ksmonkey123/8bit_computer/8bit_computer_notes/Special Registers.md

| Address  | Function |
| --- | --- |
| `0x5000` | Interrupt signals devices 1-8  |
| `0x5001` | Interrupt signals devices 9-16 |
| `0x5002` | Interrupt masks devices 1-8 |
| `0x5003` | Interrupt masks devices 9-16 |
