ksmonkey123/8bit_computer/8bit_computer_notes/Halt Flag.md

The _Halt Flag_ $F_H$ is a special [[Status Flag]] flag in the [[Step Sequencer]] that is set during the write cycle when indicated by the current [[Action Selector]].

It suspends the [[Main Clock]] and can only be cleared by a full [[System Reset]].
