ksmonkey123/8bit_computer/8bit_computer_notes/Physical 16-Bit Register Control Bus.md

The physical bus controlling the operation of the 16-bit registers.

| Pin | Function |
| ----: | --- |
| 1 | $\overline{readPC_L}$ |
| 2 | $\overline{readPC_H}$ |
| 3 | $\overline{readSP_L}$ |
| 4 | $\overline{readSP_H}$ |
| 5 | $\overline{readPC}$ |
| 6 | $\overline{readSP}$ |
| 7 | $writePC$ |
| 8 | $writeSP$ |
| 9 | $\overline{readIncR}$ |
| 10 | [[Increment Unit]] decrement mode |
| 11 | [[Increment Unit]] offset mode |
| 12 | $writeIPC$ |
| 13 | $\overline{readIPC_L}$ |
| 14 | $\overline{readIPC_H}$ |
| 15-16 | N/C |
