ksmonkey123/8bit_computer/8bit_computer_notes/Physical 8-Bit Register Control Bus.md

The physical bus controlling operation of the 1-byte registers.

| Pin | Function |
| ---:| --- |
| 1 | $\overline{readA}$ |
| 2 | $\overline{readB}$ |
| 3 | $\overline{readC}$ |
| 4 | $\overline{readD}$ |
| 5 | $\overline{readL_1}$ |
| 6 | $\overline{readL_2}$ |
| 7 | $writeA$ |
| 8 | $writeB$ |
| 9 | $writeC$ |
| 10  | $writeD$ |
| 11  | $writeL_1$ |
| 12  | $writeL_2$ |
| 13  | $\overline{adrCD}$ |
| 14  | $\overline{adrL}$  |
| 15,16| N/C |
