ksmonkey123/8bit_computer/8bit_computer_notes/Program Counter.md

The program counter is a special 16-bit register on the [[Address Bus]]. It is referenced as $PC$.

It is used to hold the memory address of the next [[Instruction]].

Both 8-bit halves of the program counter can be read on the [[Data Bus]].
In this case the lower half is referenced as $PC_L$. The upper half is called $PC_H$.

>[!important]
>Upon [[System Reset]], the program counter **must** be reset to 0
