ksmonkey123/8bit_computer/8bit_computer_notes/Status Flag.md

A status flag is a 1-bit value providing some limited information about the status of the system. This information can also influence the behaviour of some [[Instruction|Instructions]].

The computer contains 4 status flags:
* $F_C$ [[Carry Flag]]
* $F_Z$ [[Sign Flags|Zero Flag]]
* $F_S$ [[Sign Flags|Sign Flag]] (Also called _minus flag_)
* $F_H$ [[Halt Flag]]

The flags cannot be manually updated nor explicitly read as register values. They are only accessible by the [[Instruction Decoder]] (and in the case of the carry flag to the [[ALU]]).
