ksmonkey123/8bit_computer/instruction set map.xlsx

 | 0 | 1 | 2 | 3 | 4 | 5 | 6 | 7 | 8 | 9 | a | b | c | d | e | f
0 | ADC B | AND B | XOR B | DEC A | RLC |  | MOV A A | MOV A (i16) | MOV (i16) A | MOV AB AB |  | BCC i16 |  |  |  | *INTERRUPT
1 | ADC C | AND C | XOR C | DEC B | RLD |  | MOV A B | MOV B (i16) | MOV (i16) B | MOV AB CD |  | BCS i16 |  |  |  | EXINT
2 | ADC D | AND D | XOR D | DEC C | RRC |  | MOV A C | MOV C (i16) | MOV (i16) C | MOV CD AB |  | BEZ i16 |  |  |  | NOINT
3 | ADC i8 | AND i8 | XOR i8 | DEC D | RRD |  | MOV A D | MOV D (i16) | MOV (i16) D | MOV CD CD |  | BNZ i16 |  |  |  | ENINT
4 | ADC (i16) | AND (i16) | XOR (i16) | INC A | RRA |  | MOV B A | MOV A (CD + i8) | MOV (CD + i8) A | MOV AB (i16) |  | BLZ i16 |  |  |  | SIV
5 | ADC (CD + i8) | AND (CD + i8) | XOR (CD + i8) | INC B |  |  | MOV B B | MOV B (CD + i8) | MOV (CD + i8) B | MOV CD (i16) |  | BGZ i16
6 | ADC (SP + i8) | AND (SP + i8) | XOR (SP + i8) | INC C |  |  | MOV B C | MOV C (CD + i8) | MOV (CD + i8) C | MOV AB (CD + i8) |  | BNP i16
7 |  |  |  | INC D |  |  | MOV B D | MOV D (CD + i8) | MOV (CD + i8) D | MOV CD (CD + i8) |  | BNN i16
8 | SBC B | IOR B | CMP B | NEG A | SWP B |  | MOV C A | MOV A (SP + i8) | MOV (SP + i8) A | MOV AB (SP + i8) |  | JMP i16
9 | SBC C | IOR C | CMP C | NEG B | SWP C |  | MOV C B | MOV B (SP + i8) | MOV (SP + i8) B | MOV CD (SP + i8)
a | SBC D | IOR D | CMP D | NEG C | SWP D |  | MOV C C | MOV C (SP + i8) | MOV (SP + i8) C | MOV AB i16 |  | JSR i16
b | SBC i8 | IOR i8 | CMP i8 | NEG D | SWP (i16) |  | MOV C D | MOV D (SP + i8) | MOV (SP + i8) D | MOV CD i16 |  | RET
c | SBC (i16) | IOR (i16) | CMP (i16) | NOT A | SWP (CD + i8) |  | MOV D A | MOV A i8 | MOV (i16) AB | MOV (CD + i8) AB |  |  |  |  |  | CFC
d | SBC (CD + i8) | IOR (CD + i8) | CMP (CD + i8) | NOT B | SWP (SP + i8) |  | MOV D B | MOV B i8 | MOV (i16) CD | MOV (CD + i8) CD |  |  |  |  |  | CFS
e | SBC (SP + i8) | IOR (SP + i8) | CMP (SP + i8) | NOT C |  |  | MOV D C | MOV C i8 | SPA i8 | MOV (SP + i8) AB |  |  |  |  |  | NOP
f |  |  |  | NOT D |  |  | MOV D D | MOV D i8 | SPF i8 | MOV (SP + i8) CD |  |  |  |  |  | HLT
