ksmonkey123/8bit_computer/8bit_computer_notes/Instruction Decoder.md

The _Instruction Decoder_ is responsible for accepting [[Microcode]] parameters and converting them into dedicated physical control lines.

This also includes making sure, that write commands are only sent when the [[Main Clock]] is high.

#stub
