ksmonkey123/8bit_computer/8bit_computer_notes/Instruction Register.md

The _Instruction Register_ ($IR$) is a special 8-bit register.

It can be written to from the [[Data Bus]] only through dedicated control signals from the [[Step Sequencer]].

It is written to during step 0 of the [[Execution Cycle]].

The value of the register is passed to the [[Microcode#Microcode ROM|Microcode ROM]].

>[!Important]
>
>Writes to the instruction register should be double buffered to ensure that the microcode ROM addressing only changes at the transition between steps.
