ksmonkey123/8bit_computer/(list of files, drawings)

Other design files:
pc_simulation.circ
sequencer_test.circ
