ksmonkey123/8bit_computer/circuits/pc-12_sequencer/sequencer.kicad_pcb

## KiCad design circuits/pc-12_sequencer/sequencer.kicad_pcb (2025-11-24)

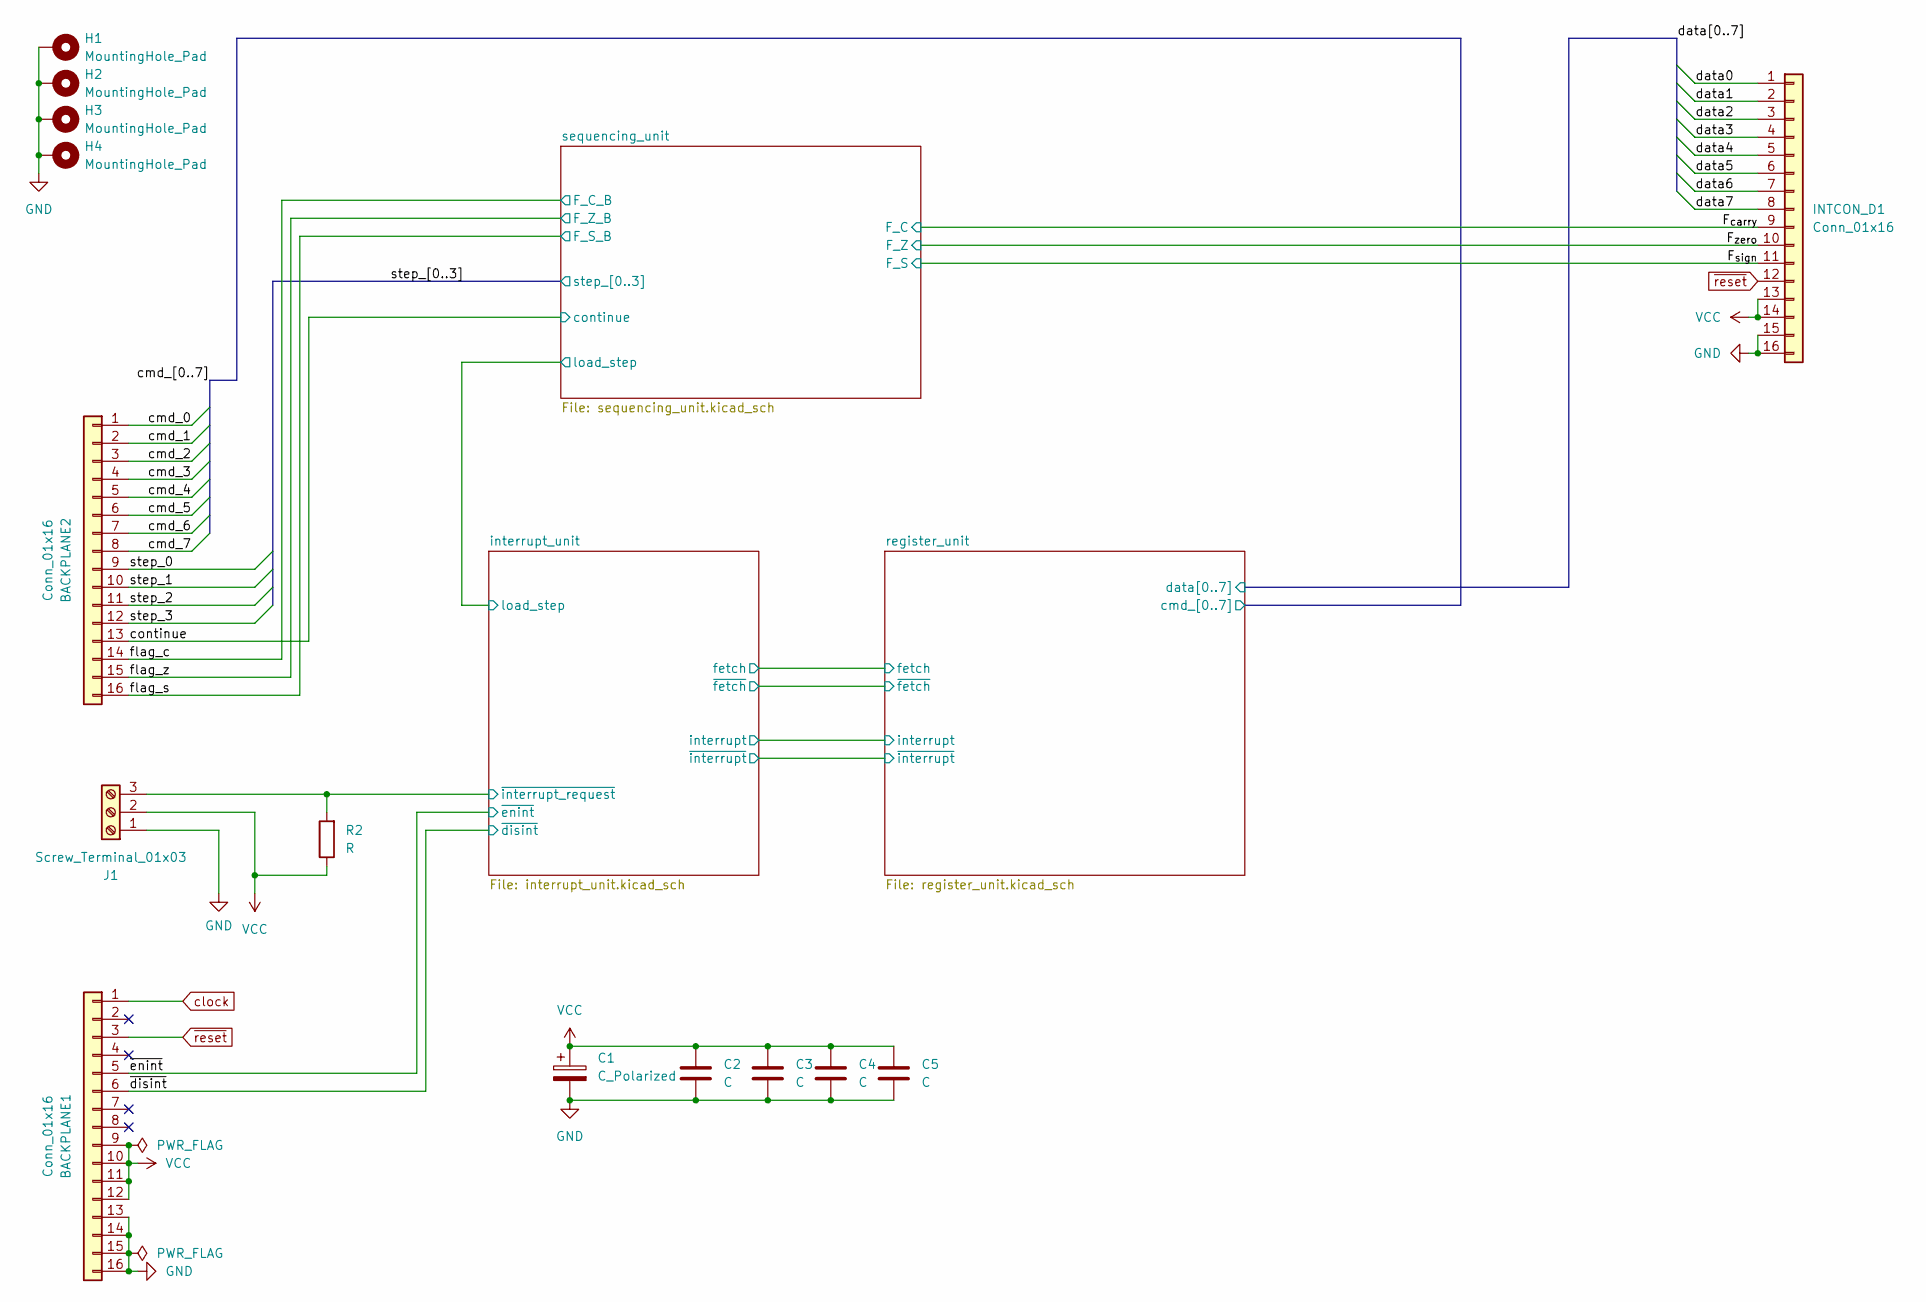
[picture p1: schematic sequencer.kicad_sch, PC-12 Sequencer and Instruction Register]

Parts:
BACKPLANE1, BACKPLANE2: Conn_01x16; IDC-Header_2x08_P2.54mm_Horizontal
C1: C_Polarized; CP_Elec_5x5.3
C2, C3, C4, C5: C; C_0603_1608Metric
H1, H2, H3, H4: MountingHole_Pad; MountingHole_3.2mm_M3_Pad_Via
INTCON_D1: Conn_01x16; IDC-Header_2x08_P2.54mm_Horizontal
J1: Screw_Terminal_01x03; TerminalBlock_Xinya_XY308-2.54-3P_1x03_P2.54mm_Horizontal
R2: R; R_0603_1608Metric

Connections:
/F_{carry}: INTCON_D1.9; also elsewhere on the board
/F_{sign}: INTCON_D1.11; also elsewhere on the board
/F_{zero}: INTCON_D1.10; also elsewhere on the board
/cmd_0: BACKPLANE2.1; also elsewhere on the board
/cmd_1: BACKPLANE2.2; also elsewhere on the board
/cmd_2: BACKPLANE2.3; also elsewhere on the board
/cmd_3: BACKPLANE2.4; also elsewhere on the board
/cmd_4: BACKPLANE2.5; also elsewhere on the board
/cmd_5: BACKPLANE2.6; also elsewhere on the board
/cmd_6: BACKPLANE2.7; also elsewhere on the board
/cmd_7: BACKPLANE2.8; also elsewhere on the board
/continue: BACKPLANE2.13; also elsewhere on the board
/data0: INTCON_D1.1; also elsewhere on the board
/data1: INTCON_D1.2; also elsewhere on the board
/data2: INTCON_D1.3; also elsewhere on the board
/data3: INTCON_D1.4; also elsewhere on the board
/data4: INTCON_D1.5; also elsewhere on the board
/data5: INTCON_D1.6; also elsewhere on the board
/data6: INTCON_D1.7; also elsewhere on the board
/data7: INTCON_D1.8; also elsewhere on the board
/flag_c: BACKPLANE2.14; also elsewhere on the board
/flag_s: BACKPLANE2.16; also elsewhere on the board
/flag_z: BACKPLANE2.15; also elsewhere on the board
/interrupt_unit/~interrupt_request: J1.3, R2.2; also elsewhere on the board
/step_0: BACKPLANE2.9; also elsewhere on the board
/step_1: BACKPLANE2.10; also elsewhere on the board
/step_2: BACKPLANE2.11; also elsewhere on the board
/step_3: BACKPLANE2.12; also elsewhere on the board
/~disint: BACKPLANE1.6; also elsewhere on the board
/~enint: BACKPLANE1.5; also elsewhere on the board
GND: BACKPLANE1.13, BACKPLANE1.14, BACKPLANE1.15, BACKPLANE1.16, C1.2, C2.2, C3.2, C4.2, C5.2, H1.1, H2.1, H3.1, H4.1, INTCON_D1.15, INTCON_D1.16, J1.1; also elsewhere on the board
VCC: BACKPLANE1.9, BACKPLANE1.10, BACKPLANE1.11, BACKPLANE1.12, C1.1, C2.1, C3.1, C4.1, C5.1, INTCON_D1.13, INTCON_D1.14, J1.2, R2.1; also elsewhere on the board
clock: BACKPLANE1.1; also elsewhere on the board
~reset: BACKPLANE1.3, INTCON_D1.12; also elsewhere on the board

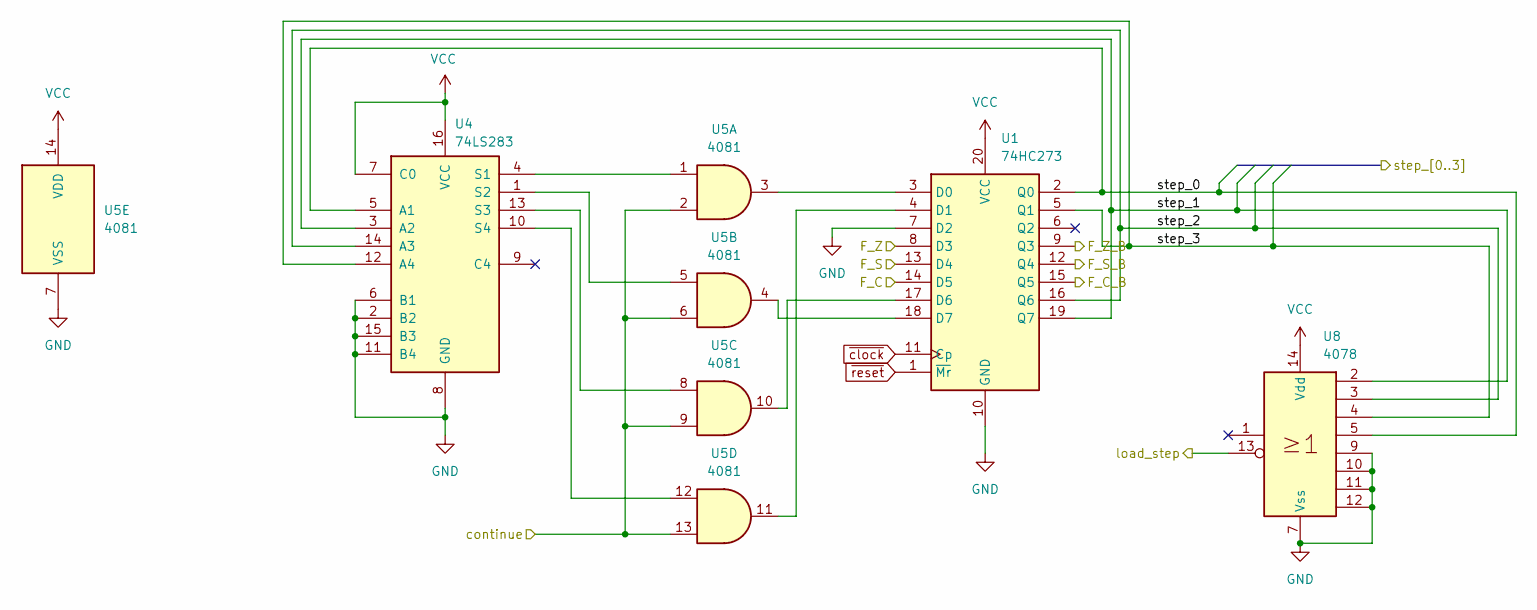
[picture p2: schematic sequencing_unit.kicad_sch, PC-12 Sequencer and Instruction Register]

Parts:
U1: 74HC273; DIP-20_W7.62mm
U4: 74LS283; DIP-16_W7.62mm
U5: 4081; DIP-14_W7.62mm
U8: 4078; DIP-14_W7.62mm

Connections:
/F_{carry}: U1.14 (D5); also elsewhere on the board
/F_{sign}: U1.13 (D4); also elsewhere on the board
/F_{zero}: U1.8 (D3); also elsewhere on the board
/continue: U5.2, U5.6, U5.9, U5.13; also elsewhere on the board
/flag_c: U1.15 (Q5); also elsewhere on the board
/flag_s: U1.12 (Q4); also elsewhere on the board
/flag_z: U1.9 (Q3); also elsewhere on the board
/interrupt_unit/load_step: U8.13; also elsewhere on the board
/step_0: U1.2 (Q0), U4.5 (A1), U8.5; also elsewhere on the board
/step_1: U1.19 (Q7), U4.3 (A2), U8.2; also elsewhere on the board
/step_2: U1.16 (Q6), U4.14 (A3), U8.3; also elsewhere on the board
/step_3: U1.5 (Q1), U4.12 (A4), U8.4; also elsewhere on the board
GND: U1.7 (D2), U1.10 (GND), U4.2 (B2), U4.6 (B1), U4.8 (GND), U4.11 (B4), U4.15 (B3), U5.7 (VSS), U8.7 (Vss), U8.9, U8.10, U8.11, U8.12; also elsewhere on the board
unnamed: U1.3 (D0), U5.3
unnamed: U1.4 (D1), U5.11
unnamed: U1.17 (D6), U5.10
unnamed: U1.18 (D7), U5.4
unnamed: U4.4 (S1), U5.1
unnamed: U4.1 (S2), U5.5
unnamed: U4.13 (S3), U5.8
unnamed: U4.10 (S4), U5.12
VCC: U1.20 (VCC), U4.7 (C0), U4.16 (VCC), U5.14 (VDD), U8.14 (Vdd); also elsewhere on the board
~clock: U1.11 (Cp); also elsewhere on the board
~reset: U1.1 (~Mr); also elsewhere on the board

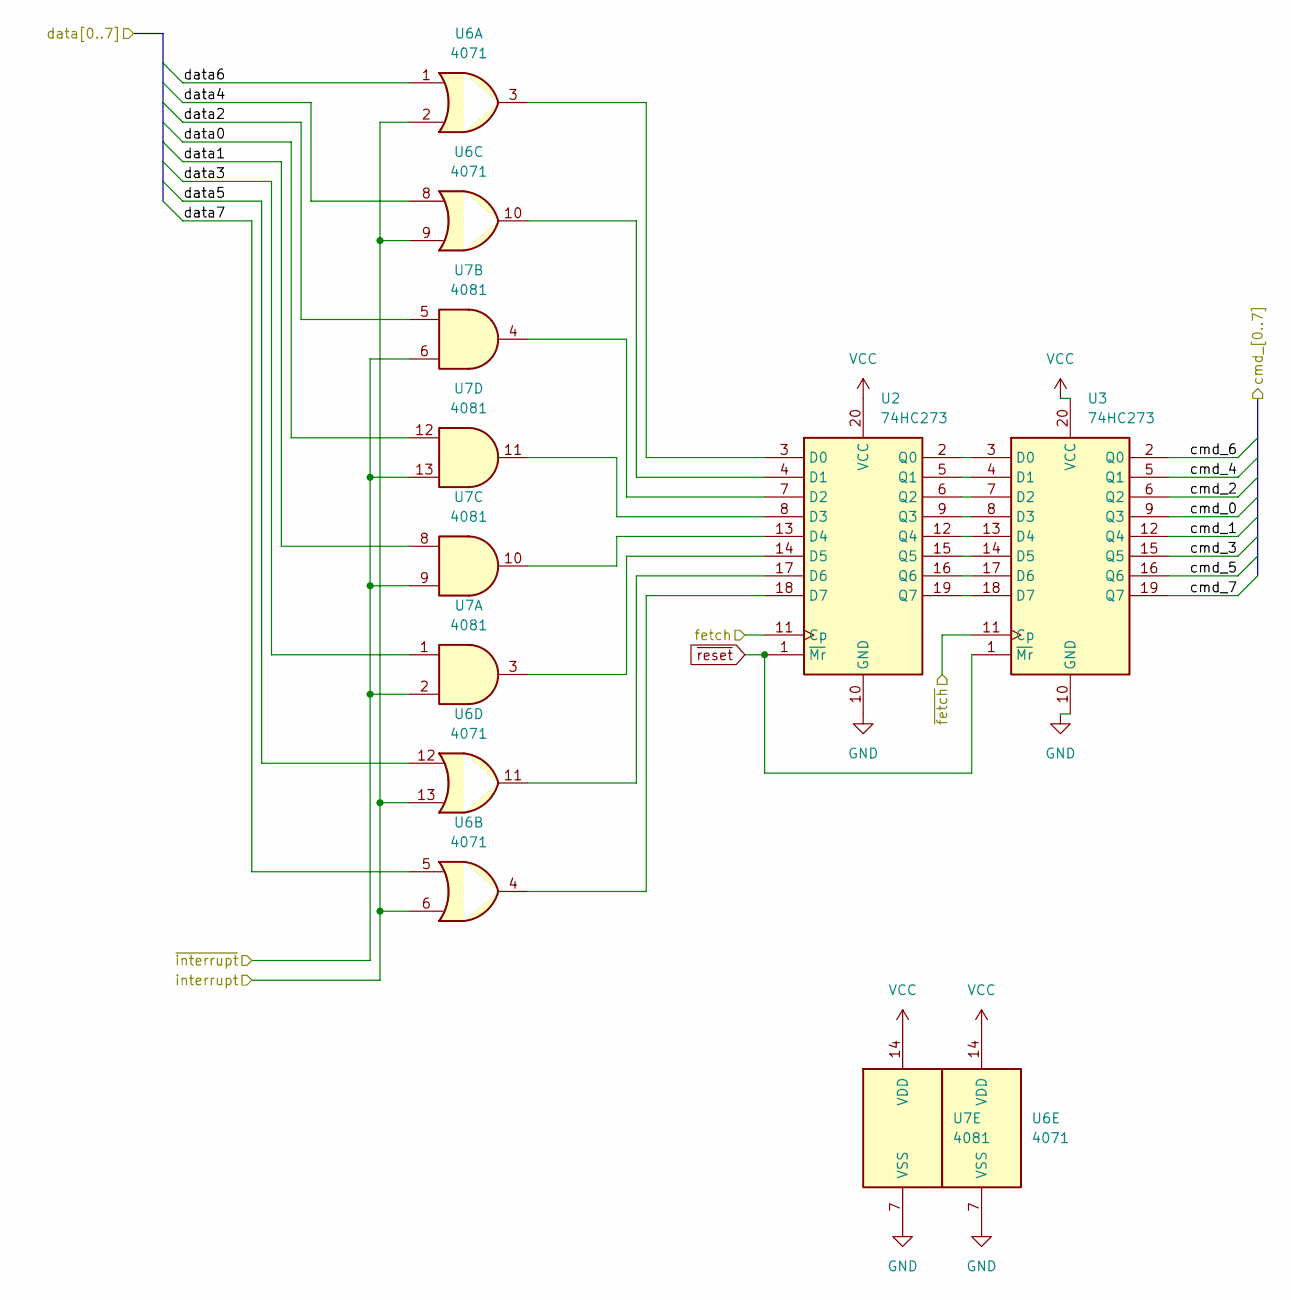
[picture p3: schematic register_unit.kicad_sch, PC-12 Sequencer and Instruction Register]

Parts:
U2, U3: 74HC273; DIP-20_W7.62mm
U6: 4071; DIP-14_W7.62mm
U7: 4081; DIP-14_W7.62mm

Connections:
/cmd_0: U3.9 (Q3); also elsewhere on the board
/cmd_1: U3.12 (Q4); also elsewhere on the board
/cmd_2: U3.6 (Q2); also elsewhere on the board
/cmd_3: U3.15 (Q5); also elsewhere on the board
/cmd_4: U3.5 (Q1); also elsewhere on the board
/cmd_5: U3.16 (Q6); also elsewhere on the board
/cmd_6: U3.2 (Q0); also elsewhere on the board
/cmd_7: U3.19 (Q7); also elsewhere on the board
/data0: U7.12; also elsewhere on the board
/data1: U7.8; also elsewhere on the board
/data2: U7.5; also elsewhere on the board
/data3: U7.1; also elsewhere on the board
/data4: U6.8; also elsewhere on the board
/data5: U6.12; also elsewhere on the board
/data6: U6.1; also elsewhere on the board
/data7: U6.5; also elsewhere on the board
/interrupt_unit/fetch: U2.11 (Cp); also elsewhere on the board
/interrupt_unit/interrupt: U6.2, U6.6, U6.9, U6.13; also elsewhere on the board
/interrupt_unit/~fetch: U3.11 (Cp); also elsewhere on the board
/interrupt_unit/~interrupt: U7.2, U7.6, U7.9, U7.13; also elsewhere on the board
GND: U2.10 (GND), U3.10 (GND), U6.7 (VSS), U7.7 (VSS); also elsewhere on the board
unnamed: U2.3 (D0), U6.3
unnamed: U2.4 (D1), U6.10
unnamed: U2.7 (D2), U7.4
unnamed: U2.8 (D3), U7.11
unnamed: U2.13 (D4), U7.10
unnamed: U2.14 (D5), U7.3
unnamed: U2.17 (D6), U6.11
unnamed: U2.18 (D7), U6.4
unnamed: U2.2 (Q0), U3.3 (D0)
unnamed: U2.5 (Q1), U3.4 (D1)
unnamed: U2.6 (Q2), U3.7 (D2)
unnamed: U2.9 (Q3), U3.8 (D3)
unnamed: U2.12 (Q4), U3.13 (D4)
unnamed: U2.15 (Q5), U3.14 (D5)
unnamed: U2.16 (Q6), U3.17 (D6)
unnamed: U2.19 (Q7), U3.18 (D7)
VCC: U2.20 (VCC), U3.20 (VCC), U6.14 (VDD), U7.14 (VDD); also elsewhere on the board
~reset: U2.1 (~Mr), U3.1 (~Mr); also elsewhere on the board

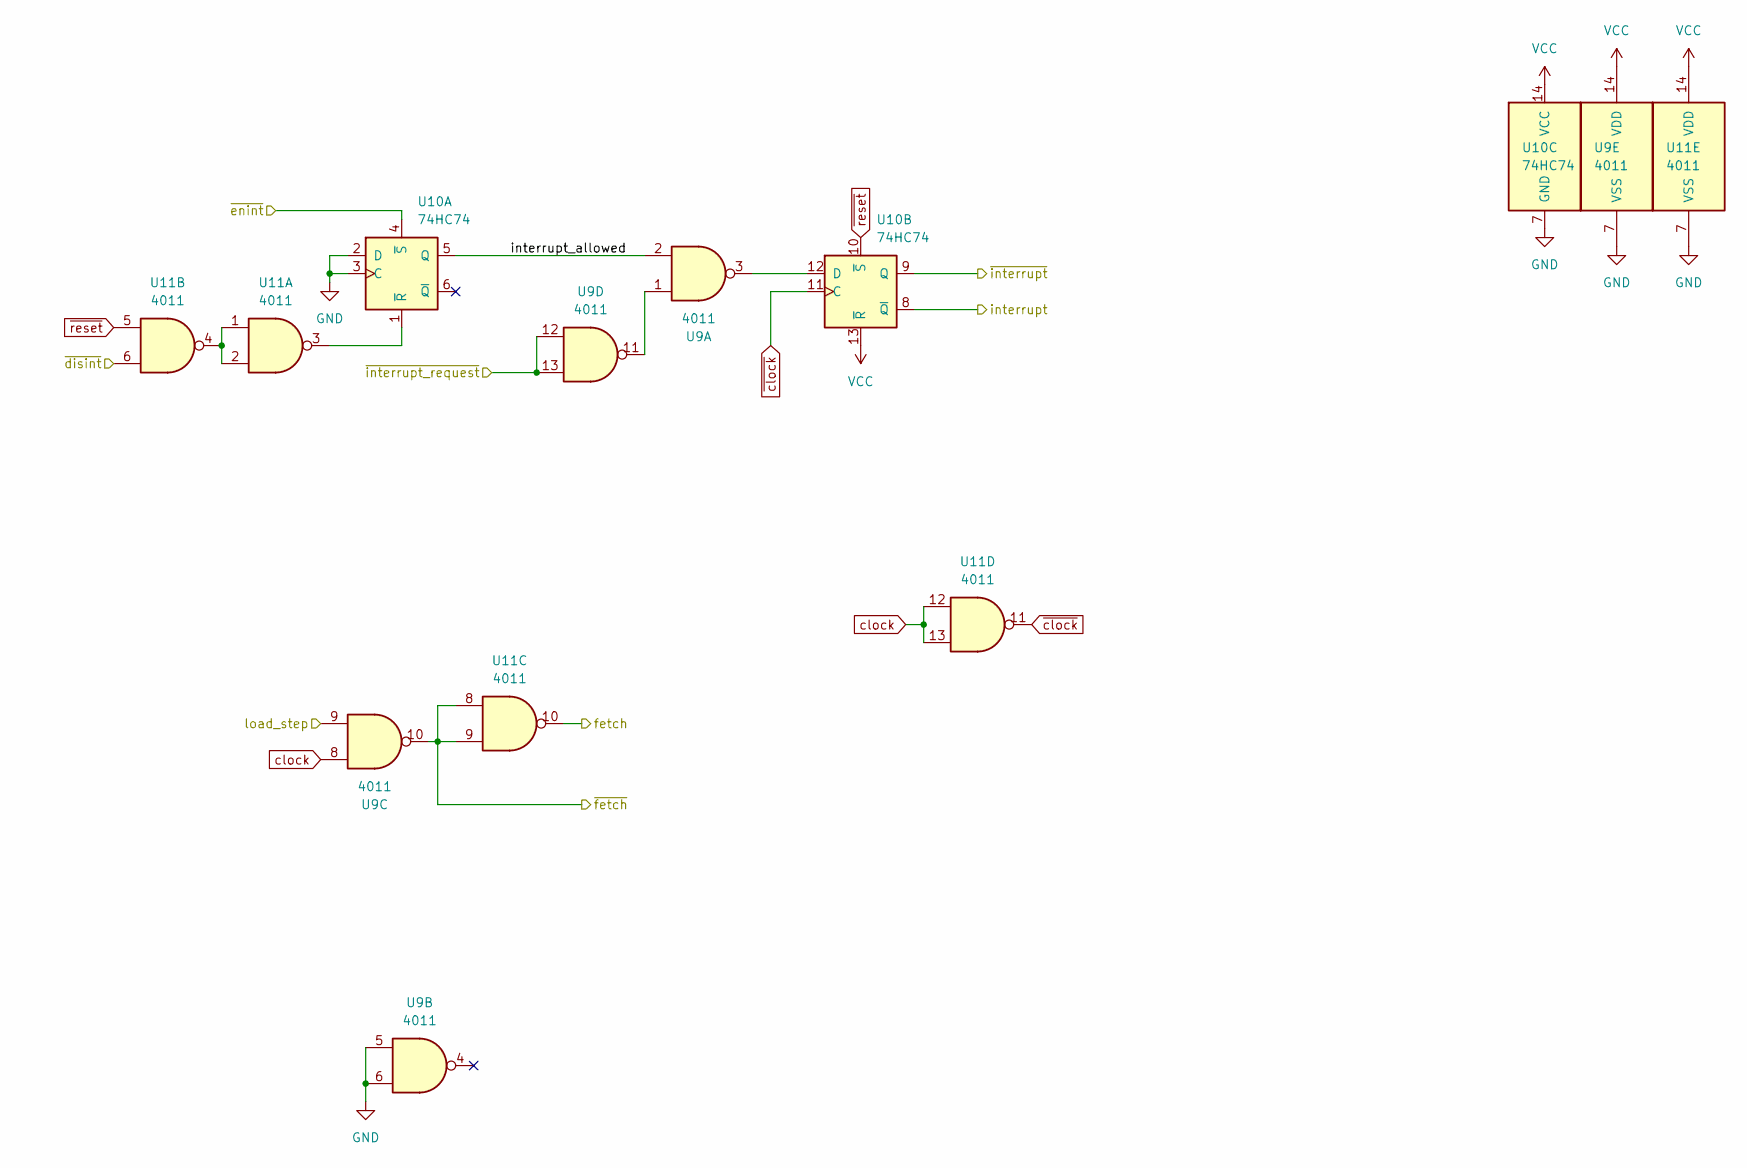
[picture p4: schematic interrupt_unit.kicad_sch, PC-12 Sequencer and Instruction Register]

Parts:
U9, U11: 4011; DIP-14_W7.62mm
U10: 74HC74; DIP-14_W7.62mm

Connections:
/interrupt_unit/fetch: U11.10; also elsewhere on the board
/interrupt_unit/interrupt: U10.8 (~Q); also elsewhere on the board
/interrupt_unit/interrupt_allowed: U9.2, U10.5 (Q)
/interrupt_unit/load_step: U9.9; also elsewhere on the board
/interrupt_unit/~fetch: U9.10, U11.8, U11.9; also elsewhere on the board
/interrupt_unit/~interrupt_request: U9.12, U9.13; also elsewhere on the board
/interrupt_unit/~interrupt: U10.9 (Q); also elsewhere on the board
/~disint: U11.6; also elsewhere on the board
/~enint: U10.4 (~S); also elsewhere on the board
GND: U9.5, U9.6, U9.7 (VSS), U10.2 (D), U10.3 (C), U10.7 (GND), U11.7 (VSS); also elsewhere on the board
unnamed: U9.1, U9.11
unnamed: U10.1 (~R), U11.3
unnamed: U9.3, U10.12 (D)
unnamed: U11.1, U11.2, U11.4
VCC: U9.14 (VDD), U10.13 (~R), U10.14 (VCC), U11.14 (VDD); also elsewhere on the board
clock: U9.8, U11.12, U11.13; also elsewhere on the board
~clock: U10.11 (C), U11.11; also elsewhere on the board
~reset: U10.10 (~S), U11.5; also elsewhere on the board

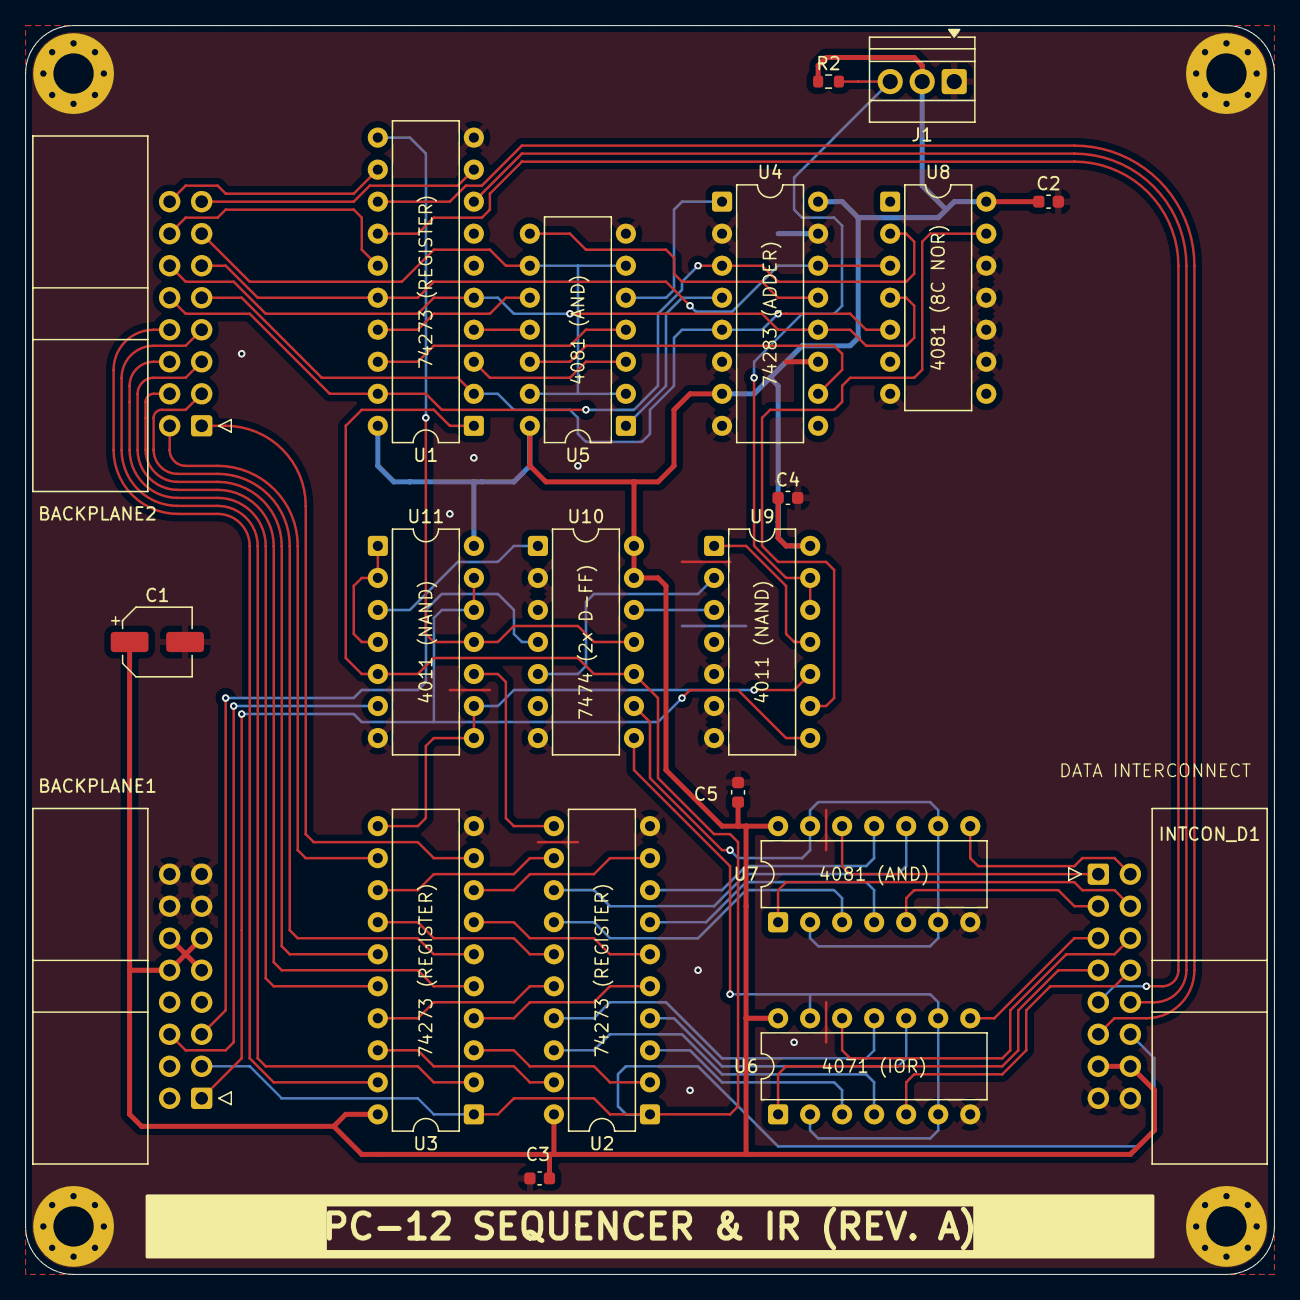
[picture p5: board sequencer.kicad_pcb from above]

Board: 2 copper layers, 99.1 x 99.1 mm, 25 parts (0 on the bottom side), 69 nets.
