ksmonkey123/8bit_computer/circuits/pc-02_16bit_register/16bit_register.kicad_pcb

## KiCad design circuits/pc-02_16bit_register/16bit_register.kicad_pcb (2025-11-22)

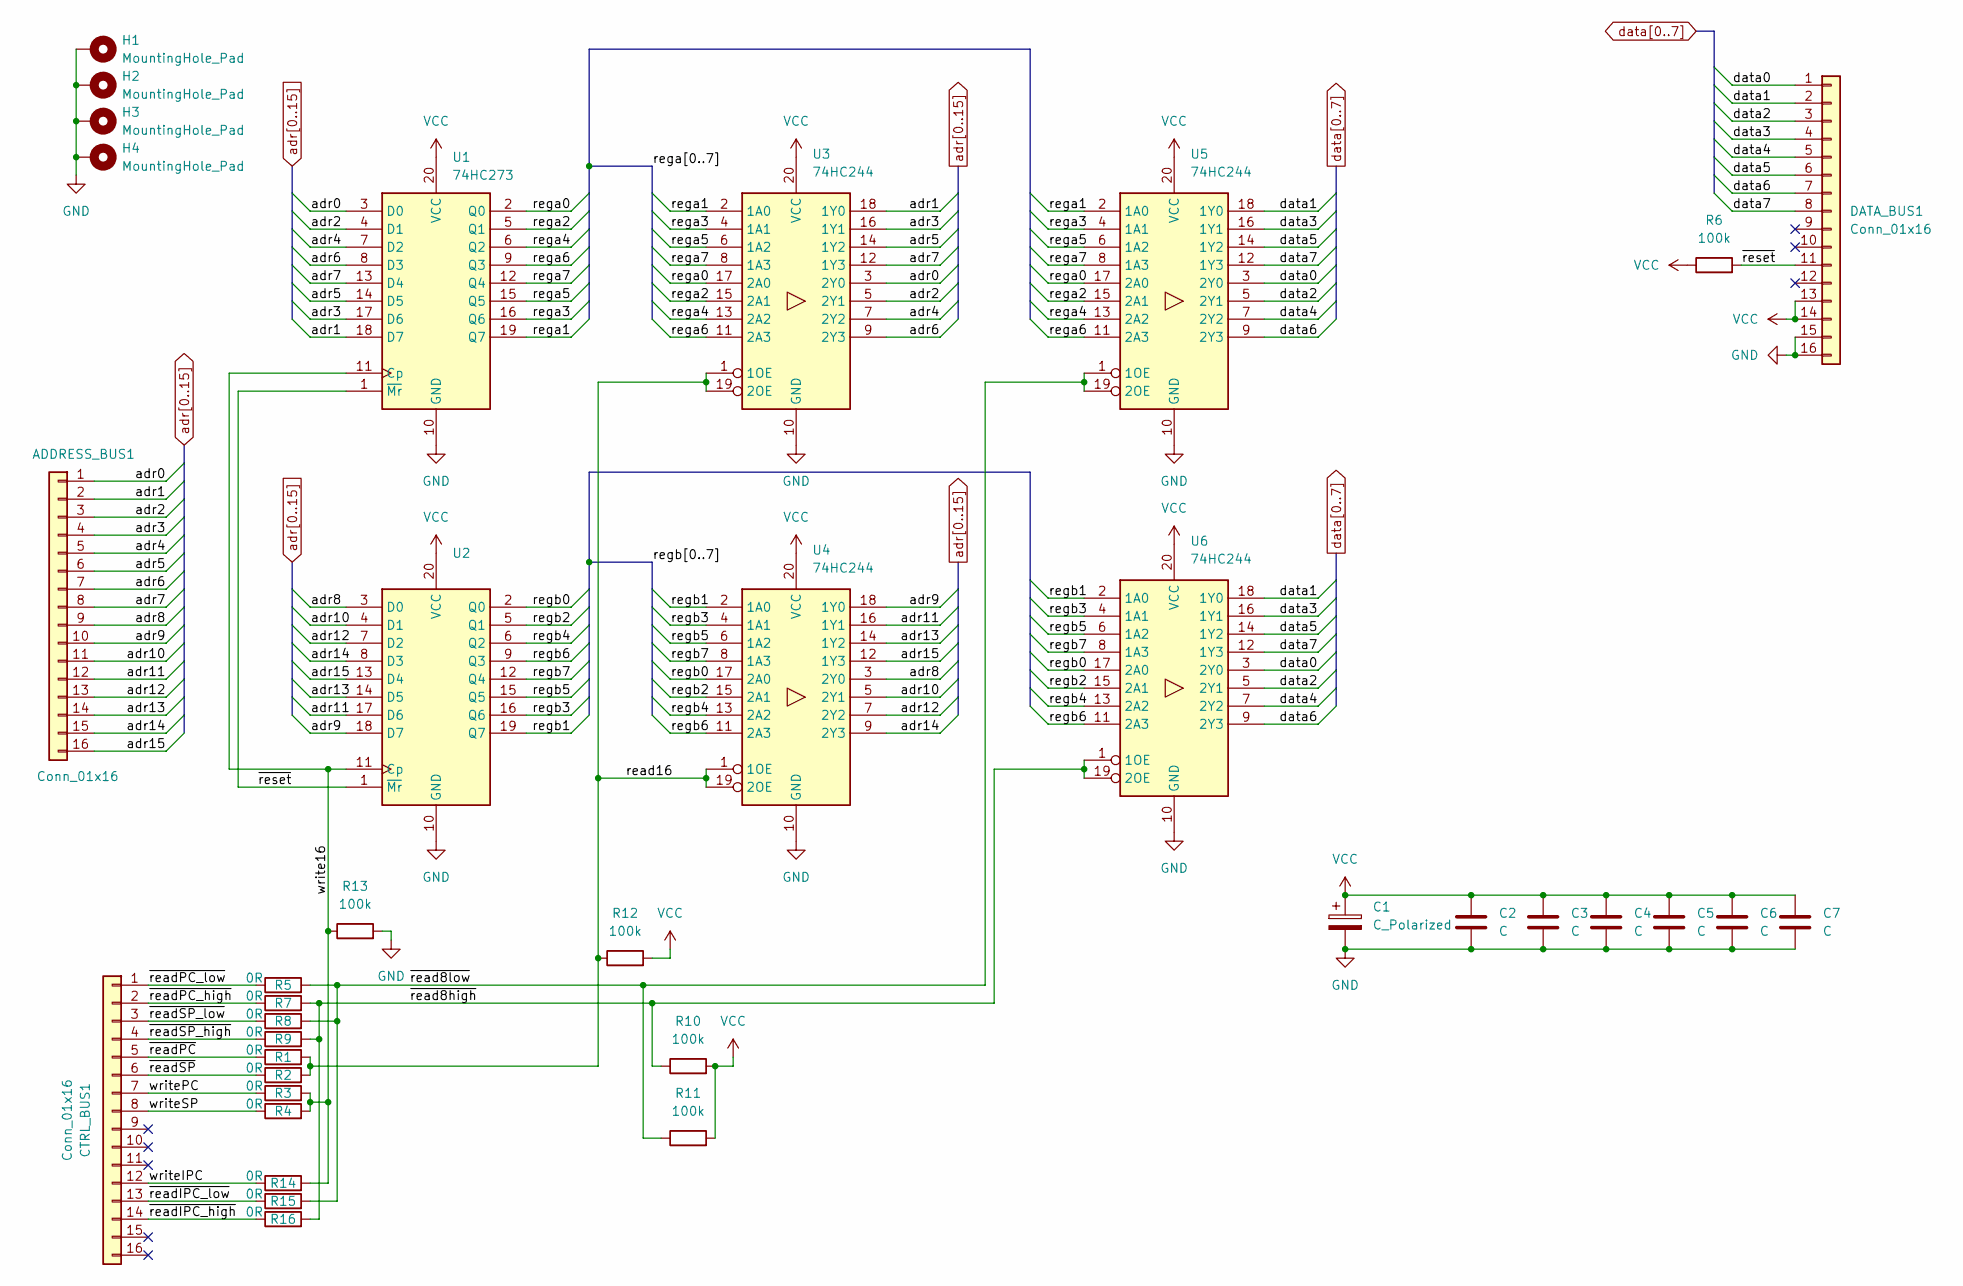
[picture p6: schematic 16bit_register.kicad_sch, PC-02 16Bit Register Unit]

Parts:
ADDRESS_BUS1: Conn_01x16; IDC-Header_2x08_P2.54mm_Horizontal
C1: C_Polarized; CP_Elec_5x5.3
C2, C3, C4, C5, C6, C7: C; C_0603_1608Metric
CTRL_BUS1: Conn_01x16; IDC-Header_2x08_P2.54mm_Horizontal
DATA_BUS1: Conn_01x16; IDC-Header_2x08_P2.54mm_Horizontal
H1, H2, H3, H4: MountingHole_Pad; MountingHole_3.2mm_M3_Pad_Via
R1, R2, R3, R4, R5, R7, R8, R9, R14, R15, R16: 0R; R_0603_1608Metric
R6, R10, R11, R12, R13: 100k; R_0603_1608Metric
U1, U2: 74HC273; DIP-20_W7.62mm_LongPads
U3, U4, U5, U6: 74HC244; DIP-20_W7.62mm_LongPads

Connections:
/read16: R1.2, R2.2, R12.1, U3.1 (1OE), U3.19 (2OE), U4.1 (1OE), U4.19 (2OE)
/rega0: U1.2 (Q0), U3.17 (2A0), U5.17 (2A0)
/rega1: U1.19 (Q7), U3.2 (1A0), U5.2 (1A0)
/rega2: U1.5 (Q1), U3.15 (2A1), U5.15 (2A1)
/rega3: U1.16 (Q6), U3.4 (1A1), U5.4 (1A1)
/rega4: U1.6 (Q2), U3.13 (2A2), U5.13 (2A2)
/rega5: U1.15 (Q5), U3.6 (1A2), U5.6 (1A2)
/rega6: U1.9 (Q3), U3.11 (2A3), U5.11 (2A3)
/rega7: U1.12 (Q4), U3.8 (1A3), U5.8 (1A3)
/regb0: U2.2 (Q0), U4.17 (2A0), U6.17 (2A0)
/regb1: U2.19 (Q7), U4.2 (1A0), U6.2 (1A0)
/regb2: U2.5 (Q1), U4.15 (2A1), U6.15 (2A1)
/regb3: U2.16 (Q6), U4.4 (1A1), U6.4 (1A1)
/regb4: U2.6 (Q2), U4.13 (2A2), U6.13 (2A2)
/regb5: U2.15 (Q5), U4.6 (1A2), U6.6 (1A2)
/regb6: U2.9 (Q3), U4.11 (2A3), U6.11 (2A3)
/regb7: U2.12 (Q4), U4.8 (1A3), U6.8 (1A3)
/write16: R3.2, R4.2, R13.1, R14.2, U1.11 (Cp), U2.11 (Cp)
/writeIPC: CTRL_BUS1.12, R14.1
/writePC: CTRL_BUS1.7, R3.1
/writeSP: CTRL_BUS1.8, R4.1
/~read8high: R7.2, R9.2, R10.1, R16.2, U6.1 (1OE), U6.19 (2OE)
/~read8low: R5.2, R8.2, R11.1, R15.2, U5.1 (1OE), U5.19 (2OE)
/~readIPC_high: CTRL_BUS1.14, R16.1
/~readIPC_low: CTRL_BUS1.13, R15.1
/~readPC_high: CTRL_BUS1.2, R7.1
/~readPC_low: CTRL_BUS1.1, R5.1
/~readPC: CTRL_BUS1.5, R1.1
/~readSP_high: CTRL_BUS1.4, R9.1
/~readSP_low: CTRL_BUS1.3, R8.1
/~readSP: CTRL_BUS1.6, R2.1
/~reset: DATA_BUS1.11, R6.2, U1.1 (~Mr), U2.1 (~Mr)
GND: C1.2, C2.2, C3.2, C4.2, C5.2, C6.2, C7.2, DATA_BUS1.15, DATA_BUS1.16, H1.1, H2.1, H3.1, H4.1, R13.2, U1.10 (GND), U2.10 (GND), U3.10 (GND), U4.10 (GND), U5.10 (GND), U6.10 (GND)
VCC: C1.1, C2.1, C3.1, C4.1, C5.1, C6.1, C7.1, DATA_BUS1.13, DATA_BUS1.14, R6.1, R10.2, R11.2, R12.2, U1.20 (VCC), U2.20 (VCC), U3.20 (VCC), U4.20 (VCC), U5.20 (VCC), U6.20 (VCC)
adr0: ADDRESS_BUS1.1, U1.3 (D0), U3.3 (2Y0)
adr1: ADDRESS_BUS1.2, U1.18 (D7), U3.18 (1Y0)
adr2: ADDRESS_BUS1.3, U1.4 (D1), U3.5 (2Y1)
adr3: ADDRESS_BUS1.4, U1.17 (D6), U3.16 (1Y1)
adr4: ADDRESS_BUS1.5, U1.7 (D2), U3.7 (2Y2)
adr5: ADDRESS_BUS1.6, U1.14 (D5), U3.14 (1Y2)
adr6: ADDRESS_BUS1.7, U1.8 (D3), U3.9 (2Y3)
adr7: ADDRESS_BUS1.8, U1.13 (D4), U3.12 (1Y3)
adr8: ADDRESS_BUS1.9, U2.3 (D0), U4.3 (2Y0)
adr9: ADDRESS_BUS1.10, U2.18 (D7), U4.18 (1Y0)
adr10: ADDRESS_BUS1.11, U2.4 (D1), U4.5 (2Y1)
adr11: ADDRESS_BUS1.12, U2.17 (D6), U4.16 (1Y1)
adr12: ADDRESS_BUS1.13, U2.7 (D2), U4.7 (2Y2)
adr13: ADDRESS_BUS1.14, U2.14 (D5), U4.14 (1Y2)
adr14: ADDRESS_BUS1.15, U2.8 (D3), U4.9 (2Y3)
adr15: ADDRESS_BUS1.16, U2.13 (D4), U4.12 (1Y3)
data0: DATA_BUS1.1, U5.3 (2Y0), U6.3 (2Y0)
data1: DATA_BUS1.2, U5.18 (1Y0), U6.18 (1Y0)
data2: DATA_BUS1.3, U5.5 (2Y1), U6.5 (2Y1)
data3: DATA_BUS1.4, U5.16 (1Y1), U6.16 (1Y1)
data4: DATA_BUS1.5, U5.7 (2Y2), U6.7 (2Y2)
data5: DATA_BUS1.6, U5.14 (1Y2), U6.14 (1Y2)
data6: DATA_BUS1.7, U5.9 (2Y3), U6.9 (2Y3)
data7: DATA_BUS1.8, U5.12 (1Y3), U6.12 (1Y3)

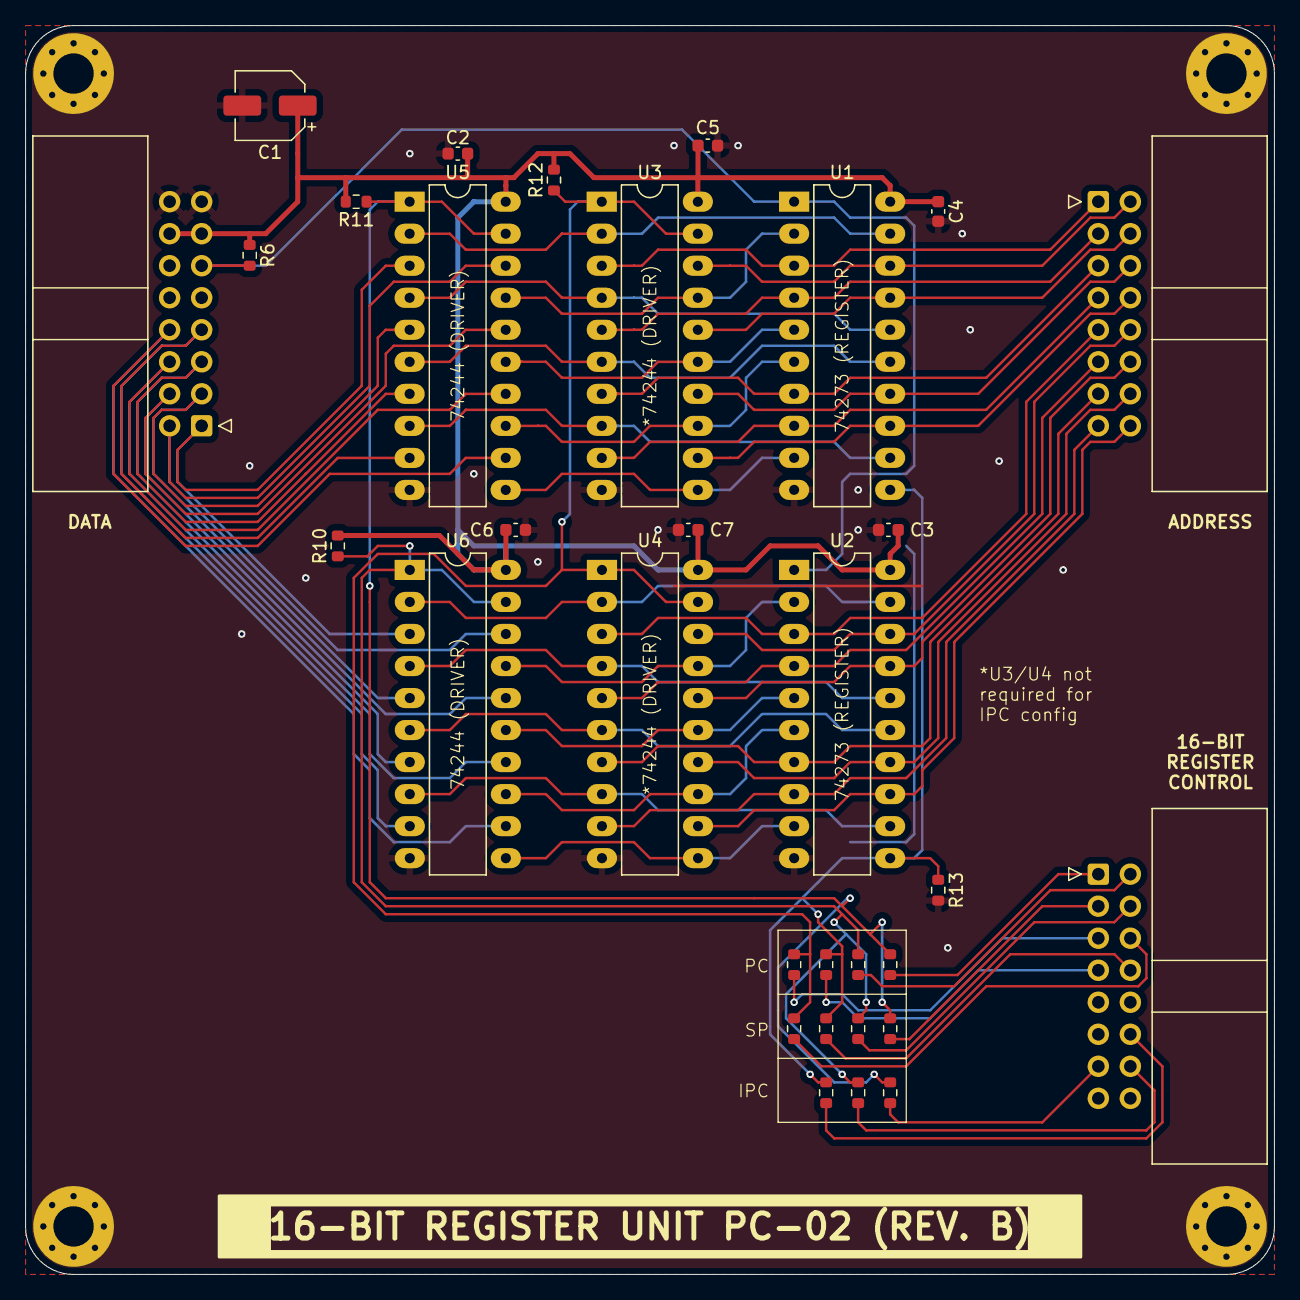
[picture p7: board 16bit_register.kicad_pcb from above]

Board: 2 copper layers, 99.1 x 99.1 mm, 36 parts (0 on the bottom side), 58 nets.
