ksmonkey123/8bit_computer/circuits/pc-03_increment_register/increment_register.kicad_pcb

## KiCad design circuits/pc-03_increment_register/increment_register.kicad_pcb (2025-11-22)

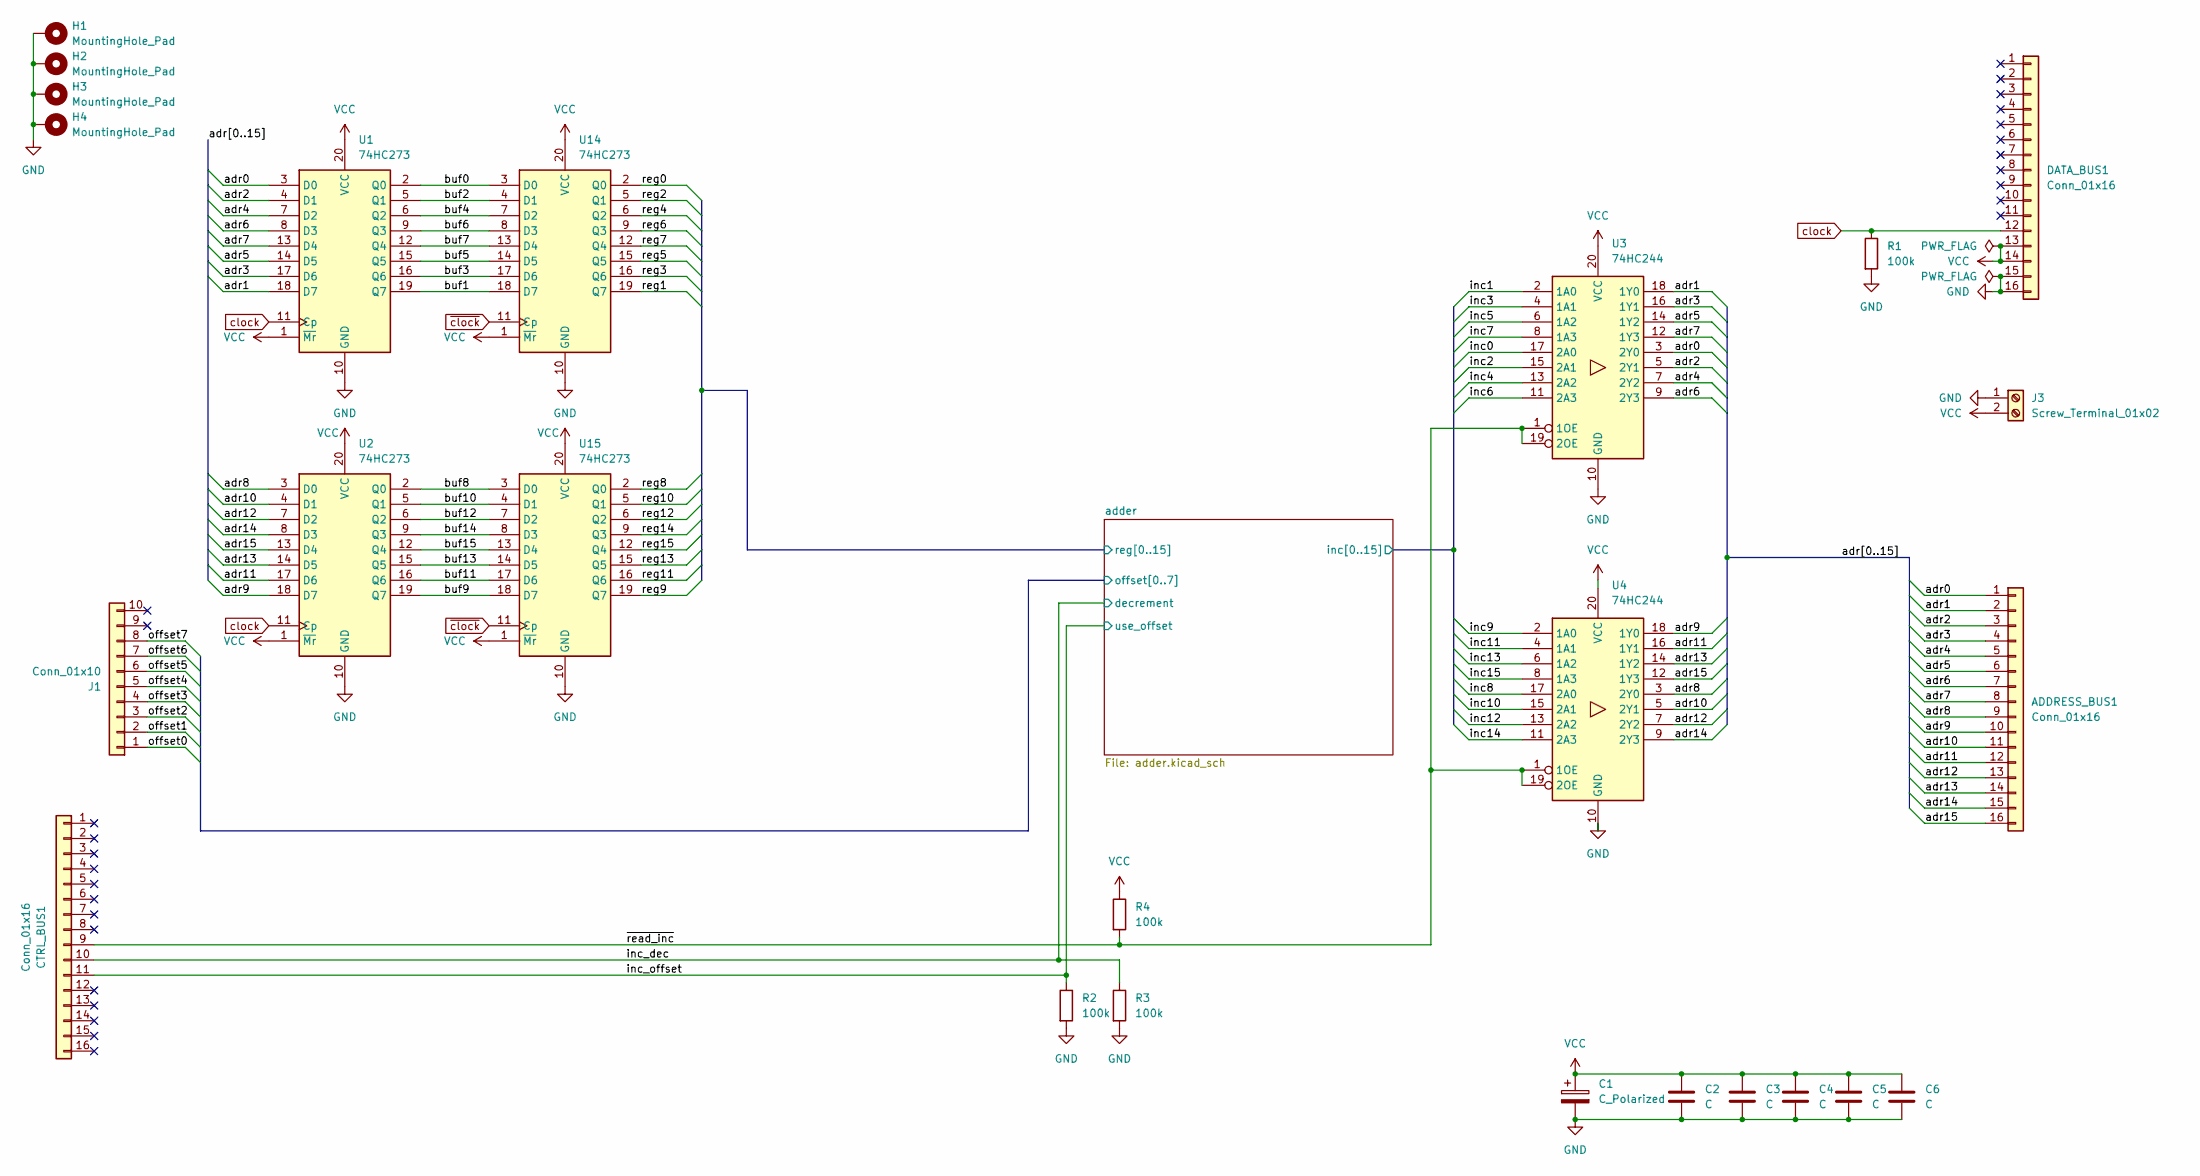
[picture p8: schematic increment_register.kicad_sch, PC-03 Increment Unit]

Parts:
ADDRESS_BUS1: Conn_01x16; IDC-Header_2x08_P2.54mm_Horizontal
C1: C_Polarized; CP_Elec_5x5.3
C2, C3, C4, C5, C6: C; C_0603_1608Metric
CTRL_BUS1: Conn_01x16; IDC-Header_2x08_P2.54mm_Horizontal
DATA_BUS1: Conn_01x16; IDC-Header_2x08_P2.54mm_Horizontal
H1, H2, H3, H4: MountingHole_Pad; MountingHole_3.2mm_M3_Pad_Via
J1: Conn_01x10; IDC-Header_2x05_P2.54mm_Horizontal
J3: Screw_Terminal_01x02; TerminalBlock_TE_282834-2_1x02_P2.54mm_Horizontal
R1, R2, R3, R4: 100k; R_0603_1608Metric
U1, U2, U14, U15: 74HC273; DIP-20_W7.62mm_LongPads
U3, U4: 74HC244; DIP-20_W7.62mm_LongPads

Connections:
/adder/inc0: U3.17 (2A0); also elsewhere on the board
/adder/inc1: U3.2 (1A0); also elsewhere on the board
/adder/inc2: U3.15 (2A1); also elsewhere on the board
/adder/inc3: U3.4 (1A1); also elsewhere on the board
/adder/inc4: U3.13 (2A2); also elsewhere on the board
/adder/inc5: U3.6 (1A2); also elsewhere on the board
/adder/inc6: U3.11 (2A3); also elsewhere on the board
/adder/inc7: U3.8 (1A3); also elsewhere on the board
/adder/inc8: U4.17 (2A0); also elsewhere on the board
/adder/inc9: U4.2 (1A0); also elsewhere on the board
/adder/inc10: U4.15 (2A1); also elsewhere on the board
/adder/inc11: U4.4 (1A1); also elsewhere on the board
/adder/inc12: U4.13 (2A2); also elsewhere on the board
/adder/inc13: U4.6 (1A2); also elsewhere on the board
/adder/inc14: U4.11 (2A3); also elsewhere on the board
/adder/inc15: U4.8 (1A3); also elsewhere on the board
/adder/offset0: J1.1; also elsewhere on the board
/adder/offset1: J1.2; also elsewhere on the board
/adder/offset2: J1.3; also elsewhere on the board
/adder/offset3: J1.4; also elsewhere on the board
/adder/offset4: J1.5; also elsewhere on the board
/adder/offset5: J1.6; also elsewhere on the board
/adder/offset6: J1.7; also elsewhere on the board
/adder/offset7: J1.8; also elsewhere on the board
/adder/reg0: U14.2 (Q0); also elsewhere on the board
/adder/reg1: U14.19 (Q7); also elsewhere on the board
/adder/reg2: U14.5 (Q1); also elsewhere on the board
/adder/reg3: U14.16 (Q6); also elsewhere on the board
/adder/reg4: U14.6 (Q2); also elsewhere on the board
/adder/reg5: U14.15 (Q5); also elsewhere on the board
/adder/reg6: U14.9 (Q3); also elsewhere on the board
/adder/reg7: U14.12 (Q4); also elsewhere on the board
/adder/reg8: U15.2 (Q0); also elsewhere on the board
/adder/reg9: U15.19 (Q7); also elsewhere on the board
/adder/reg10: U15.5 (Q1); also elsewhere on the board
/adder/reg11: U15.16 (Q6); also elsewhere on the board
/adder/reg12: U15.6 (Q2); also elsewhere on the board
/adder/reg13: U15.15 (Q5); also elsewhere on the board
/adder/reg14: U15.9 (Q3); also elsewhere on the board
/adder/reg15: U15.12 (Q4); also elsewhere on the board
/adr0: ADDRESS_BUS1.1, U1.3 (D0), U3.3 (2Y0)
/adr1: ADDRESS_BUS1.2, U1.18 (D7), U3.18 (1Y0)
/adr2: ADDRESS_BUS1.3, U1.4 (D1), U3.5 (2Y1)
/adr3: ADDRESS_BUS1.4, U1.17 (D6), U3.16 (1Y1)
/adr4: ADDRESS_BUS1.5, U1.7 (D2), U3.7 (2Y2)
/adr5: ADDRESS_BUS1.6, U1.14 (D5), U3.14 (1Y2)
/adr6: ADDRESS_BUS1.7, U1.8 (D3), U3.9 (2Y3)
/adr7: ADDRESS_BUS1.8, U1.13 (D4), U3.12 (1Y3)
/adr8: ADDRESS_BUS1.9, U2.3 (D0), U4.3 (2Y0)
/adr9: ADDRESS_BUS1.10, U2.18 (D7), U4.18 (1Y0)
/adr10: ADDRESS_BUS1.11, U2.4 (D1), U4.5 (2Y1)
/adr11: ADDRESS_BUS1.12, U2.17 (D6), U4.16 (1Y1)
/adr12: ADDRESS_BUS1.13, U2.7 (D2), U4.7 (2Y2)
/adr13: ADDRESS_BUS1.14, U2.14 (D5), U4.14 (1Y2)
/adr14: ADDRESS_BUS1.15, U2.8 (D3), U4.9 (2Y3)
/adr15: ADDRESS_BUS1.16, U2.13 (D4), U4.12 (1Y3)
/buf0: U1.2 (Q0), U14.3 (D0)
/buf1: U1.19 (Q7), U14.18 (D7)
/buf2: U1.5 (Q1), U14.4 (D1)
/buf3: U1.16 (Q6), U14.17 (D6)
/buf4: U1.6 (Q2), U14.7 (D2)
/buf5: U1.15 (Q5), U14.14 (D5)
/buf6: U1.9 (Q3), U14.8 (D3)
/buf7: U1.12 (Q4), U14.13 (D4)
/buf8: U2.2 (Q0), U15.3 (D0)
/buf9: U2.19 (Q7), U15.18 (D7)
/buf10: U2.5 (Q1), U15.4 (D1)
/buf11: U2.16 (Q6), U15.17 (D6)
/buf12: U2.6 (Q2), U15.7 (D2)
/buf13: U2.15 (Q5), U15.14 (D5)
/buf14: U2.9 (Q3), U15.8 (D3)
/buf15: U2.12 (Q4), U15.13 (D4)
/inc_dec: CTRL_BUS1.10, R3.1; also elsewhere on the board
/inc_offset: CTRL_BUS1.11, R2.1; also elsewhere on the board
/~read_inc: CTRL_BUS1.9, R4.2, U3.1 (1OE), U3.19 (2OE), U4.1 (1OE), U4.19 (2OE)
GND: C1.2, C2.2, C3.2, C4.2, C5.2, C6.2, DATA_BUS1.15, DATA_BUS1.16, H1.1, H2.1, H3.1, H4.1, J3.1, R1.2, R2.2, R3.2, U1.10 (GND), U2.10 (GND), U3.10 (GND), U4.10 (GND), U14.10 (GND), U15.10 (GND); also elsewhere on the board
VCC: C1.1, C2.1, C3.1, C4.1, C5.1, C6.1, DATA_BUS1.13, DATA_BUS1.14, J3.2, R4.1, U1.1 (~Mr), U1.20 (VCC), U2.1 (~Mr), U2.20 (VCC), U3.20 (VCC), U4.20 (VCC), U14.1 (~Mr), U14.20 (VCC), U15.1 (~Mr), U15.20 (VCC); also elsewhere on the board
clock: DATA_BUS1.12, R1.1, U1.11 (Cp), U2.11 (Cp); also elsewhere on the board
~clock: U14.11 (Cp), U15.11 (Cp); also elsewhere on the board

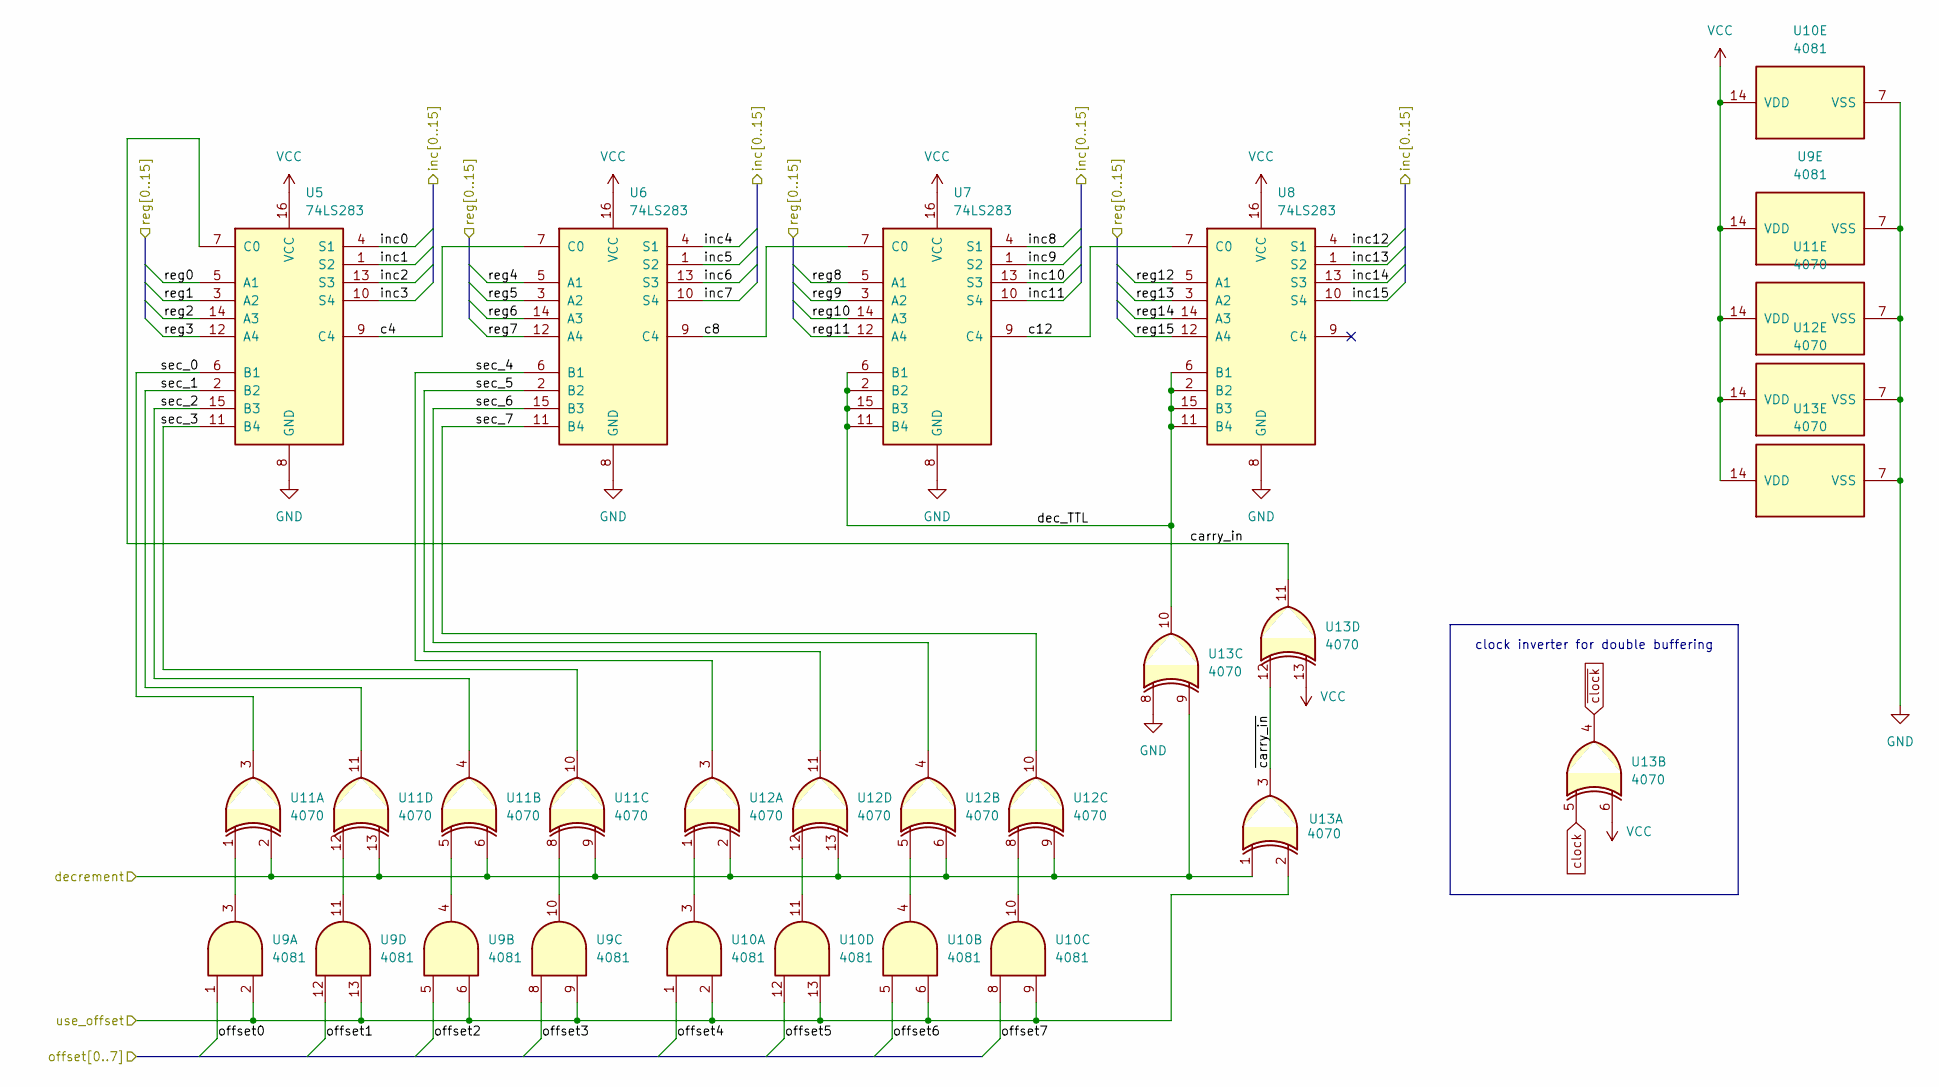
[picture p9: schematic adder.kicad_sch, PC-03 Increment Unit]

Parts:
U5, U6, U7, U8: 74LS283; DIP-16_W7.62mm_LongPads
U9, U10: 4081; DIP-14_W7.62mm_LongPads
U11, U12, U13: 4070; DIP-14_W7.62mm_LongPads

Connections:
/adder/c4: U5.9 (C4), U6.7 (C0)
/adder/c8: U6.9 (C4), U7.7 (C0)
/adder/c12: U7.9 (C4), U8.7 (C0)
/adder/carry_in: U5.7 (C0), U13.11
/adder/dec_TTL: U7.2 (B2), U7.6 (B1), U7.11 (B4), U7.15 (B3), U8.2 (B2), U8.6 (B1), U8.11 (B4), U8.15 (B3), U13.10
/adder/inc0: U5.4 (S1); also elsewhere on the board
/adder/inc1: U5.1 (S2); also elsewhere on the board
/adder/inc2: U5.13 (S3); also elsewhere on the board
/adder/inc3: U5.10 (S4); also elsewhere on the board
/adder/inc4: U6.4 (S1); also elsewhere on the board
/adder/inc5: U6.1 (S2); also elsewhere on the board
/adder/inc6: U6.13 (S3); also elsewhere on the board
/adder/inc7: U6.10 (S4); also elsewhere on the board
/adder/inc8: U7.4 (S1); also elsewhere on the board
/adder/inc9: U7.1 (S2); also elsewhere on the board
/adder/inc10: U7.13 (S3); also elsewhere on the board
/adder/inc11: U7.10 (S4); also elsewhere on the board
/adder/inc12: U8.4 (S1); also elsewhere on the board
/adder/inc13: U8.1 (S2); also elsewhere on the board
/adder/inc14: U8.13 (S3); also elsewhere on the board
/adder/inc15: U8.10 (S4); also elsewhere on the board
/adder/offset0: U9.1; also elsewhere on the board
/adder/offset1: U9.12; also elsewhere on the board
/adder/offset2: U9.5; also elsewhere on the board
/adder/offset3: U9.8; also elsewhere on the board
/adder/offset4: U10.1; also elsewhere on the board
/adder/offset5: U10.12; also elsewhere on the board
/adder/offset6: U10.5; also elsewhere on the board
/adder/offset7: U10.8; also elsewhere on the board
/adder/reg0: U5.5 (A1); also elsewhere on the board
/adder/reg1: U5.3 (A2); also elsewhere on the board
/adder/reg2: U5.14 (A3); also elsewhere on the board
/adder/reg3: U5.12 (A4); also elsewhere on the board
/adder/reg4: U6.5 (A1); also elsewhere on the board
/adder/reg5: U6.3 (A2); also elsewhere on the board
/adder/reg6: U6.14 (A3); also elsewhere on the board
/adder/reg7: U6.12 (A4); also elsewhere on the board
/adder/reg8: U7.5 (A1); also elsewhere on the board
/adder/reg9: U7.3 (A2); also elsewhere on the board
/adder/reg10: U7.14 (A3); also elsewhere on the board
/adder/reg11: U7.12 (A4); also elsewhere on the board
/adder/reg12: U8.5 (A1); also elsewhere on the board
/adder/reg13: U8.3 (A2); also elsewhere on the board
/adder/reg14: U8.14 (A3); also elsewhere on the board
/adder/reg15: U8.12 (A4); also elsewhere on the board
/adder/sec_0: U5.6 (B1), U11.3
/adder/sec_1: U5.2 (B2), U11.11
/adder/sec_2: U5.15 (B3), U11.4
/adder/sec_3: U5.11 (B4), U11.10
/adder/sec_4: U6.6 (B1), U12.3
/adder/sec_5: U6.2 (B2), U12.11
/adder/sec_6: U6.15 (B3), U12.4
/adder/sec_7: U6.11 (B4), U12.10
/adder/~carry_in: U13.3, U13.12
/inc_dec: U11.2, U11.6, U11.9, U11.13, U12.2, U12.6, U12.9, U12.13, U13.1, U13.9; also elsewhere on the board
/inc_offset: U9.2, U9.6, U9.9, U9.13, U10.2, U10.6, U10.9, U10.13, U13.2; also elsewhere on the board
GND: U5.8 (GND), U6.8 (GND), U7.8 (GND), U8.8 (GND), U9.7 (VSS), U10.7 (VSS), U11.7 (VSS), U12.7 (VSS), U13.7 (VSS), U13.8; also elsewhere on the board
unnamed: U10.3, U12.1
unnamed: U10.4, U12.5
unnamed: U10.10, U12.8
unnamed: U10.11, U12.12
unnamed: U9.3, U11.1
unnamed: U9.4, U11.5
unnamed: U9.10, U11.8
unnamed: U9.11, U11.12
VCC: U5.16 (VCC), U6.16 (VCC), U7.16 (VCC), U8.16 (VCC), U9.14 (VDD), U10.14 (VDD), U11.14 (VDD), U12.14 (VDD), U13.6, U13.13, U13.14 (VDD); also elsewhere on the board
clock: U13.5; also elsewhere on the board
~clock: U13.4; also elsewhere on the board

Notes on the sheet:
clock inverter for double buffering

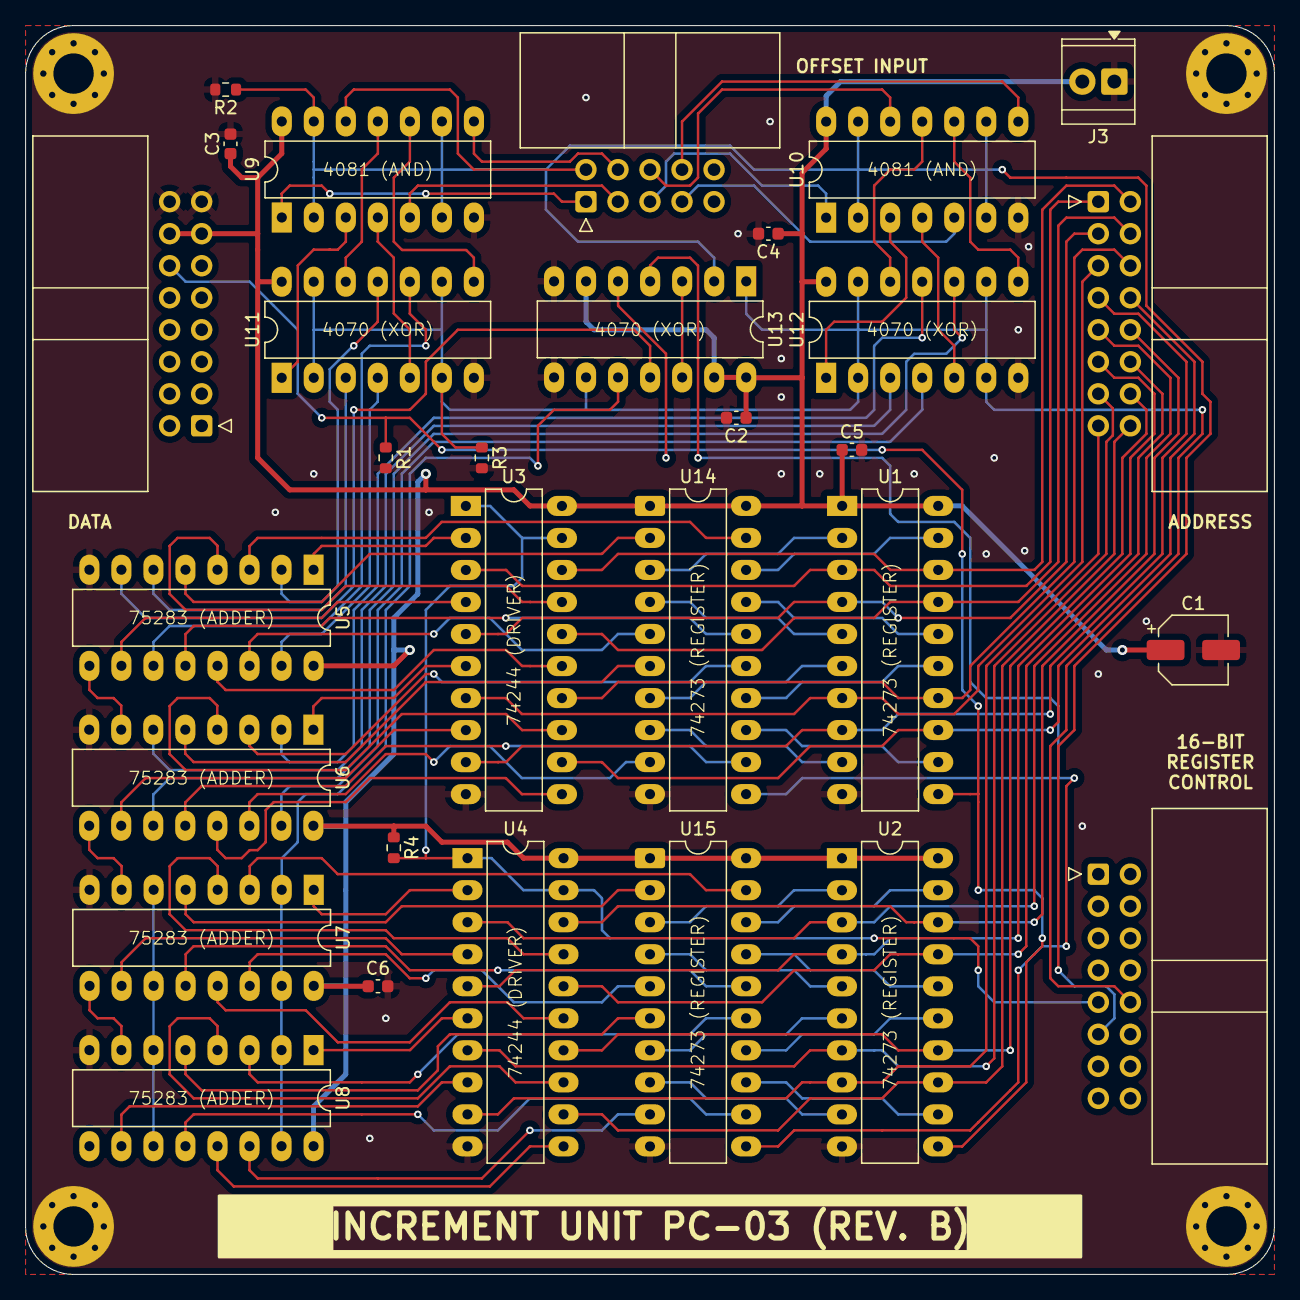
[picture p10: board increment_register.kicad_pcb from above]

Board: 2 copper layers, 99.1 x 99.1 mm, 34 parts (0 on the bottom side), 101 nets.
