ksmonkey123/8bit_computer/circuits/pc-07_ram_unit/ram_unit.kicad_pcb

## KiCad design circuits/pc-07_ram_unit/ram_unit.kicad_pcb (2025-11-22)

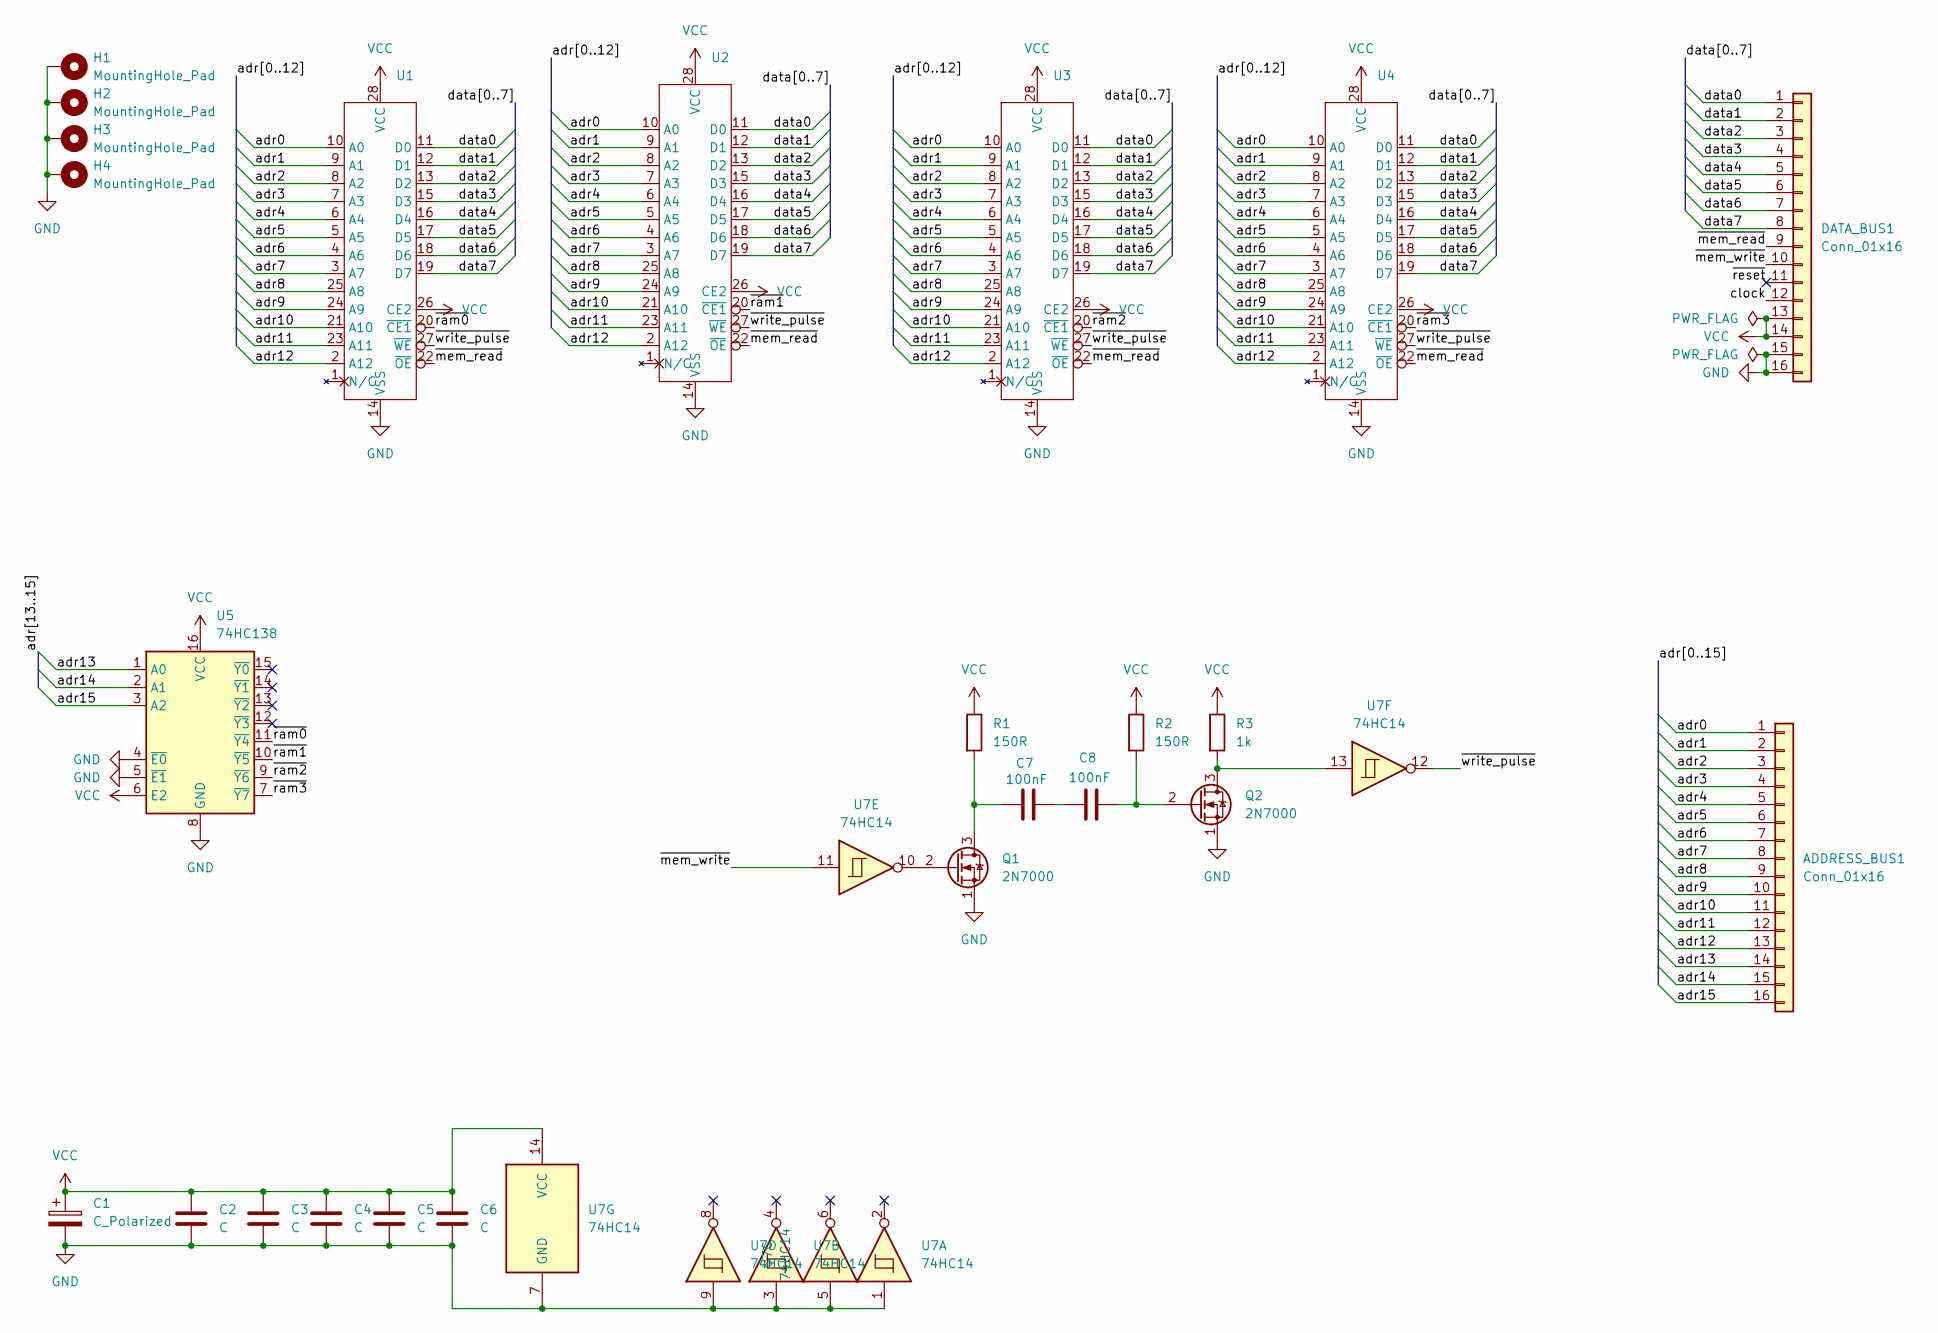
[picture p11: schematic ram_unit.kicad_sch, PC-07 RAM Module]

Parts:
ADDRESS_BUS1: Conn_01x16; IDC-Header_2x08_P2.54mm_Horizontal
C1: C_Polarized; CP_Elec_5x5.3
C2, C3, C4, C5, C6: C; C_0603_1608Metric
C7, C8: 100nF; C_0603_1608Metric
DATA_BUS1: Conn_01x16; IDC-Header_2x08_P2.54mm_Horizontal
H1, H2, H3, H4: MountingHole_Pad; MountingHole_3.2mm_M3_Pad_Via
Q1, Q2: 2N7000; TO-92_Inline_Wide
R1, R2: 150R; R_0603_1608Metric
R3: 1k; R_0603_1608Metric
U1, U2, U3, U4: DIP-28_W7.62mm_LongPads
U5: 74HC138; DIP-16_W7.62mm_LongPads
U7: 74HC14; DIP-14_W7.62mm

Connections:
/adr0: ADDRESS_BUS1.1, U1.10 (A0), U2.10 (A0), U3.10 (A0), U4.10 (A0)
/adr1: ADDRESS_BUS1.2, U1.9 (A1), U2.9 (A1), U3.9 (A1), U4.9 (A1)
/adr2: ADDRESS_BUS1.3, U1.8 (A2), U2.8 (A2), U3.8 (A2), U4.8 (A2)
/adr3: ADDRESS_BUS1.4, U1.7 (A3), U2.7 (A3), U3.7 (A3), U4.7 (A3)
/adr4: ADDRESS_BUS1.5, U1.6 (A4), U2.6 (A4), U3.6 (A4), U4.6 (A4)
/adr5: ADDRESS_BUS1.6, U1.5 (A5), U2.5 (A5), U3.5 (A5), U4.5 (A5)
/adr6: ADDRESS_BUS1.7, U1.4 (A6), U2.4 (A6), U3.4 (A6), U4.4 (A6)
/adr7: ADDRESS_BUS1.8, U1.3 (A7), U2.3 (A7), U3.3 (A7), U4.3 (A7)
/adr8: ADDRESS_BUS1.9, U1.25 (A8), U2.25 (A8), U3.25 (A8), U4.25 (A8)
/adr9: ADDRESS_BUS1.10, U1.24 (A9), U2.24 (A9), U3.24 (A9), U4.24 (A9)
/adr10: ADDRESS_BUS1.11, U1.21 (A10), U2.21 (A10), U3.21 (A10), U4.21 (A10)
/adr11: ADDRESS_BUS1.12, U1.23 (A11), U2.23 (A11), U3.23 (A11), U4.23 (A11)
/adr12: ADDRESS_BUS1.13, U1.2 (A12), U2.2 (A12), U3.2 (A12), U4.2 (A12)
/adr13: ADDRESS_BUS1.14, U5.1 (A0)
/adr14: ADDRESS_BUS1.15, U5.2 (A1)
/adr15: ADDRESS_BUS1.16, U5.3 (A2)
/clock: DATA_BUS1.12
/data0: DATA_BUS1.1, U1.11 (D0), U2.11 (D0), U3.11 (D0), U4.11 (D0)
/data1: DATA_BUS1.2, U1.12 (D1), U2.12 (D1), U3.12 (D1), U4.12 (D1)
/data2: DATA_BUS1.3, U1.13 (D2), U2.13 (D2), U3.13 (D2), U4.13 (D2)
/data3: DATA_BUS1.4, U1.15 (D3), U2.15 (D3), U3.15 (D3), U4.15 (D3)
/data4: DATA_BUS1.5, U1.16 (D4), U2.16 (D4), U3.16 (D4), U4.16 (D4)
/data5: DATA_BUS1.6, U1.17 (D5), U2.17 (D5), U3.17 (D5), U4.17 (D5)
/data6: DATA_BUS1.7, U1.18 (D6), U2.18 (D6), U3.18 (D6), U4.18 (D6)
/data7: DATA_BUS1.8, U1.19 (D7), U2.19 (D7), U3.19 (D7), U4.19 (D7)
/~mem_read: DATA_BUS1.9, U1.22 (~OE), U2.22 (~OE), U3.22 (~OE), U4.22 (~OE)
/~mem_write: DATA_BUS1.10, U7.11
/~ram0: U1.20 (~CE1), U5.11 (~Y4)
/~ram1: U2.20 (~CE1), U5.10 (~Y5)
/~ram2: U3.20 (~CE1), U5.9 (~Y6)
/~ram3: U4.20 (~CE1), U5.7 (~Y7)
/~reset: DATA_BUS1.11
/~write_pulse: U1.27 (~WE), U2.27 (~WE), U3.27 (~WE), U4.27 (~WE), U7.12
GND: C1.2, C2.2, C3.2, C4.2, C5.2, C6.2, DATA_BUS1.15, DATA_BUS1.16, H1.1, H2.1, H3.1, H4.1, Q1.1 (S), Q2.1 (S), U1.14 (VSS), U2.14 (VSS), U3.14 (VSS), U4.14 (VSS), U5.4 (~E0), U5.5 (~E1), U5.8 (GND), U7.1, U7.3, U7.5, U7.7 (GND), U7.9
unnamed: C7.2, C8.1
unnamed: C7.1, Q1.3 (D), R1.2
unnamed: Q1.2 (G), U7.10
unnamed: Q2.3 (D), R3.2, U7.13
unnamed: C8.2, Q2.2 (G), R2.2
VCC: C1.1, C2.1, C3.1, C4.1, C5.1, C6.1, DATA_BUS1.13, DATA_BUS1.14, R1.1, R2.1, R3.1, U1.26 (CE2), U1.28 (VCC), U2.26 (CE2), U2.28 (VCC), U3.26 (CE2), U3.28 (VCC), U4.26 (CE2), U4.28 (VCC), U5.6 (E2), U5.16 (VCC), U7.14 (VCC)

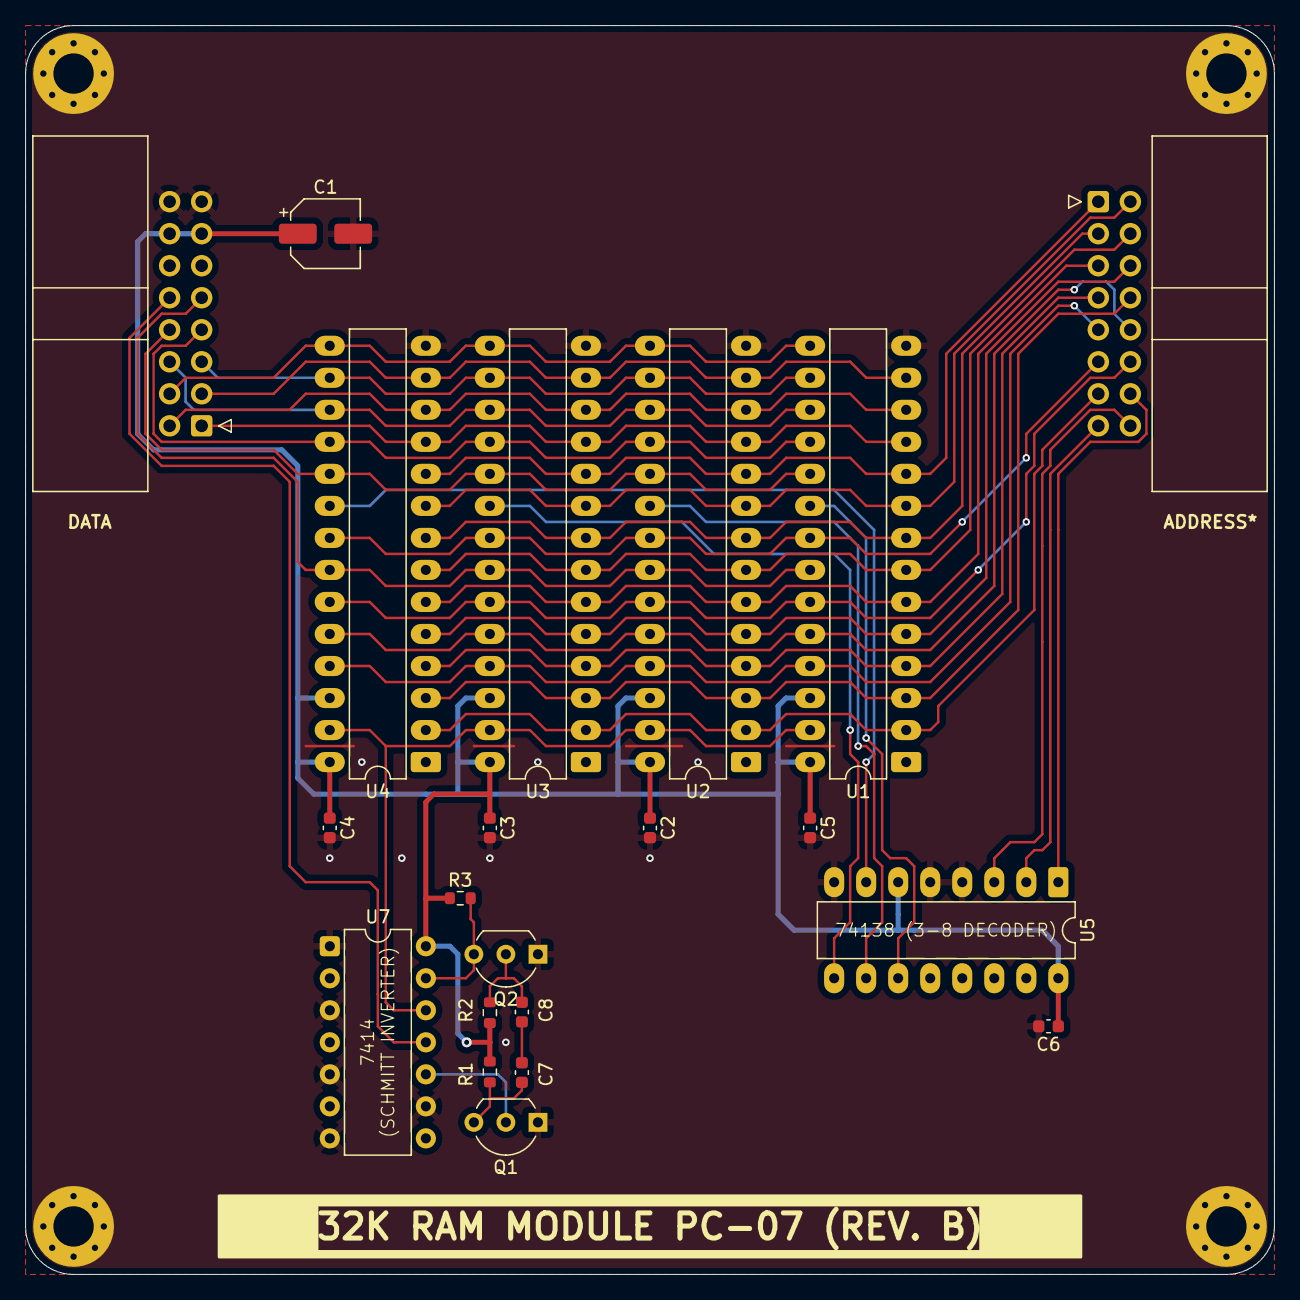
[picture p12: board ram_unit.kicad_pcb from above]

Board: 2 copper layers, 99.1 x 99.1 mm, 25 parts (0 on the bottom side), 38 nets.
