ksmonkey123/8bit_computer/circuits/pc-08_command_decoder/command_decoder.kicad_pcb

## KiCad design circuits/pc-08_command_decoder/command_decoder.kicad_pcb (2025-11-22)

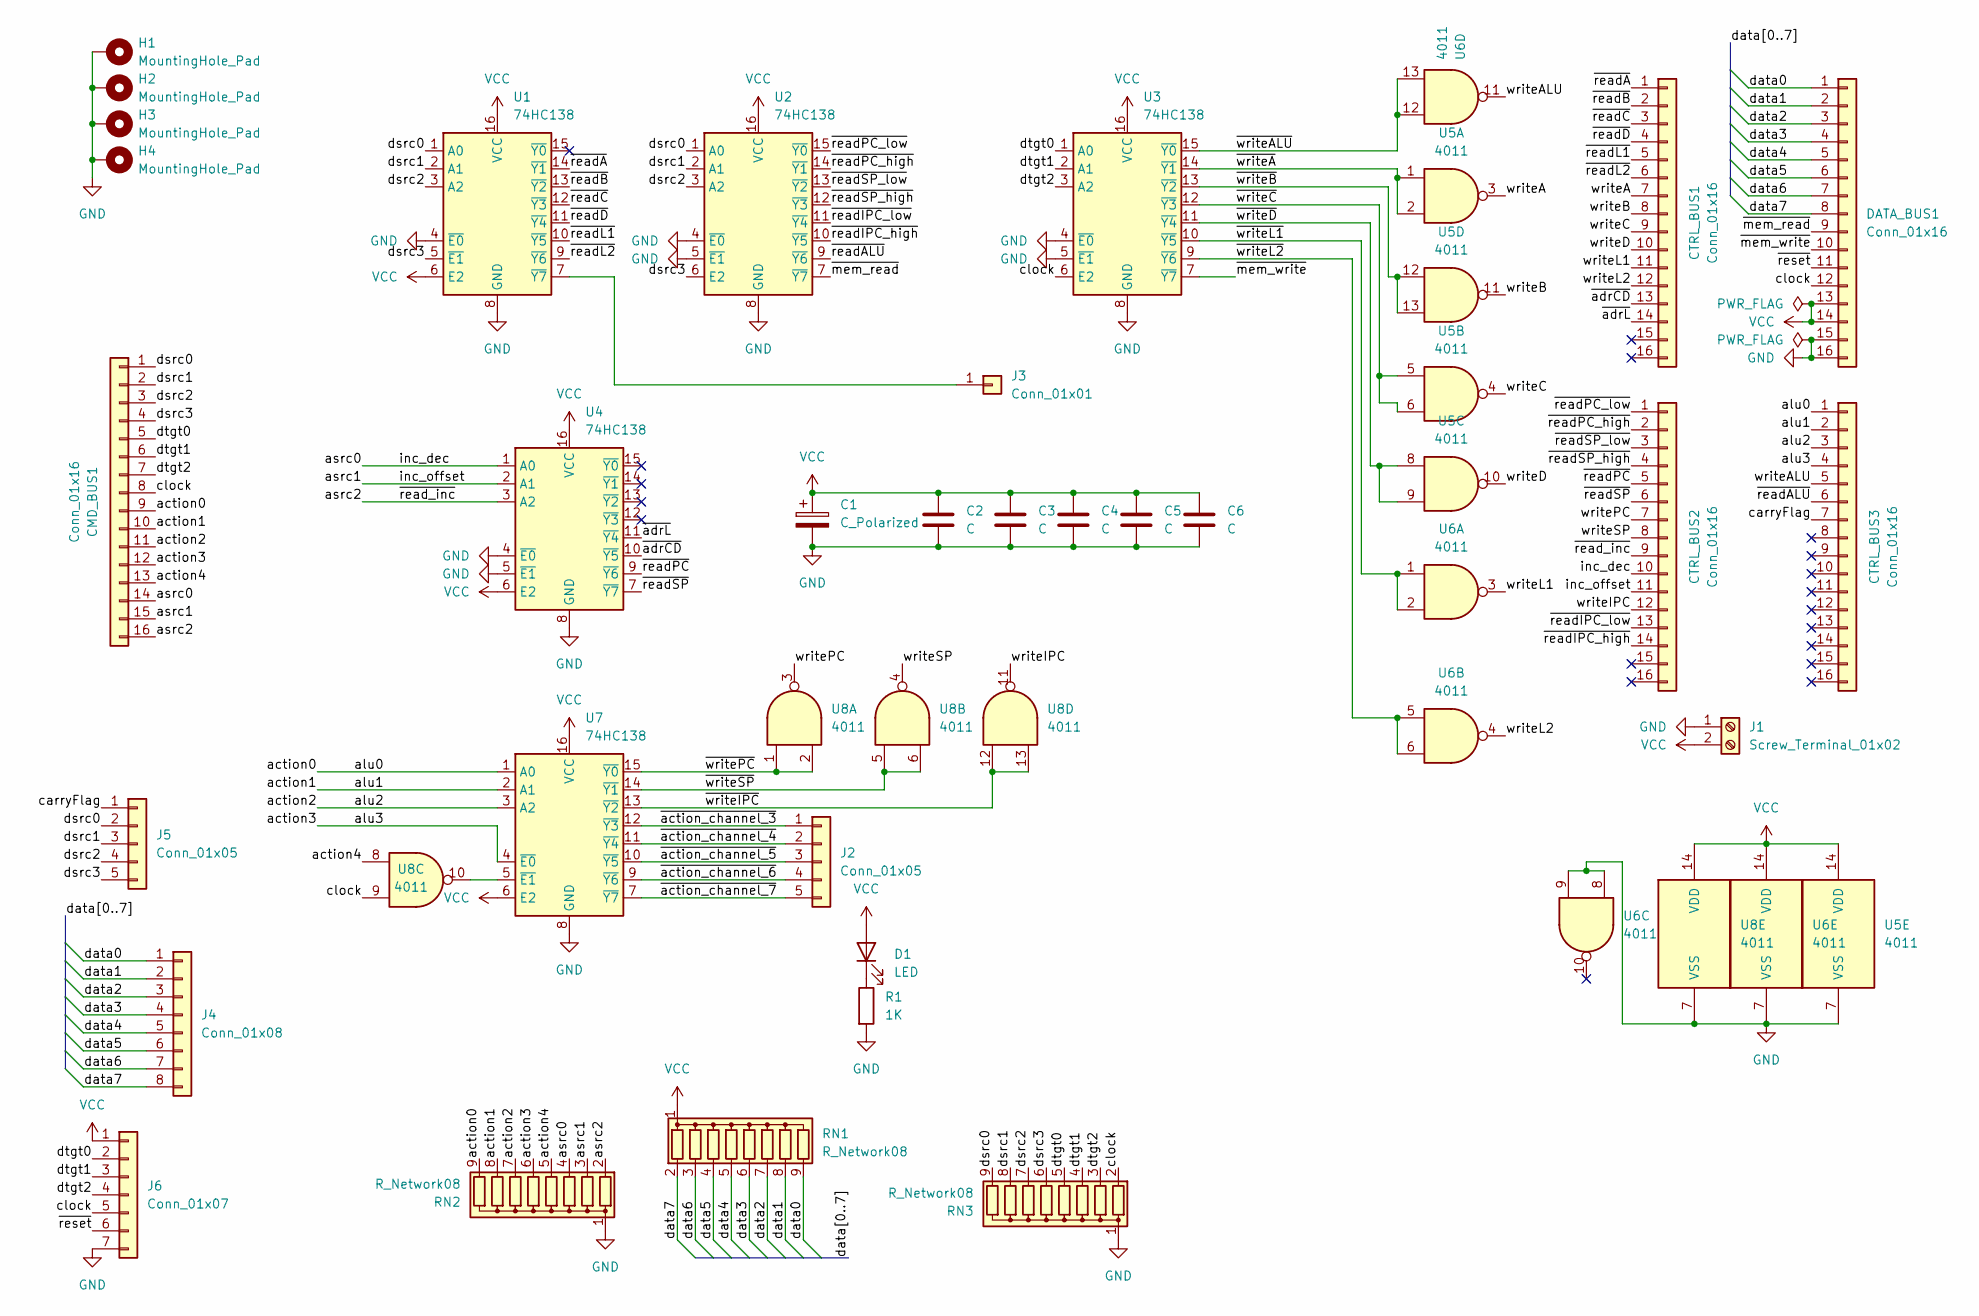
[picture p13: schematic command_decoder.kicad_sch, PC-08 Command Decoder]

Parts:
C1: C_Polarized; CP_Elec_5x5.3
C2, C3, C4, C5, C6: C; C_0603_1608Metric
CMD_BUS1: Conn_01x16; IDC-Header_2x08_P2.54mm_Horizontal
CTRL_BUS1, CTRL_BUS2, CTRL_BUS3: Conn_01x16; IDC-Header_2x08_P2.54mm_Vertical
D1: LED; LED_0603_1608Metric
DATA_BUS1: Conn_01x16; IDC-Header_2x08_P2.54mm_Horizontal
H1, H2, H3, H4: MountingHole_Pad; MountingHole_3.2mm_M3_Pad_Via
J1: Screw_Terminal_01x02; TerminalBlock_TE_282834-2_1x02_P2.54mm_Horizontal
J2, J5: Conn_01x05; PinHeader_1x05_P2.54mm_Vertical
J3: Conn_01x01; PinHeader_1x01_P2.54mm_Vertical
J4: Conn_01x08; PinHeader_1x08_P2.54mm_Vertical
J6: Conn_01x07; PinHeader_1x07_P2.54mm_Vertical
R1: 1K; R_0603_1608Metric
RN1, RN2, RN3: R_Network08; R_Array_SIP9
U1, U2, U3, U4, U7: 74HC138; DIP-16_W7.62mm_LongPads
U5, U6, U8: 4011; DIP-14_W7.62mm_LongPads

Connections:
/action0: CMD_BUS1.9, CTRL_BUS3.1, RN2.9 (R8), U7.1 (A0)
/action1: CMD_BUS1.10, CTRL_BUS3.2, RN2.8 (R7), U7.2 (A1)
/action2: CMD_BUS1.11, CTRL_BUS3.3, RN2.7 (R6), U7.3 (A2)
/action3: CMD_BUS1.12, CTRL_BUS3.4, RN2.6 (R5), U7.4 (~E0)
/action4: CMD_BUS1.13, RN2.5 (R4), U8.8
/asrc0: CMD_BUS1.14, CTRL_BUS2.10, RN2.4 (R3), U4.1 (A0)
/asrc1: CMD_BUS1.15, CTRL_BUS2.11, RN2.3 (R2), U4.2 (A1)
/asrc2: CMD_BUS1.16, CTRL_BUS2.9, RN2.2 (R1), U4.3 (A2)
/carryFlag: CTRL_BUS3.7, J5.1
/clock: CMD_BUS1.8, DATA_BUS1.12, J6.5, RN3.2 (R1), U3.6 (E2), U8.9
/data0: DATA_BUS1.1, J4.1, RN1.9 (R8)
/data1: DATA_BUS1.2, J4.2, RN1.8 (R7)
/data2: DATA_BUS1.3, J4.3, RN1.7 (R6)
/data3: DATA_BUS1.4, J4.4, RN1.6 (R5)
/data4: DATA_BUS1.5, J4.5, RN1.5 (R4)
/data5: DATA_BUS1.6, J4.6, RN1.4 (R3)
/data6: DATA_BUS1.7, J4.7, RN1.3 (R2)
/data7: DATA_BUS1.8, J4.8, RN1.2 (R1)
/dsrc0: CMD_BUS1.1, J5.2, RN3.9 (R8), U1.1 (A0), U2.1 (A0)
/dsrc1: CMD_BUS1.2, J5.3, RN3.8 (R7), U1.2 (A1), U2.2 (A1)
/dsrc2: CMD_BUS1.3, J5.4, RN3.7 (R6), U1.3 (A2), U2.3 (A2)
/dsrc3: CMD_BUS1.4, J5.5, RN3.6 (R5), U1.5 (~E1), U2.6 (E2)
/dtgt0: CMD_BUS1.5, J6.2, RN3.5 (R4), U3.1 (A0)
/dtgt1: CMD_BUS1.6, J6.3, RN3.4 (R3), U3.2 (A1)
/dtgt2: CMD_BUS1.7, J6.4, RN3.3 (R2), U3.3 (A2)
/writeA: CTRL_BUS1.7, U5.3
/writeALU: CTRL_BUS3.5, U6.11
/writeB: CTRL_BUS1.8, U5.11
/writeC: CTRL_BUS1.9, U5.4
/writeD: CTRL_BUS1.10, U5.10
/writeIPC: CTRL_BUS2.12, U8.11
/writeL1: CTRL_BUS1.11, U6.3
/writeL2: CTRL_BUS1.12, U6.4
/writePC: CTRL_BUS2.7, U8.3
/writeSP: CTRL_BUS2.8, U8.4
/~action_channel_3: J2.1, U7.12 (~Y3)
/~action_channel_4: J2.2, U7.11 (~Y4)
/~action_channel_5: J2.3, U7.10 (~Y5)
/~action_channel_6: J2.4, U7.9 (~Y6)
/~action_channel_7: J2.5, U7.7 (~Y7)
/~adrCD: CTRL_BUS1.13, U4.10 (~Y5)
/~adrL: CTRL_BUS1.14, U4.11 (~Y4)
/~mem_read: DATA_BUS1.9, U2.7 (~Y7)
/~mem_write: DATA_BUS1.10, U3.7 (~Y7)
/~readALU: CTRL_BUS3.6, U2.9 (~Y6)
/~readA: CTRL_BUS1.1, U1.14 (~Y1)
/~readB: CTRL_BUS1.2, U1.13 (~Y2)
/~readC: CTRL_BUS1.3, U1.12 (~Y3)
/~readD: CTRL_BUS1.4, U1.11 (~Y4)
/~readIPC_high: CTRL_BUS2.14, U2.10 (~Y5)
/~readIPC_low: CTRL_BUS2.13, U2.11 (~Y4)
/~readL1: CTRL_BUS1.5, U1.10 (~Y5)
/~readL2: CTRL_BUS1.6, U1.9 (~Y6)
/~readPC_high: CTRL_BUS2.2, U2.14 (~Y1)
/~readPC_low: CTRL_BUS2.1, U2.15 (~Y0)
/~readPC: CTRL_BUS2.5, U4.9 (~Y6)
/~readSP_high: CTRL_BUS2.4, U2.12 (~Y3)
/~readSP_low: CTRL_BUS2.3, U2.13 (~Y2)
/~readSP: CTRL_BUS2.6, U4.7 (~Y7)
/~reset: DATA_BUS1.11, J6.6
/~writeALU: U3.15 (~Y0), U6.12, U6.13
/~writeA: U3.14 (~Y1), U5.1, U5.2
/~writeB: U3.13 (~Y2), U5.12, U5.13
/~writeC: U3.12 (~Y3), U5.5, U5.6
/~writeD: U3.11 (~Y4), U5.8, U5.9
/~writeIPC: U7.13 (~Y2), U8.12, U8.13
/~writeL1: U3.10 (~Y5), U6.1, U6.2
/~writeL2: U3.9 (~Y6), U6.5, U6.6
/~writePC: U7.15 (~Y0), U8.1, U8.2
/~writeSP: U7.14 (~Y1), U8.5, U8.6
GND: C1.2, C2.2, C3.2, C4.2, C5.2, C6.2, DATA_BUS1.15, DATA_BUS1.16, H1.1, H2.1, H3.1, H4.1, J1.1, J6.7, R1.2, RN2.1 (common), RN3.1 (common), U1.4 (~E0), U1.8 (GND), U2.4 (~E0), U2.5 (~E1), U2.8 (GND), U3.4 (~E0), U3.5 (~E1), U3.8 (GND), U4.4 (~E0), U4.5 (~E1), U4.8 (GND), U5.7 (VSS), U6.7 (VSS), U6.8, U6.9, U7.8 (GND), U8.7 (VSS)
unnamed: D1.1 (K), R1.1
unnamed: J3.1, U1.7 (~Y7)
unnamed: U7.5 (~E1), U8.10
VCC: C1.1, C2.1, C3.1, C4.1, C5.1, C6.1, D1.2 (A), DATA_BUS1.13, DATA_BUS1.14, J1.2, J6.1, RN1.1 (common), U1.6 (E2), U1.16 (VCC), U2.16 (VCC), U3.16 (VCC), U4.6 (E2), U4.16 (VCC), U5.14 (VDD), U6.14 (VDD), U7.6 (E2), U7.16 (VCC), U8.14 (VDD)

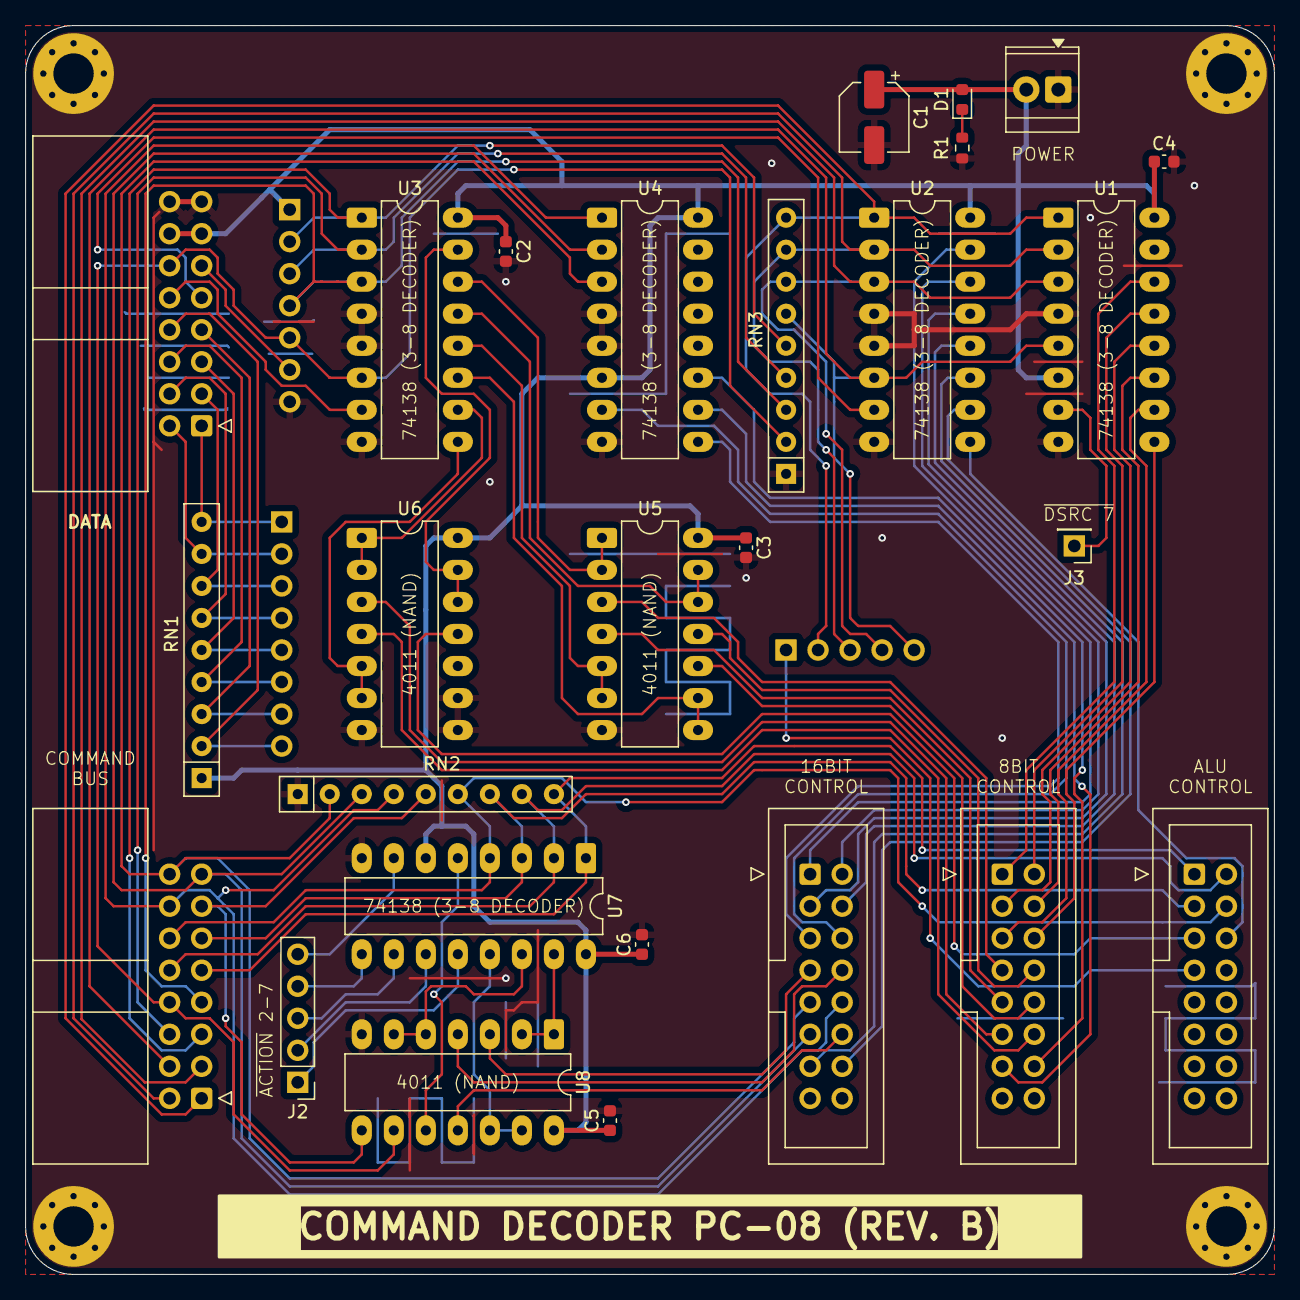
[picture p14: board command_decoder.kicad_pcb from above]

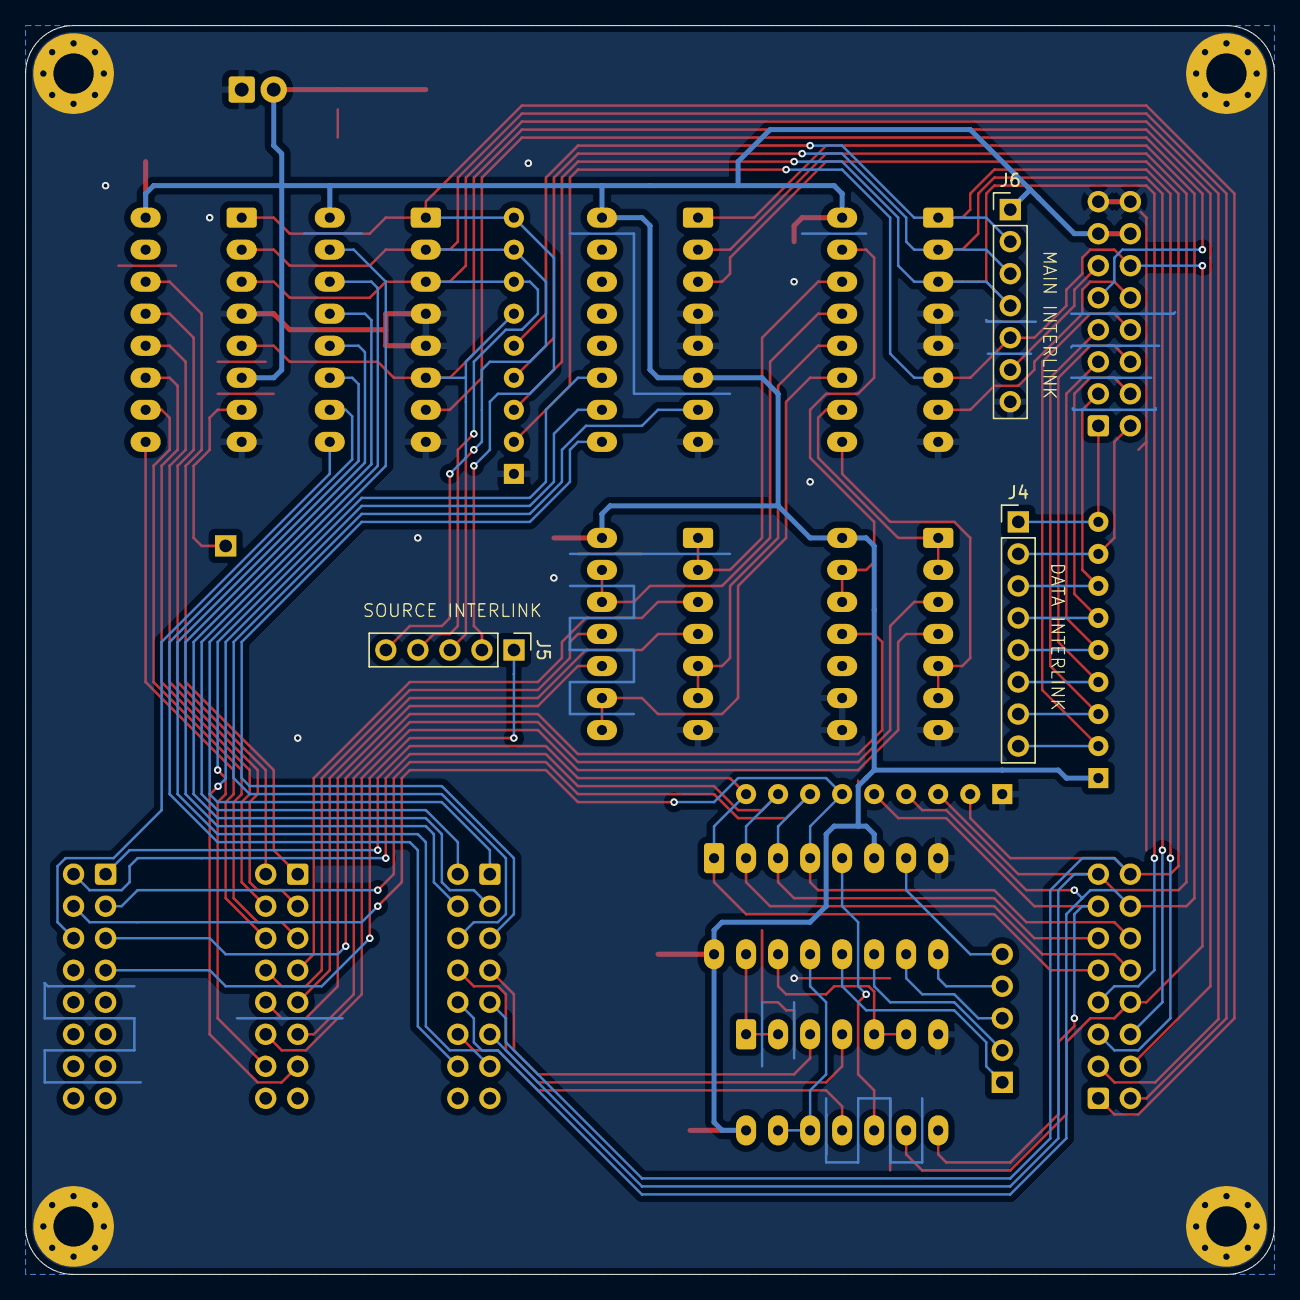
[picture p15: board command_decoder.kicad_pcb from below]

Board: 2 copper layers, 99.1 x 99.1 mm, 34 parts (3 on the bottom side), 75 nets.
