ksmonkey123/8bit_computer/circuits/pc-13_microcode/microcode.kicad_pcb

## KiCad design circuits/pc-13_microcode/microcode.kicad_pcb (2025-11-22)

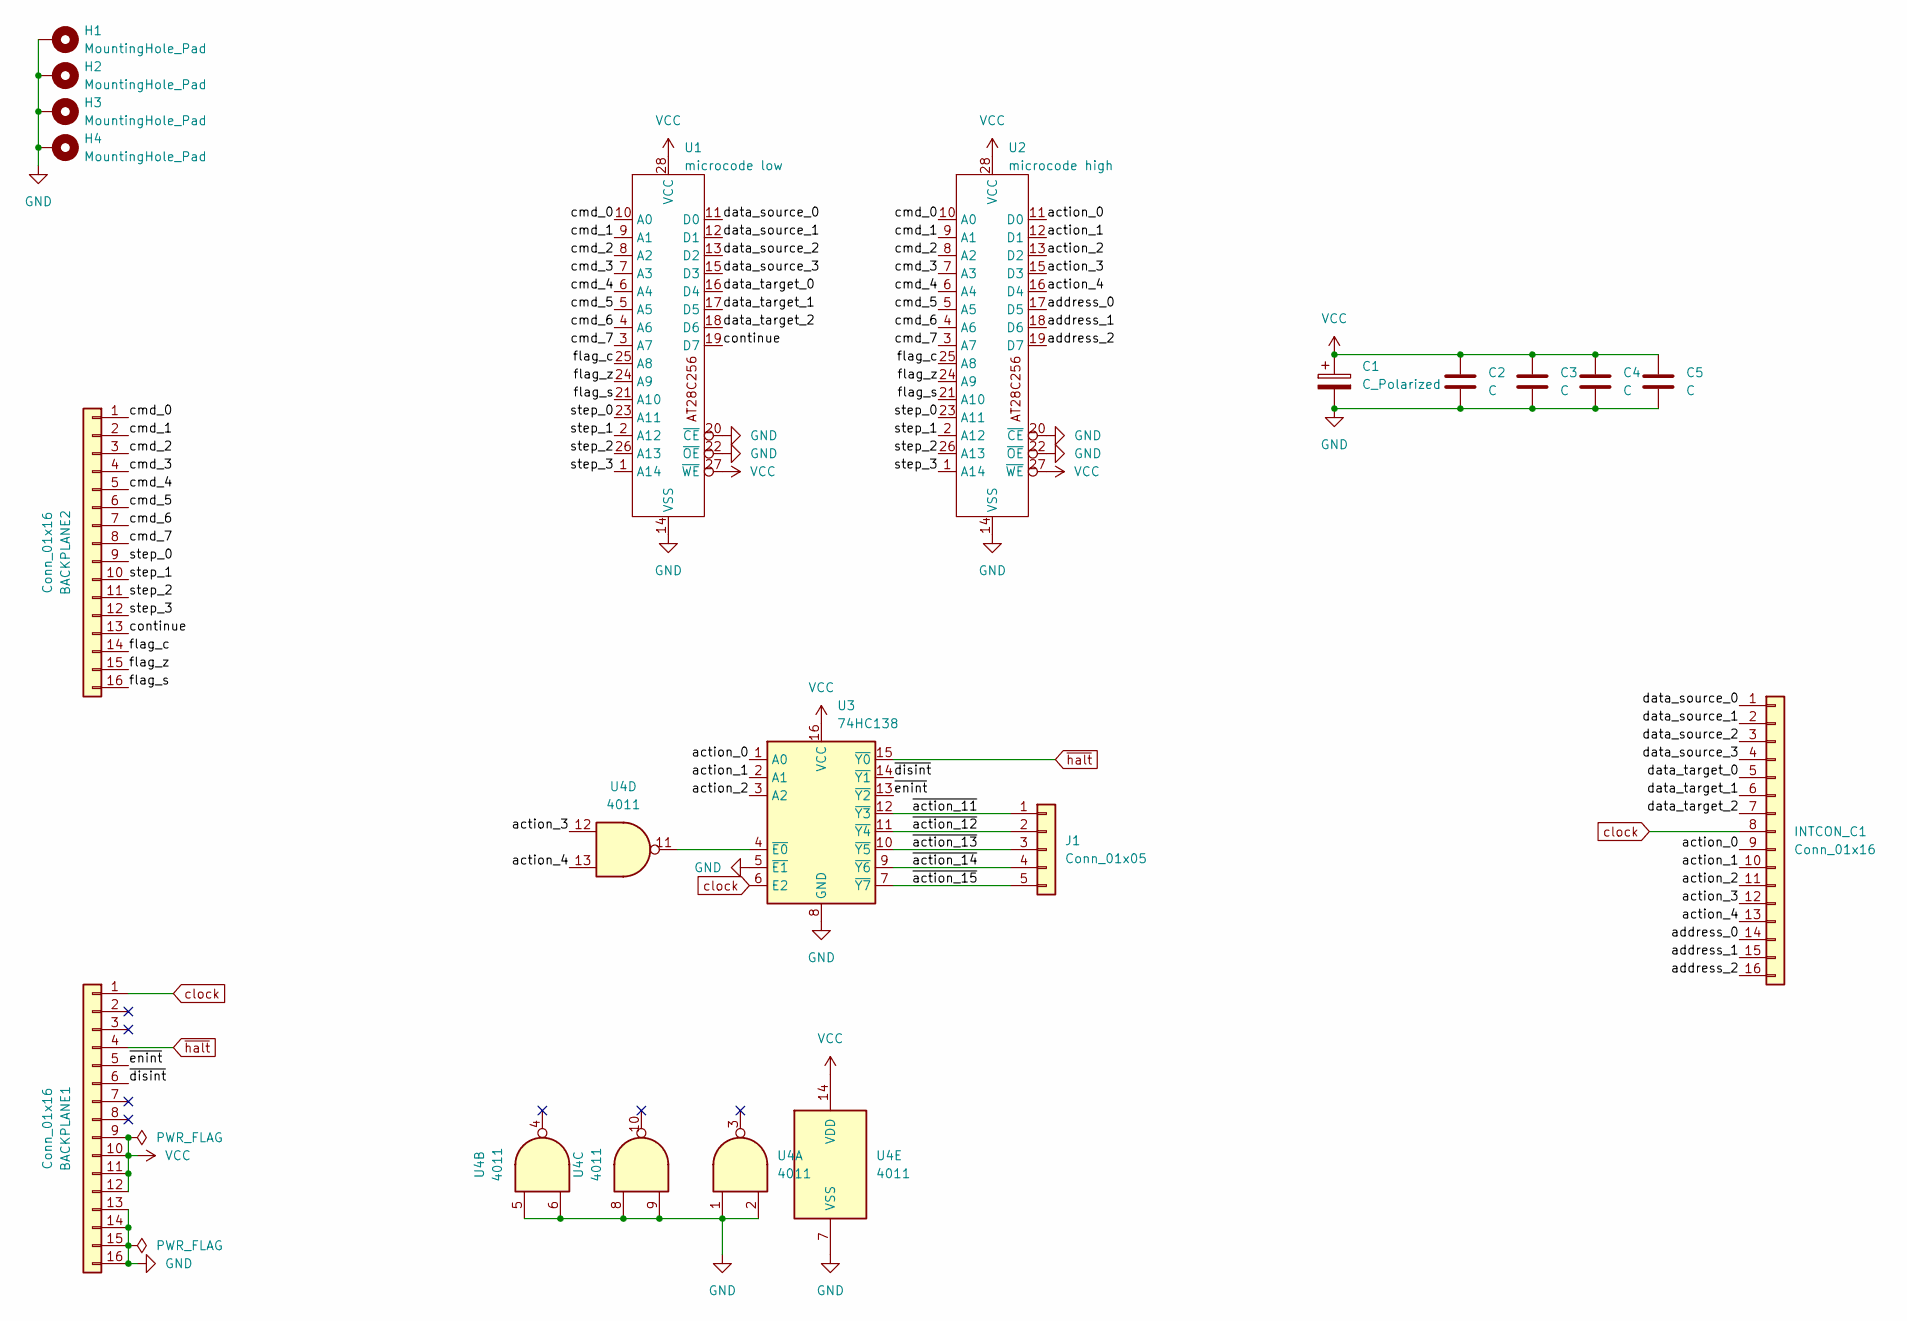
[picture p16: schematic microcode.kicad_sch, PC-XX TEMPLATE]

Parts:
BACKPLANE1, BACKPLANE2: Conn_01x16; IDC-Header_2x08_P2.54mm_Horizontal
C1: C_Polarized; CP_Elec_5x5.3
C2, C3, C4, C5: C; C_0603_1608Metric
H1, H2, H3, H4: MountingHole_Pad; MountingHole_3.2mm_M3_Pad_Via
INTCON_C1: Conn_01x16; IDC-Header_2x08_P2.54mm_Horizontal
J1: Conn_01x05; PinHeader_1x05_P2.54mm_Vertical
U1: microcode low; DIP-28_600_ELL
U2: microcode high; DIP-28_600_ELL
U3: 74HC138; DIP-16_W7.62mm
U4: 4011; DIP-14_W7.62mm

Connections:
/action_0: INTCON_C1.9, U2.11 (D0), U3.1 (A0)
/action_1: INTCON_C1.10, U2.12 (D1), U3.2 (A1)
/action_2: INTCON_C1.11, U2.13 (D2), U3.3 (A2)
/action_3: INTCON_C1.12, U2.15 (D3), U4.12
/action_4: INTCON_C1.13, U2.16 (D4), U4.13
/address_0: INTCON_C1.14, U2.17 (D5)
/address_1: INTCON_C1.15, U2.18 (D6)
/address_2: INTCON_C1.16, U2.19 (D7)
/cmd_0: BACKPLANE2.1, U1.10 (A0), U2.10 (A0)
/cmd_1: BACKPLANE2.2, U1.9 (A1), U2.9 (A1)
/cmd_2: BACKPLANE2.3, U1.8 (A2), U2.8 (A2)
/cmd_3: BACKPLANE2.4, U1.7 (A3), U2.7 (A3)
/cmd_4: BACKPLANE2.5, U1.6 (A4), U2.6 (A4)
/cmd_5: BACKPLANE2.6, U1.5 (A5), U2.5 (A5)
/cmd_6: BACKPLANE2.7, U1.4 (A6), U2.4 (A6)
/cmd_7: BACKPLANE2.8, U1.3 (A7), U2.3 (A7)
/continue: BACKPLANE2.13, U1.19 (D7)
/data_source_0: INTCON_C1.1, U1.11 (D0)
/data_source_1: INTCON_C1.2, U1.12 (D1)
/data_source_2: INTCON_C1.3, U1.13 (D2)
/data_source_3: INTCON_C1.4, U1.15 (D3)
/data_target_0: INTCON_C1.5, U1.16 (D4)
/data_target_1: INTCON_C1.6, U1.17 (D5)
/data_target_2: INTCON_C1.7, U1.18 (D6)
/flag_c: BACKPLANE2.14, U1.25 (A8), U2.25 (A8)
/flag_s: BACKPLANE2.16, U1.21 (A10), U2.21 (A10)
/flag_z: BACKPLANE2.15, U1.24 (A9), U2.24 (A9)
/step_0: BACKPLANE2.9, U1.23 (A11), U2.23 (A11)
/step_1: BACKPLANE2.10, U1.2 (A12), U2.2 (A12)
/step_2: BACKPLANE2.11, U1.26 (A13), U2.26 (A13)
/step_3: BACKPLANE2.12, U1.1 (A14), U2.1 (A14)
/~action_11: J1.1, U3.12 (~Y3)
/~action_12: J1.2, U3.11 (~Y4)
/~action_13: J1.3, U3.10 (~Y5)
/~action_14: J1.4, U3.9 (~Y6)
/~action_15: J1.5, U3.7 (~Y7)
/~disint: BACKPLANE1.6, U3.14 (~Y1)
/~enint: BACKPLANE1.5, U3.13 (~Y2)
GND: BACKPLANE1.13, BACKPLANE1.14, BACKPLANE1.15, BACKPLANE1.16, C1.2, C2.2, C3.2, C4.2, C5.2, H1.1, H2.1, H3.1, H4.1, U1.14 (VSS), U1.20 (~CE), U1.22 (~OE), U2.14 (VSS), U2.20 (~CE), U2.22 (~OE), U3.5 (~E1), U3.8 (GND), U4.1, U4.2, U4.5, U4.6, U4.7 (VSS), U4.8, U4.9
unnamed: U3.4 (~E0), U4.11
VCC: BACKPLANE1.9, BACKPLANE1.10, BACKPLANE1.11, BACKPLANE1.12, C1.1, C2.1, C3.1, C4.1, C5.1, U1.27 (~WE), U1.28 (VCC), U2.27 (~WE), U2.28 (VCC), U3.16 (VCC), U4.14 (VDD)
clock: BACKPLANE1.1, INTCON_C1.8, U3.6 (E2)
~halt: BACKPLANE1.4, U3.15 (~Y0)

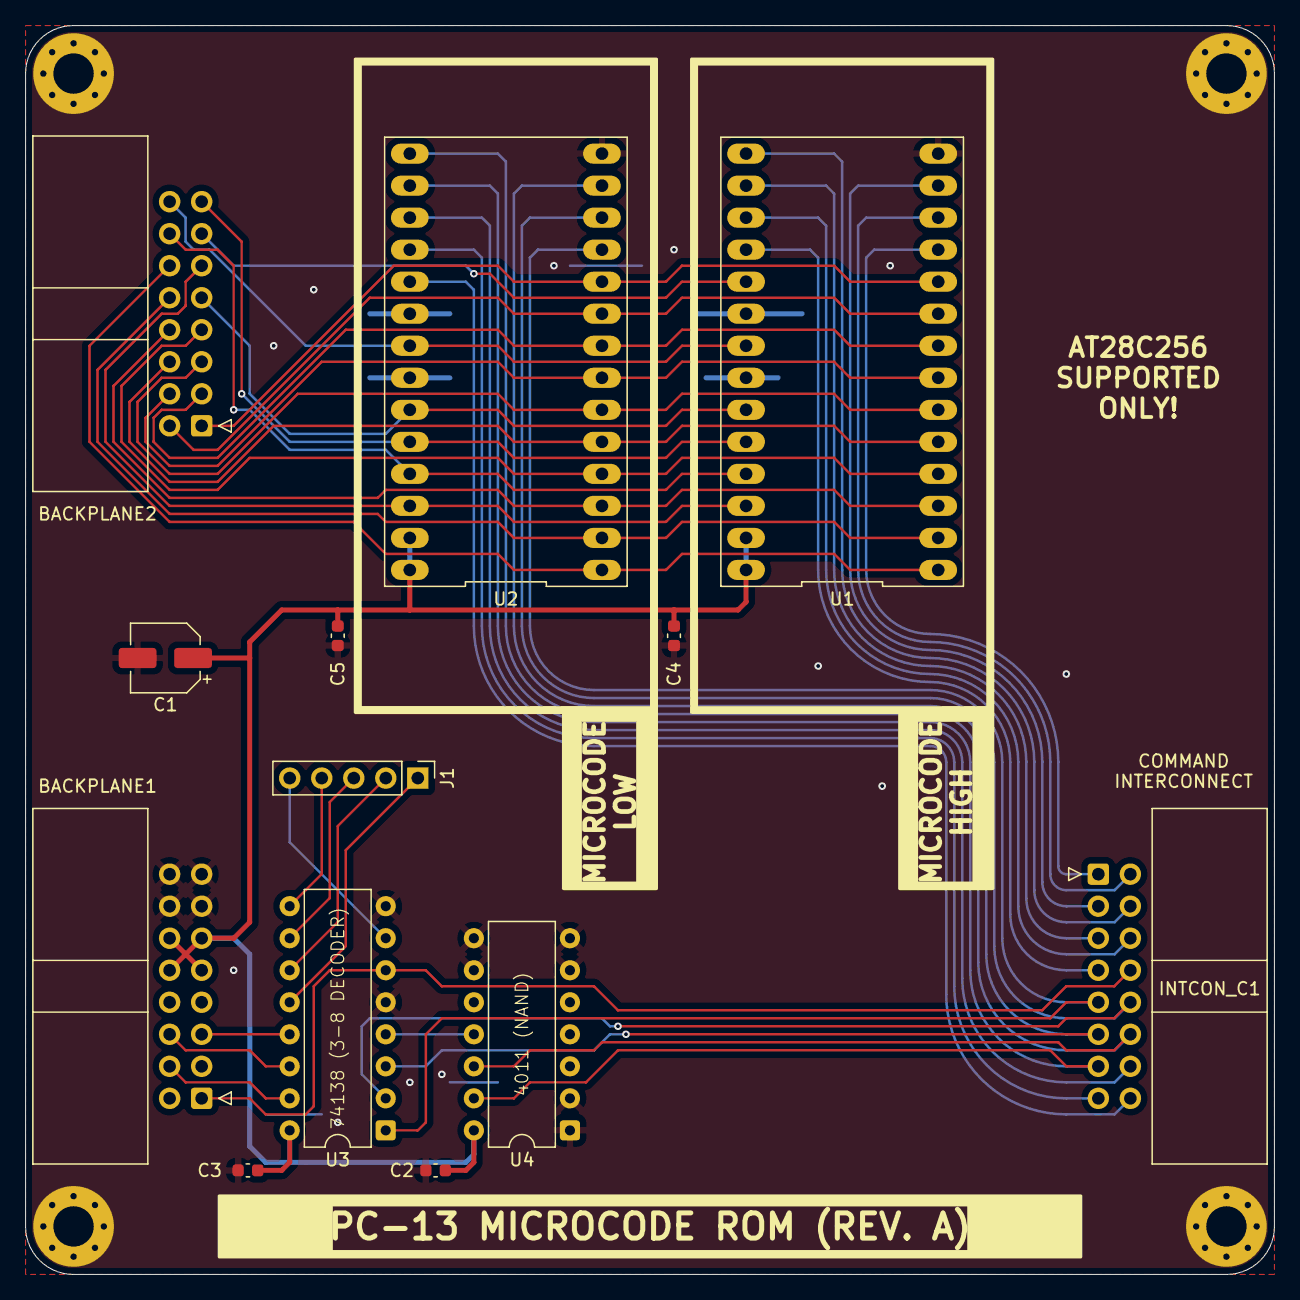
[picture p17: board microcode.kicad_pcb from above]

Board: 2 copper layers, 99.1 x 99.1 mm, 17 parts (0 on the bottom side), 43 nets.
