ksmonkey123/8bit_computer/circuits/pc-xx_orchestrator_stack_template/orchestrator_stack_template.kicad_pcb

## KiCad design circuits/pc-xx_orchestrator_stack_template/orchestrator_stack_template.kicad_pcb (2025-11-20)

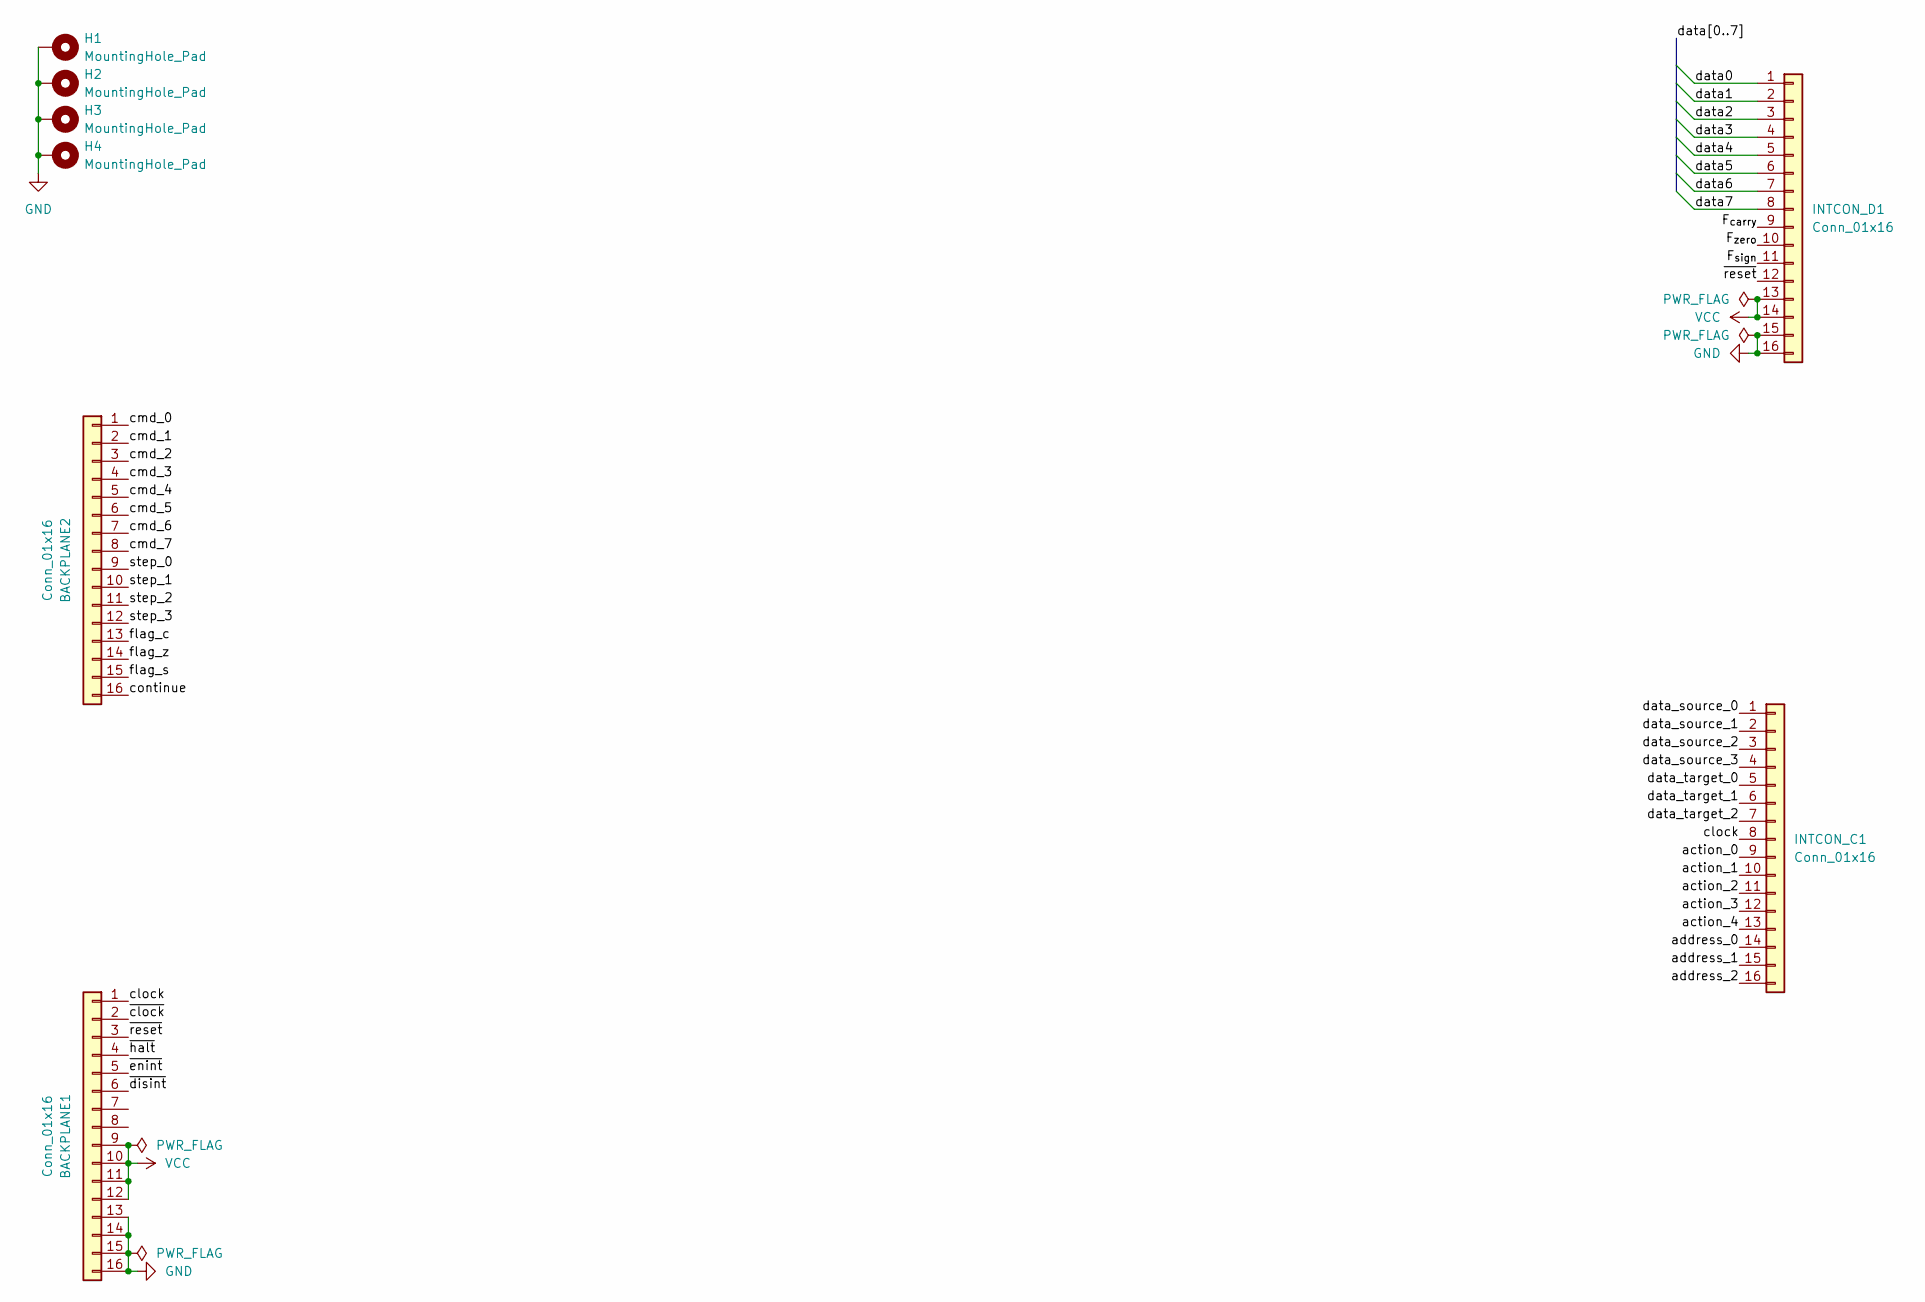
[picture p18: schematic orchestrator_stack_template.kicad_sch, PC-XX TEMPLATE]

Parts:
BACKPLANE1, BACKPLANE2: Conn_01x16; IDC-Header_2x08_P2.54mm_Horizontal
H1, H2, H3, H4: MountingHole_Pad; MountingHole_3.2mm_M3_Pad_Via
INTCON_C1: Conn_01x16; IDC-Header_2x08_P2.54mm_Horizontal
INTCON_D1: Conn_01x16; IDC-Header_2x08_P2.54mm_Horizontal

Connections:
/F_{carry}: INTCON_D1.9
/F_{sign}: INTCON_D1.11
/F_{zero}: INTCON_D1.10
/action_0: INTCON_C1.9
/action_1: INTCON_C1.10
/action_2: INTCON_C1.11
/action_3: INTCON_C1.12
/action_4: INTCON_C1.13
/address_0: INTCON_C1.14
/address_1: INTCON_C1.15
/address_2: INTCON_C1.16
/clock: BACKPLANE1.1, INTCON_C1.8
/cmd_0: BACKPLANE2.1
/cmd_1: BACKPLANE2.2
/cmd_2: BACKPLANE2.3
/cmd_3: BACKPLANE2.4
/cmd_4: BACKPLANE2.5
/cmd_5: BACKPLANE2.6
/cmd_6: BACKPLANE2.7
/cmd_7: BACKPLANE2.8
/continue: BACKPLANE2.16
/data0: INTCON_D1.1
/data1: INTCON_D1.2
/data2: INTCON_D1.3
/data3: INTCON_D1.4
/data4: INTCON_D1.5
/data5: INTCON_D1.6
/data6: INTCON_D1.7
/data7: INTCON_D1.8
/data_source_0: INTCON_C1.1
/data_source_1: INTCON_C1.2
/data_source_2: INTCON_C1.3
/data_source_3: INTCON_C1.4
/data_target_0: INTCON_C1.5
/data_target_1: INTCON_C1.6
/data_target_2: INTCON_C1.7
/flag_c: BACKPLANE2.13
/flag_s: BACKPLANE2.15
/flag_z: BACKPLANE2.14
/step_0: BACKPLANE2.9
/step_1: BACKPLANE2.10
/step_2: BACKPLANE2.11
/step_3: BACKPLANE2.12
/~clock: BACKPLANE1.2
/~disint: BACKPLANE1.6
/~enint: BACKPLANE1.5
/~halt: BACKPLANE1.4
/~reset: BACKPLANE1.3, INTCON_D1.12
GND: BACKPLANE1.13, BACKPLANE1.14, BACKPLANE1.15, BACKPLANE1.16, H1.1, H2.1, H3.1, H4.1, INTCON_D1.15, INTCON_D1.16
VCC: BACKPLANE1.9, BACKPLANE1.10, BACKPLANE1.11, BACKPLANE1.12, INTCON_D1.13, INTCON_D1.14

Board: 2 copper layers, 8 parts (0 on the bottom side), 4 nets, no tracks yet.
