ksmonkey123/8bit_computer/circuits/pc-11_mock_orchestrator/mock_orchestrator.kicad_pcb

## KiCad design circuits/pc-11_mock_orchestrator/mock_orchestrator.kicad_pcb (2025-11-11)

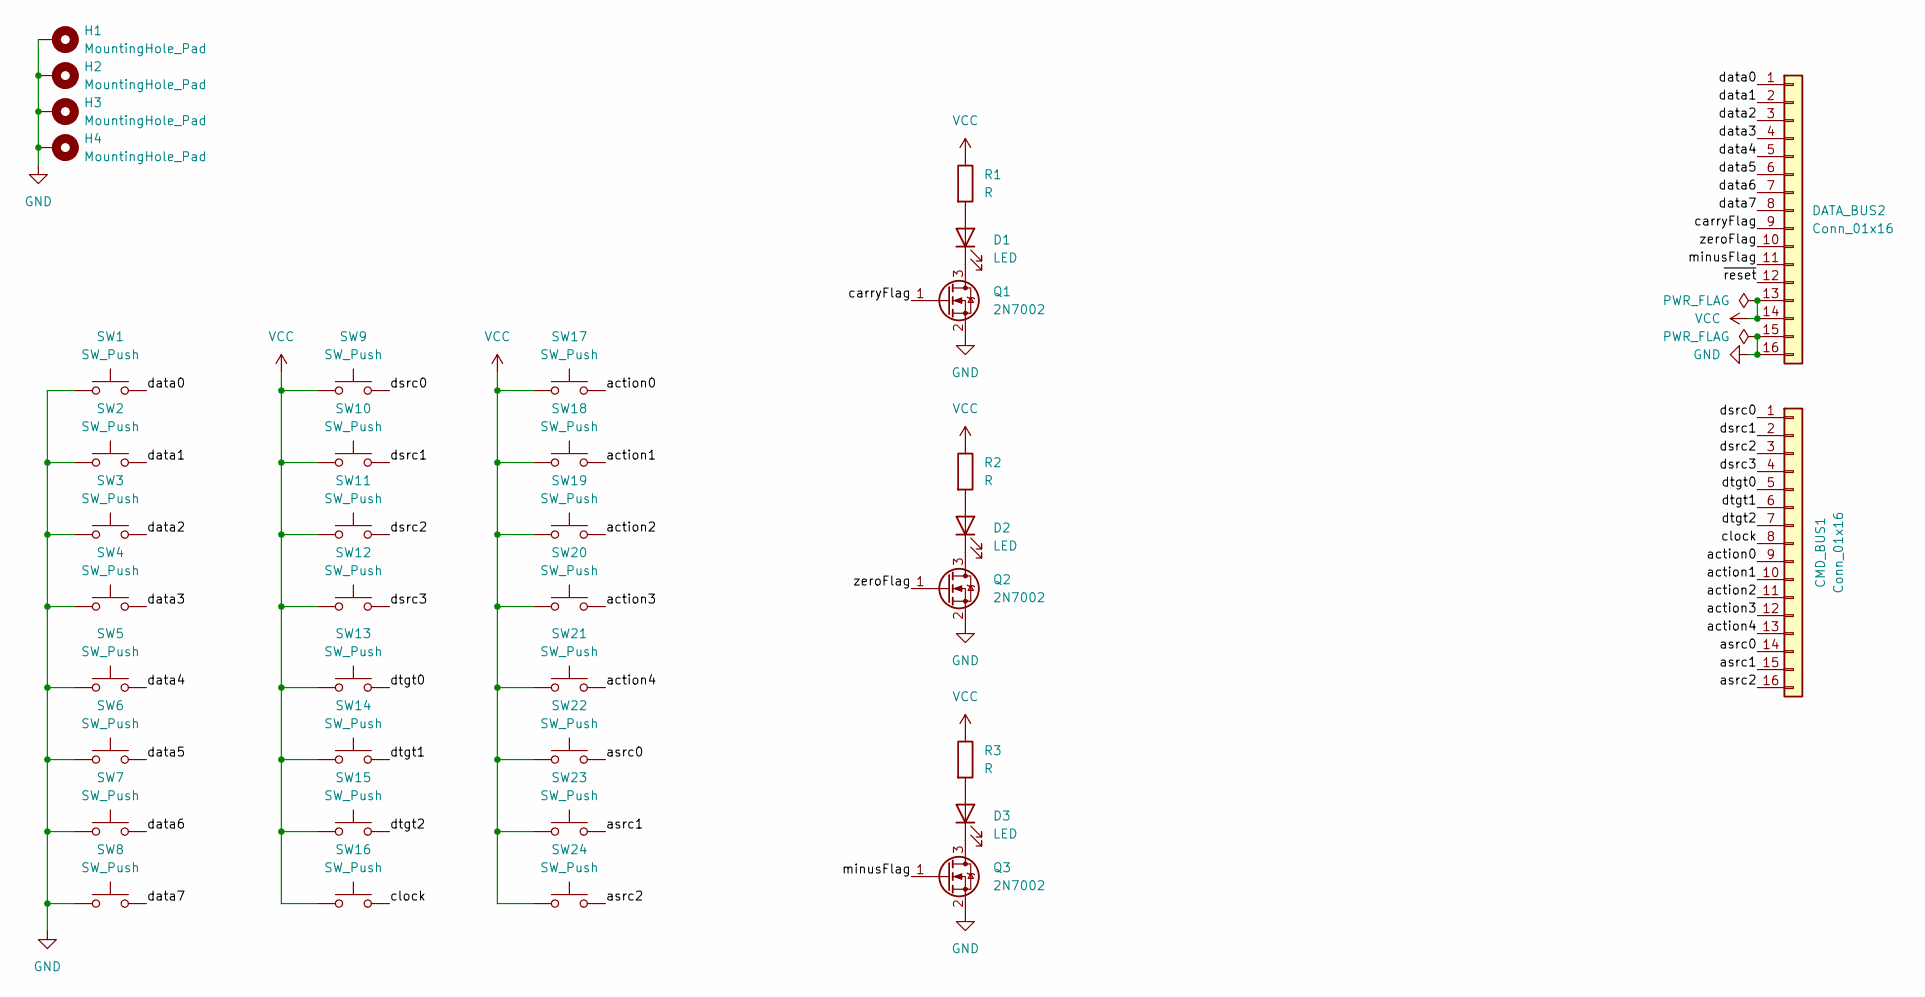
[picture p19: schematic mock_orchestrator.kicad_sch, PC-XX TEMPLATE]

Parts:
CMD_BUS1: Conn_01x16; IDC-Header_2x08_P2.54mm_Vertical
D1, D2, D3: LED; LED_0603_1608Metric
DATA_BUS2: Conn_01x16; IDC-Header_2x08_P2.54mm_Vertical
H1, H2, H3, H4: MountingHole_Pad; MountingHole_3.2mm_M3_Pad_Via
Q1, Q2, Q3: 2N7002; SOT-23
R1, R2, R3: R; R_0603_1608Metric
SW1, SW2, SW3, SW4, SW5, SW6, SW7, SW8, SW9, SW10, SW11, SW12, SW13, SW14, SW15, SW16, SW17, SW18, SW19, SW20, SW21, SW22, SW23, SW24: SW_Push; SW_PUSH_6mm

Connections:
/action0: CMD_BUS1.9, SW17.2
/action1: CMD_BUS1.10, SW18.2
/action2: CMD_BUS1.11, SW19.2
/action3: CMD_BUS1.12, SW20.2
/action4: CMD_BUS1.13, SW21.2
/asrc0: CMD_BUS1.14, SW22.2
/asrc1: CMD_BUS1.15, SW23.2
/asrc2: CMD_BUS1.16, SW24.2
/carryFlag: DATA_BUS2.9, Q1.1 (G)
/clock: CMD_BUS1.8, SW16.2
/data0: DATA_BUS2.1, SW1.2
/data1: DATA_BUS2.2, SW2.2
/data2: DATA_BUS2.3, SW3.2
/data3: DATA_BUS2.4, SW4.2
/data4: DATA_BUS2.5, SW5.2
/data5: DATA_BUS2.6, SW6.2
/data6: DATA_BUS2.7, SW7.2
/data7: DATA_BUS2.8, SW8.2
/dsrc0: CMD_BUS1.1, SW9.2
/dsrc1: CMD_BUS1.2, SW10.2
/dsrc2: CMD_BUS1.3, SW11.2
/dsrc3: CMD_BUS1.4, SW12.2
/dtgt0: CMD_BUS1.5, SW13.2
/dtgt1: CMD_BUS1.6, SW14.2
/dtgt2: CMD_BUS1.7, SW15.2
/minusFlag: DATA_BUS2.11, Q3.1 (G)
/zeroFlag: DATA_BUS2.10, Q2.1 (G)
/~reset: DATA_BUS2.12
GND: DATA_BUS2.15, DATA_BUS2.16, H1.1, H2.1, H3.1, H4.1, Q1.2 (S), Q2.2 (S), Q3.2 (S), SW1.1, SW2.1, SW3.1, SW4.1, SW5.1, SW6.1, SW7.1, SW8.1
unnamed: D1.2 (A), R1.2
unnamed: D1.1 (K), Q1.3 (D)
unnamed: D2.2 (A), R2.2
unnamed: D2.1 (K), Q2.3 (D)
unnamed: D3.2 (A), R3.2
unnamed: D3.1 (K), Q3.3 (D)
VCC: DATA_BUS2.13, DATA_BUS2.14, R1.1, R2.1, R3.1, SW9.1, SW10.1, SW11.1, SW12.1, SW13.1, SW14.1, SW15.1, SW16.1, SW17.1, SW18.1, SW19.1, SW20.1, SW21.1, SW22.1, SW23.1, SW24.1

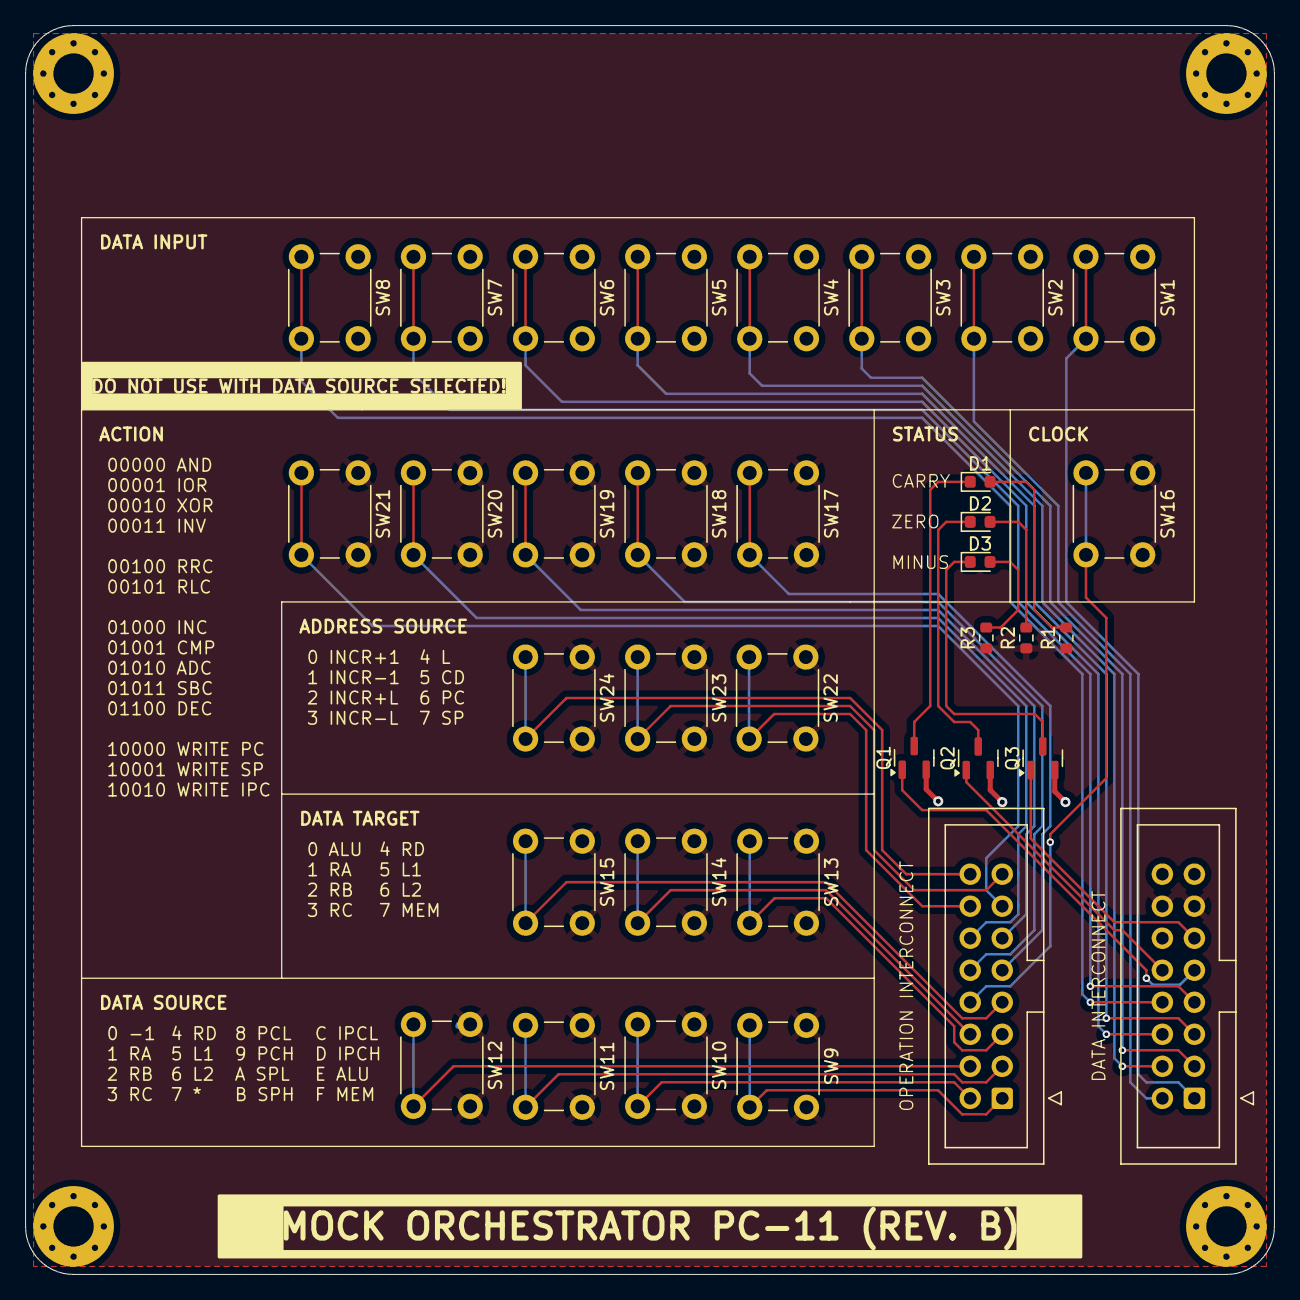
[picture p20: board mock_orchestrator.kicad_pcb from above]

Board: 2 copper layers, 99.1 x 99.1 mm, 39 parts (0 on the bottom side), 35 nets.
