ksmonkey123/8bit_computer/circuits/pc-10_bus_spy/bus_spy.kicad_pcb

## KiCad design circuits/pc-10_bus_spy/bus_spy.kicad_pcb (2025-03-04)

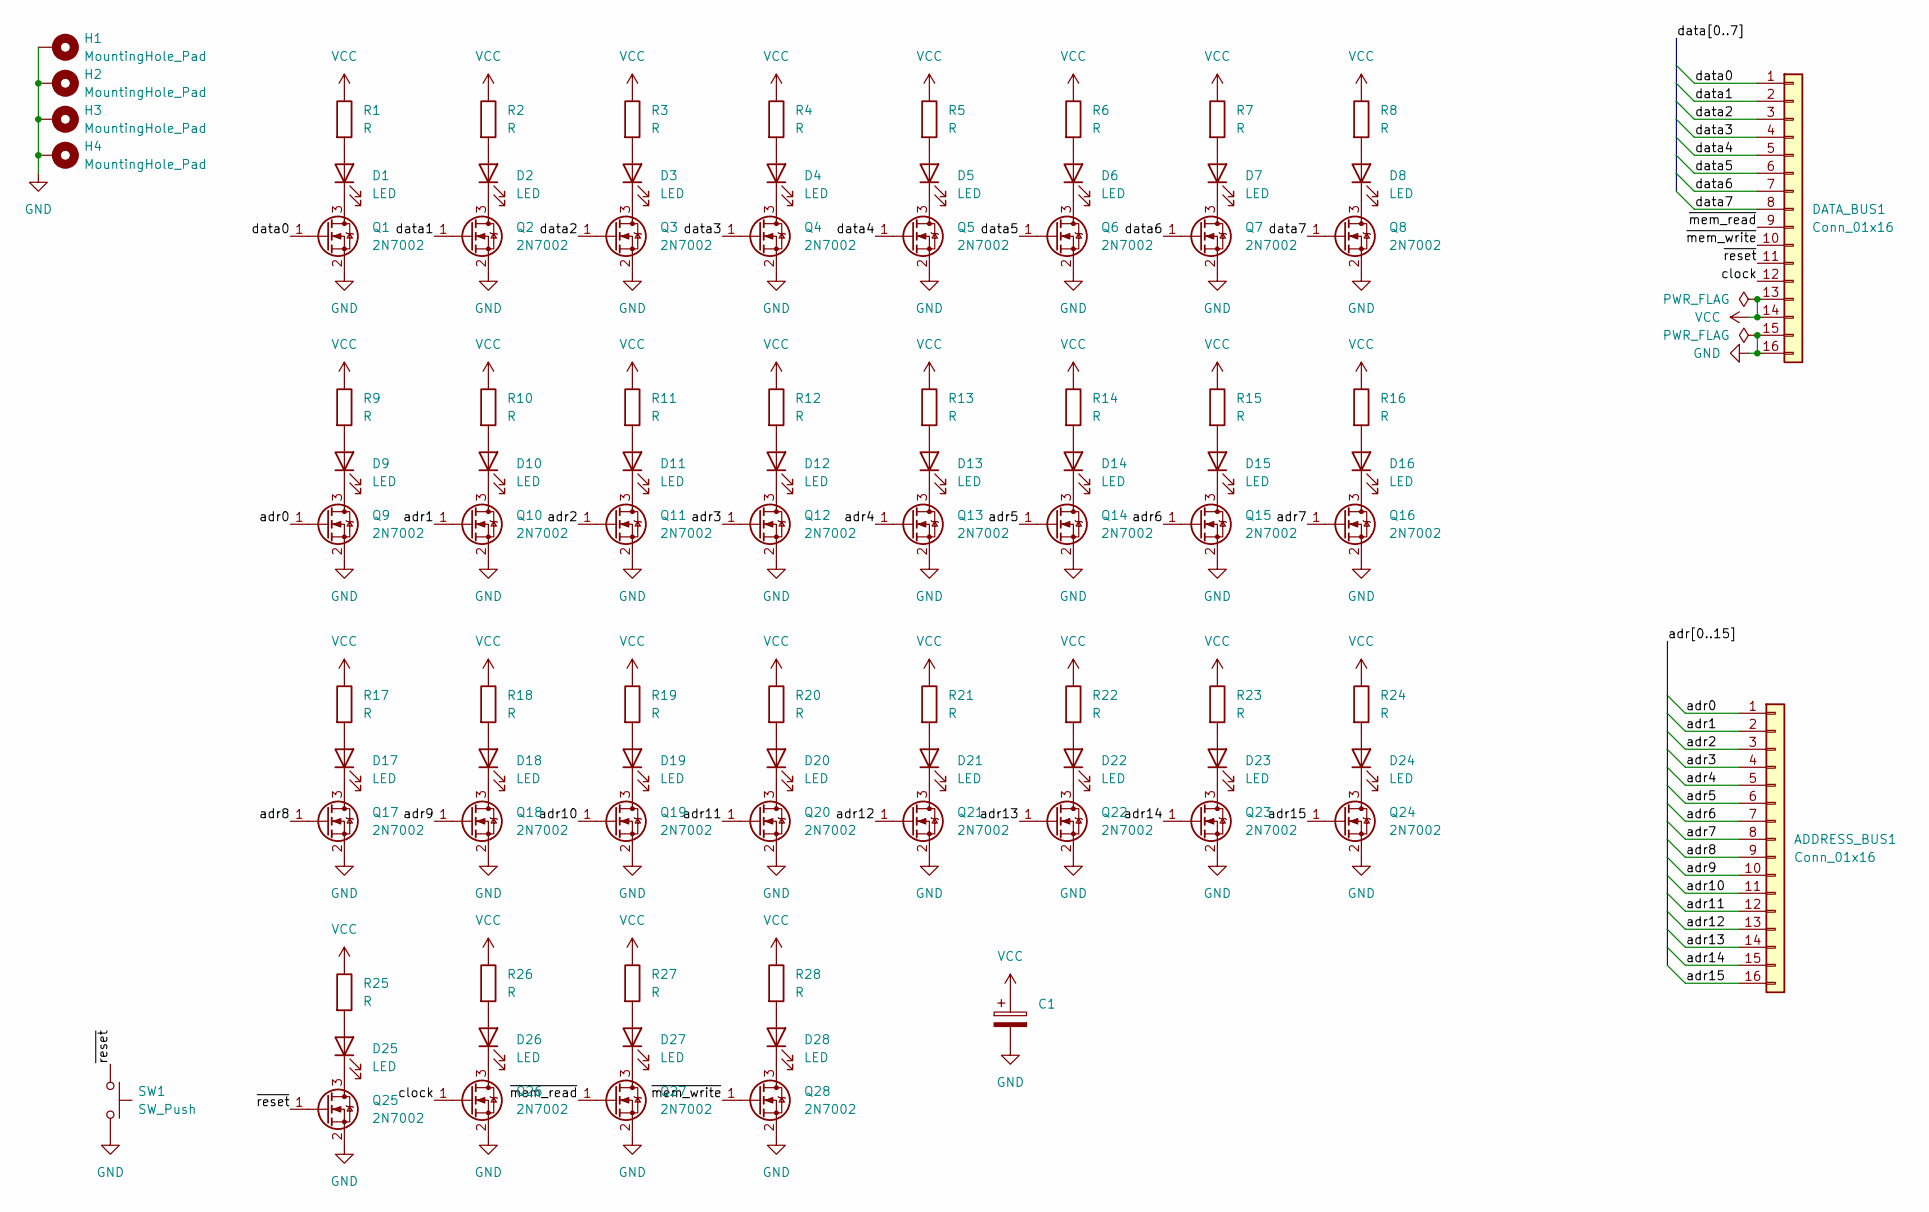
[picture p21: schematic bus_spy.kicad_sch, PC-10 BUS SPY]

Parts:
ADDRESS_BUS1: Conn_01x16; IDC-Header_2x08_P2.54mm_Horizontal
C1: C_Polarized; CP_Elec_5x5.3
D1, D2, D3, D4, D5, D6, D7, D8, D9, D10, D11, D12, D13, D14, D15, D16, D17, D18, D19, D20, D21, D22, D23, D24, D25, D26, D27, D28: LED; LED_0603_1608Metric
DATA_BUS1: Conn_01x16; IDC-Header_2x08_P2.54mm_Horizontal
H1, H2, H3, H4: MountingHole_Pad; MountingHole_3.2mm_M3_Pad_Via
Q1, Q2, Q3, Q4, Q5, Q6, Q7, Q8, Q9, Q10, Q11, Q12, Q13, Q14, Q15, Q16, Q17, Q18, Q19, Q20, Q21, Q22, Q23, Q24, Q25, Q26, Q27, Q28: 2N7002; SOT-23
R1, R2, R3, R4, R5, R6, R7, R8, R9, R10, R11, R12, R13, R14, R15, R16, R17, R18, R19, R20, R21, R22, R23, R24, R25, R26, R27, R28: R; R_0603_1608Metric
SW1: SW_Push; SW_PUSH_6mm

Connections:
/adr0: ADDRESS_BUS1.1, Q9.1 (G)
/adr1: ADDRESS_BUS1.2, Q10.1 (G)
/adr2: ADDRESS_BUS1.3, Q11.1 (G)
/adr3: ADDRESS_BUS1.4, Q12.1 (G)
/adr4: ADDRESS_BUS1.5, Q13.1 (G)
/adr5: ADDRESS_BUS1.6, Q14.1 (G)
/adr6: ADDRESS_BUS1.7, Q15.1 (G)
/adr7: ADDRESS_BUS1.8, Q16.1 (G)
/adr8: ADDRESS_BUS1.9, Q17.1 (G)
/adr9: ADDRESS_BUS1.10, Q18.1 (G)
/adr10: ADDRESS_BUS1.11, Q19.1 (G)
/adr11: ADDRESS_BUS1.12, Q20.1 (G)
/adr12: ADDRESS_BUS1.13, Q21.1 (G)
/adr13: ADDRESS_BUS1.14, Q22.1 (G)
/adr14: ADDRESS_BUS1.15, Q23.1 (G)
/adr15: ADDRESS_BUS1.16, Q24.1 (G)
/clock: DATA_BUS1.12, Q26.1 (G)
/data0: DATA_BUS1.1, Q1.1 (G)
/data1: DATA_BUS1.2, Q2.1 (G)
/data2: DATA_BUS1.3, Q3.1 (G)
/data3: DATA_BUS1.4, Q4.1 (G)
/data4: DATA_BUS1.5, Q5.1 (G)
/data5: DATA_BUS1.6, Q6.1 (G)
/data6: DATA_BUS1.7, Q7.1 (G)
/data7: DATA_BUS1.8, Q8.1 (G)
/~mem_read: DATA_BUS1.9, Q27.1 (G)
/~mem_write: DATA_BUS1.10, Q28.1 (G)
/~reset: DATA_BUS1.11, Q25.1 (G), SW1.1
GND: C1.2, DATA_BUS1.15, DATA_BUS1.16, H1.1, H2.1, H3.1, H4.1, Q1.2 (S), Q2.2 (S), Q3.2 (S), Q4.2 (S), Q5.2 (S), Q6.2 (S), Q7.2 (S), Q8.2 (S), Q9.2 (S), Q10.2 (S), Q11.2 (S), Q12.2 (S), Q13.2 (S), Q14.2 (S), Q15.2 (S), Q16.2 (S), Q17.2 (S), Q18.2 (S), Q19.2 (S), Q20.2 (S), Q21.2 (S), Q22.2 (S), Q23.2 (S), Q24.2 (S), Q25.2 (S), Q26.2 (S), Q27.2 (S), Q28.2 (S), SW1.2
unnamed: D1.2 (A), R1.2
unnamed: D1.1 (K), Q1.3 (D)
unnamed: D2.2 (A), R2.2
unnamed: D2.1 (K), Q2.3 (D)
unnamed: D3.2 (A), R3.2
unnamed: D3.1 (K), Q3.3 (D)
unnamed: D4.2 (A), R4.2
unnamed: D4.1 (K), Q4.3 (D)
unnamed: D5.2 (A), R5.2
unnamed: D5.1 (K), Q5.3 (D)
unnamed: D6.2 (A), R6.2
unnamed: D6.1 (K), Q6.3 (D)
unnamed: D7.2 (A), R7.2
unnamed: D7.1 (K), Q7.3 (D)
unnamed: D8.2 (A), R8.2
unnamed: D8.1 (K), Q8.3 (D)
unnamed: D9.2 (A), R9.2
unnamed: D9.1 (K), Q9.3 (D)
unnamed: D10.2 (A), R10.2
unnamed: D10.1 (K), Q10.3 (D)
unnamed: D11.2 (A), R11.2
unnamed: D11.1 (K), Q11.3 (D)
unnamed: D12.2 (A), R12.2
unnamed: D12.1 (K), Q12.3 (D)
unnamed: D13.2 (A), R13.2
unnamed: D13.1 (K), Q13.3 (D)
unnamed: D14.2 (A), R14.2
unnamed: D14.1 (K), Q14.3 (D)
unnamed: D15.2 (A), R15.2
unnamed: D15.1 (K), Q15.3 (D)
unnamed: D16.2 (A), R16.2
unnamed: D16.1 (K), Q16.3 (D)
unnamed: D17.2 (A), R17.2
unnamed: D17.1 (K), Q17.3 (D)
unnamed: D18.2 (A), R18.2
unnamed: D18.1 (K), Q18.3 (D)
unnamed: D19.2 (A), R19.2
unnamed: D19.1 (K), Q19.3 (D)
unnamed: D20.2 (A), R20.2
unnamed: D20.1 (K), Q20.3 (D)
unnamed: D21.2 (A), R21.2
unnamed: D21.1 (K), Q21.3 (D)
unnamed: D22.2 (A), R22.2
unnamed: D22.1 (K), Q22.3 (D)
unnamed: D23.2 (A), R23.2
unnamed: D23.1 (K), Q23.3 (D)
unnamed: D24.2 (A), R24.2
unnamed: D24.1 (K), Q24.3 (D)
unnamed: D25.2 (A), R25.2
unnamed: D25.1 (K), Q25.3 (D)
unnamed: D26.2 (A), R26.2
unnamed: D26.1 (K), Q26.3 (D)
unnamed: D27.2 (A), R27.2
unnamed: D27.1 (K), Q27.3 (D)
unnamed: D28.2 (A), R28.2
unnamed: D28.1 (K), Q28.3 (D)
VCC: C1.1, DATA_BUS1.13, DATA_BUS1.14, R1.1, R2.1, R3.1, R4.1, R5.1, R6.1, R7.1, R8.1, R9.1, R10.1, R11.1, R12.1, R13.1, R14.1, R15.1, R16.1, R17.1, R18.1, R19.1, R20.1, R21.1, R22.1, R23.1, R24.1, R25.1, R26.1, R27.1, R28.1

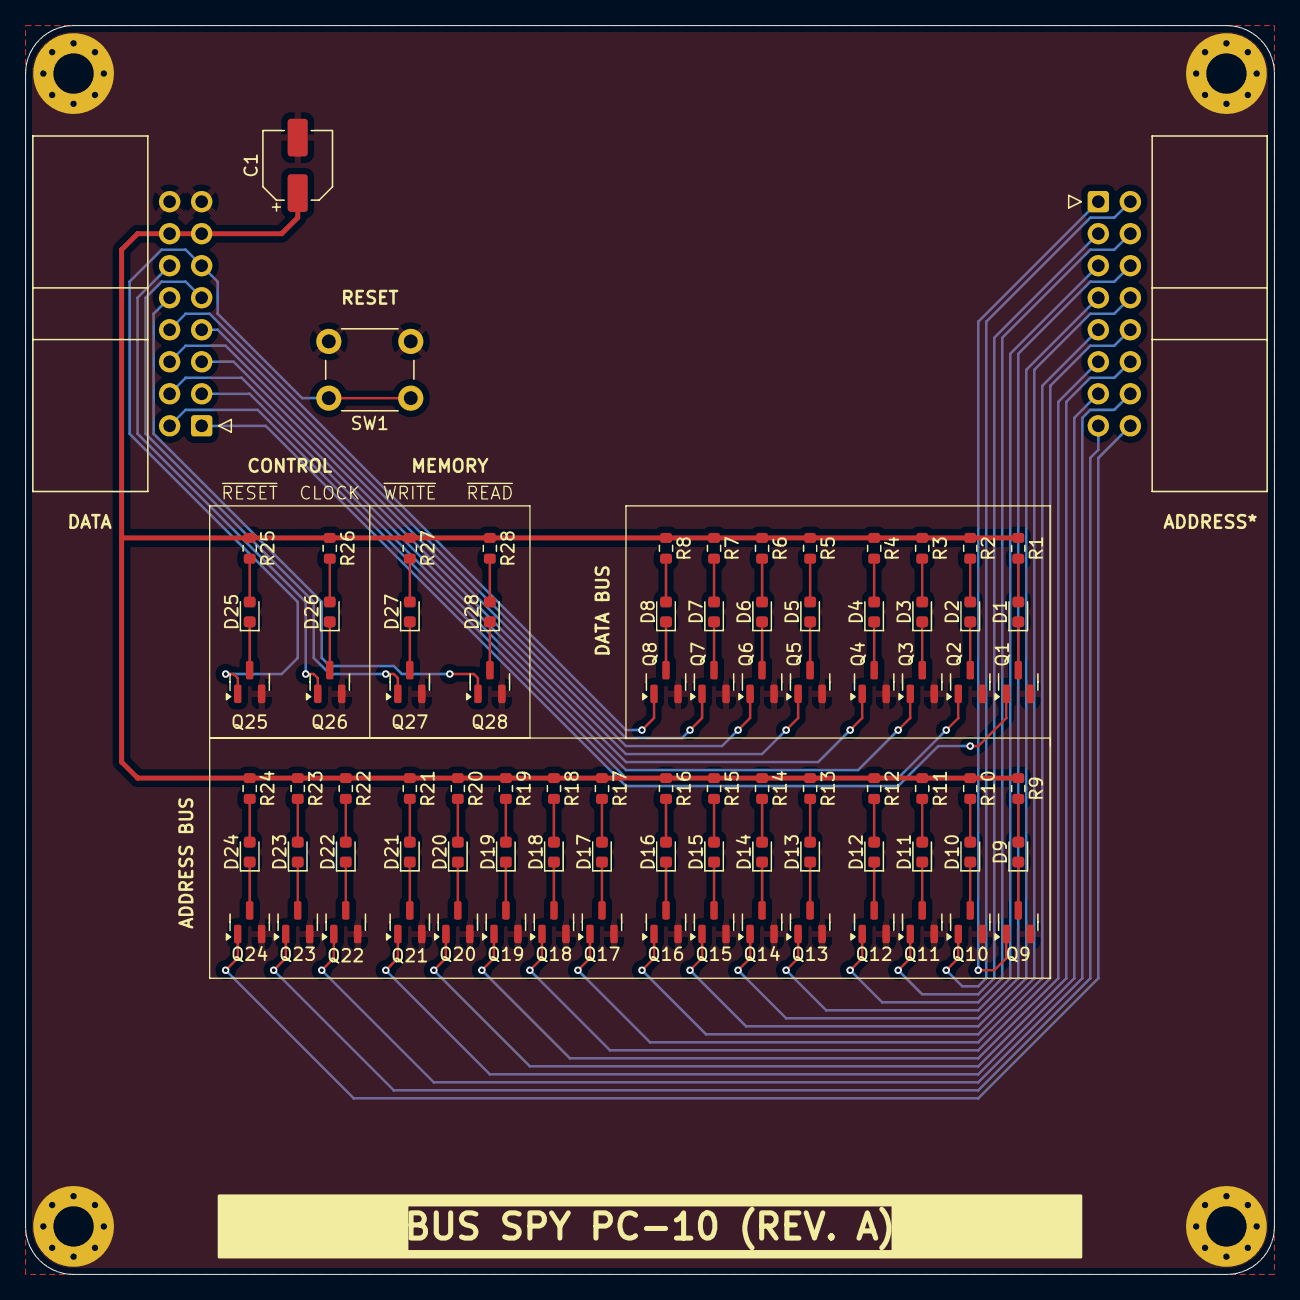
[picture p22: board bus_spy.kicad_pcb from above]

Board: 2 copper layers, 99.1 x 99.1 mm, 92 parts (0 on the bottom side), 86 nets.
