ksmonkey123/8bit_computer/circuits/pc-06_alu_logic/alu_logic.kicad_pcb

## KiCad design circuits/pc-06_alu_logic/alu_logic.kicad_pcb (2025-03-04)

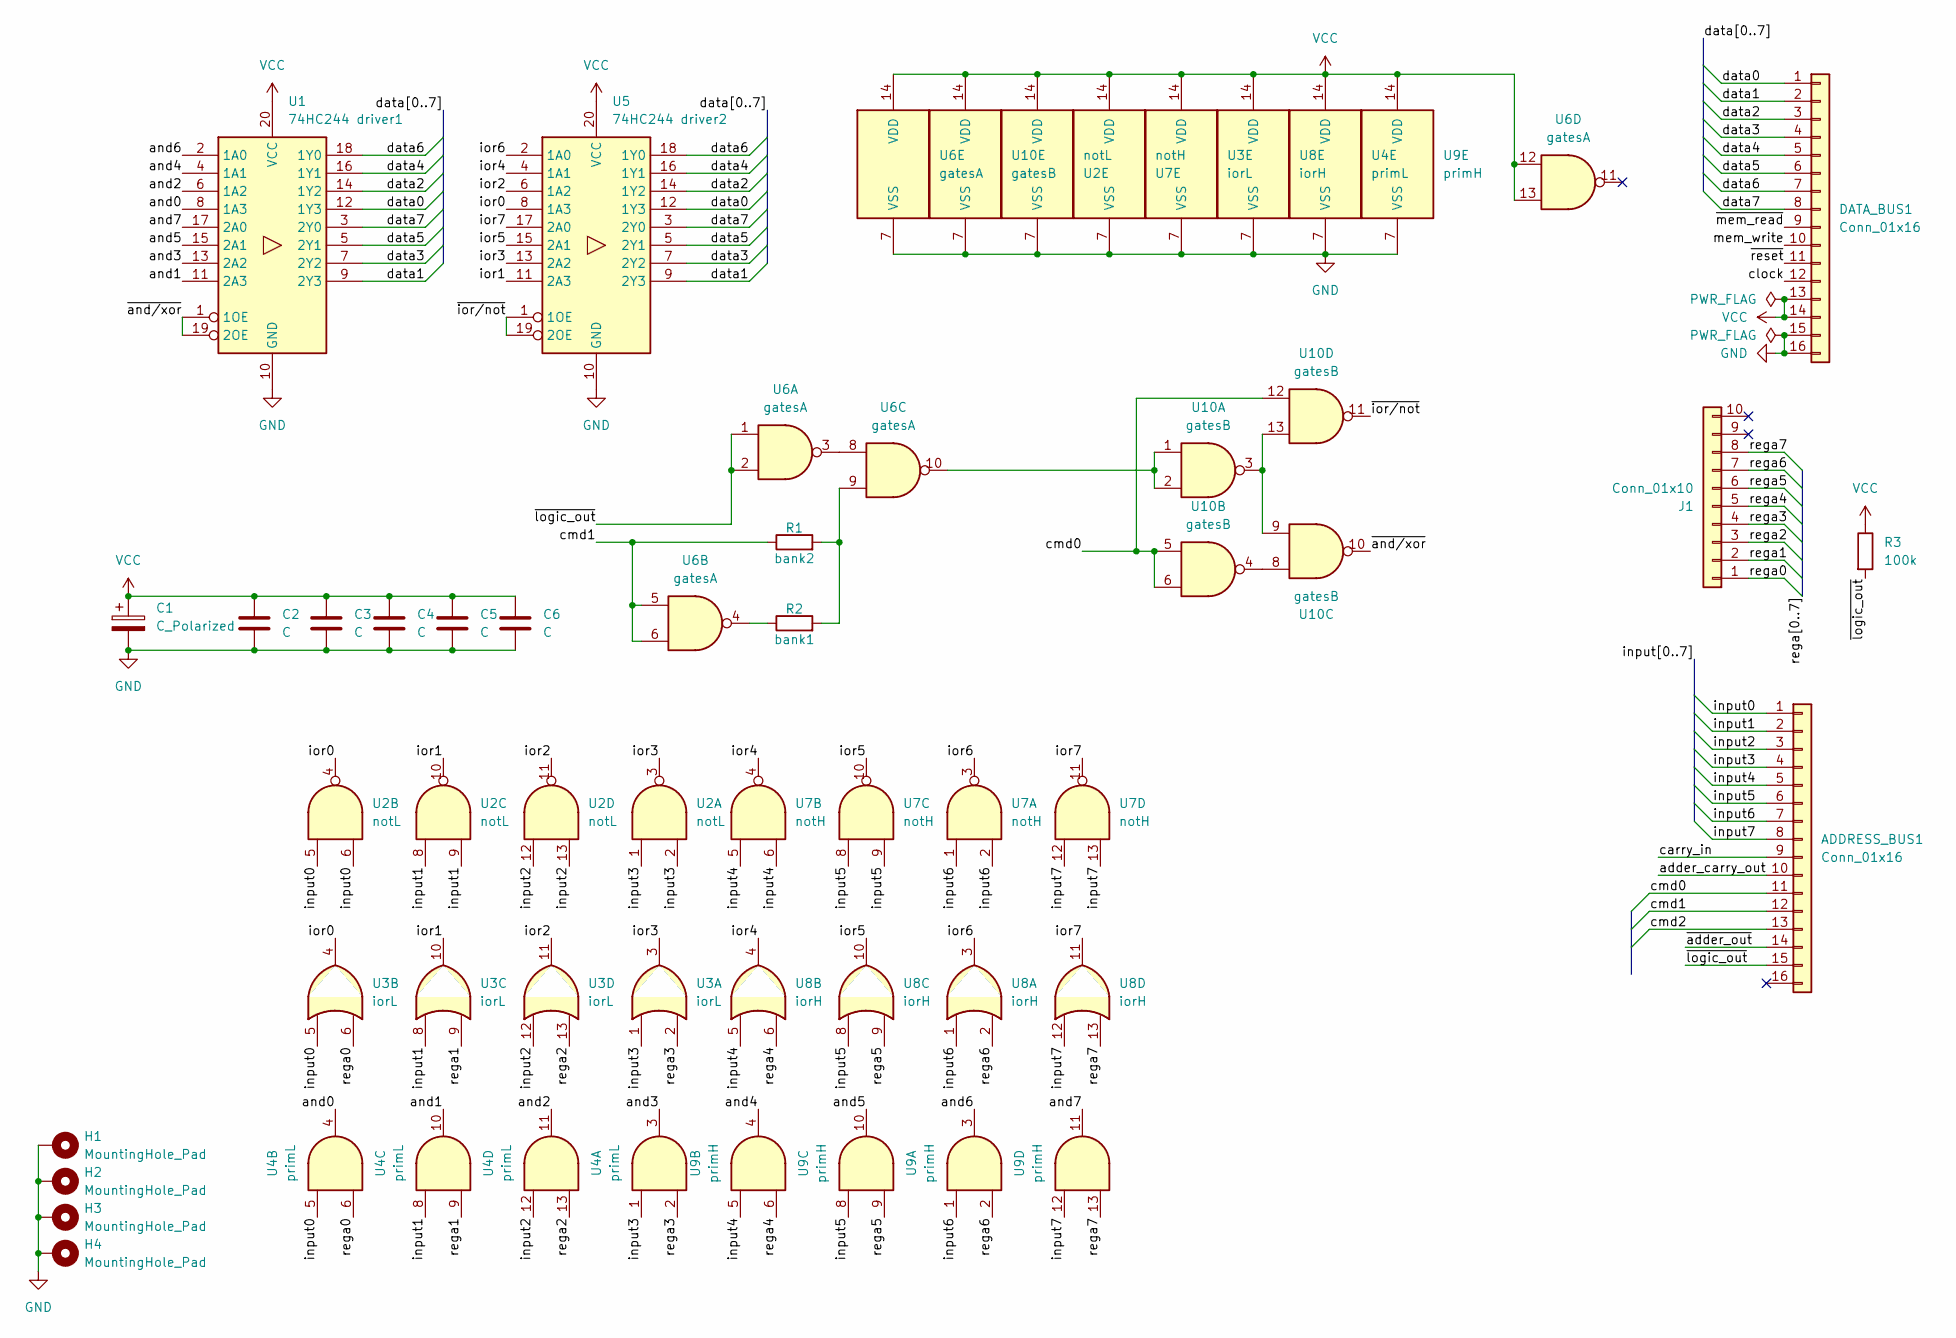
[picture p23: schematic alu_logic.kicad_sch, PC-06 ALU LOGIC UNIT]

Parts:
ADDRESS_BUS1: Conn_01x16; IDC-Header_2x08_P2.54mm_Horizontal
C1: C_Polarized; CP_Elec_5x5.3
C2, C3, C4, C5, C6: C; C_0603_1608Metric
DATA_BUS1: Conn_01x16; IDC-Header_2x08_P2.54mm_Horizontal
H1, H2, H3, H4: MountingHole_Pad; MountingHole_3.2mm_M3_Pad_Via
J1: Conn_01x10; IDC-Header_2x05_P2.54mm_Horizontal
R1: bank2; R_0603_1608Metric
R2: bank1; R_0603_1608Metric
R3: 100k; R_0603_1608Metric
U1: 74HC244 driver1; DIP-20_W7.62mm_LongPads
U2: notL; DIP-14_W7.62mm_LongPads
U3: iorL; DIP-14_W7.62mm_LongPads
U4: primL; DIP-14_W7.62mm_LongPads
U5: 74HC244 driver2; DIP-20_W7.62mm_LongPads
U6: gatesA; DIP-14_W7.62mm_LongPads
U7: notH; DIP-14_W7.62mm_LongPads
U8: iorH; DIP-14_W7.62mm_LongPads
U9: primH; DIP-14_W7.62mm_LongPads
U10: gatesB; DIP-14_W7.62mm_LongPads

Connections:
/adder_carry_out: ADDRESS_BUS1.10
/and0: U1.8 (1A3), U4.4
/and1: U1.11 (2A3), U4.10
/and2: U1.6 (1A2), U4.11
/and3: U1.13 (2A2), U4.3
/and4: U1.4 (1A1), U9.4
/and5: U1.15 (2A1), U9.10
/and6: U1.2 (1A0), U9.3
/and7: U1.17 (2A0), U9.11
/carry_in: ADDRESS_BUS1.9
/clock: DATA_BUS1.12
/cmd0: ADDRESS_BUS1.11, U10.5, U10.6, U10.12
/cmd1: ADDRESS_BUS1.12, R1.1, U6.5, U6.6
/cmd2: ADDRESS_BUS1.13
/data0: DATA_BUS1.1, U1.12 (1Y3), U5.12 (1Y3)
/data1: DATA_BUS1.2, U1.9 (2Y3), U5.9 (2Y3)
/data2: DATA_BUS1.3, U1.14 (1Y2), U5.14 (1Y2)
/data3: DATA_BUS1.4, U1.7 (2Y2), U5.7 (2Y2)
/data4: DATA_BUS1.5, U1.16 (1Y1), U5.16 (1Y1)
/data5: DATA_BUS1.6, U1.5 (2Y1), U5.5 (2Y1)
/data6: DATA_BUS1.7, U1.18 (1Y0), U5.18 (1Y0)
/data7: DATA_BUS1.8, U1.3 (2Y0), U5.3 (2Y0)
/input0: ADDRESS_BUS1.1, U2.5, U2.6, U3.5, U4.5
/input1: ADDRESS_BUS1.2, U2.8, U2.9, U3.8, U4.8
/input2: ADDRESS_BUS1.3, U2.12, U2.13, U3.12, U4.12
/input3: ADDRESS_BUS1.4, U2.1, U2.2, U3.1, U4.1
/input4: ADDRESS_BUS1.5, U7.5, U7.6, U8.5, U9.5
/input5: ADDRESS_BUS1.6, U7.8, U7.9, U8.8, U9.8
/input6: ADDRESS_BUS1.7, U7.1, U7.2, U8.1, U9.1
/input7: ADDRESS_BUS1.8, U7.12, U7.13, U8.12, U9.12
/ior0: U2.4, U3.4, U5.8 (1A3)
/ior1: U2.10, U3.10, U5.11 (2A3)
/ior2: U2.11, U3.11, U5.6 (1A2)
/ior3: U2.3, U3.3, U5.13 (2A2)
/ior4: U5.4 (1A1), U7.4, U8.4
/ior5: U5.15 (2A1), U7.10, U8.10
/ior6: U5.2 (1A0), U7.3, U8.3
/ior7: U5.17 (2A0), U7.11, U8.11
/mem_write: DATA_BUS1.10
/rega0: J1.1, U3.6, U4.6
/rega1: J1.2, U3.9, U4.9
/rega2: J1.3, U3.13, U4.13
/rega3: J1.4, U3.2, U4.2
/rega4: J1.5, U8.6, U9.6
/rega5: J1.6, U8.9, U9.9
/rega6: J1.7, U8.2, U9.2
/rega7: J1.8, U8.13, U9.13
/~adder_out: ADDRESS_BUS1.14
/~and/xor: U1.1 (1OE), U1.19 (2OE), U10.10
/~ior/not: U5.1 (1OE), U5.19 (2OE), U10.11
/~logic_out: ADDRESS_BUS1.15, R3.2, U6.1, U6.2
/~mem_read: DATA_BUS1.9
/~reset: DATA_BUS1.11
GND: C1.2, C2.2, C3.2, C4.2, C5.2, C6.2, DATA_BUS1.15, DATA_BUS1.16, H1.1, H2.1, H3.1, H4.1, U1.10 (GND), U2.7 (VSS), U3.7 (VSS), U4.7 (VSS), U5.10 (GND), U6.7 (VSS), U7.7 (VSS), U8.7 (VSS), U9.7 (VSS), U10.7 (VSS)
unnamed: R1.2, R2.2, U6.9
unnamed: R2.1, U6.4
unnamed: U6.3, U6.8
unnamed: U6.10, U10.1, U10.2
unnamed: U10.4, U10.8
unnamed: U10.3, U10.9, U10.13
VCC: C1.1, C2.1, C3.1, C4.1, C5.1, C6.1, DATA_BUS1.13, DATA_BUS1.14, R3.1, U1.20 (VCC), U2.14 (VDD), U3.14 (VDD), U4.14 (VDD), U5.20 (VCC), U6.12, U6.13, U6.14 (VDD), U7.14 (VDD), U8.14 (VDD), U9.14 (VDD), U10.14 (VDD)

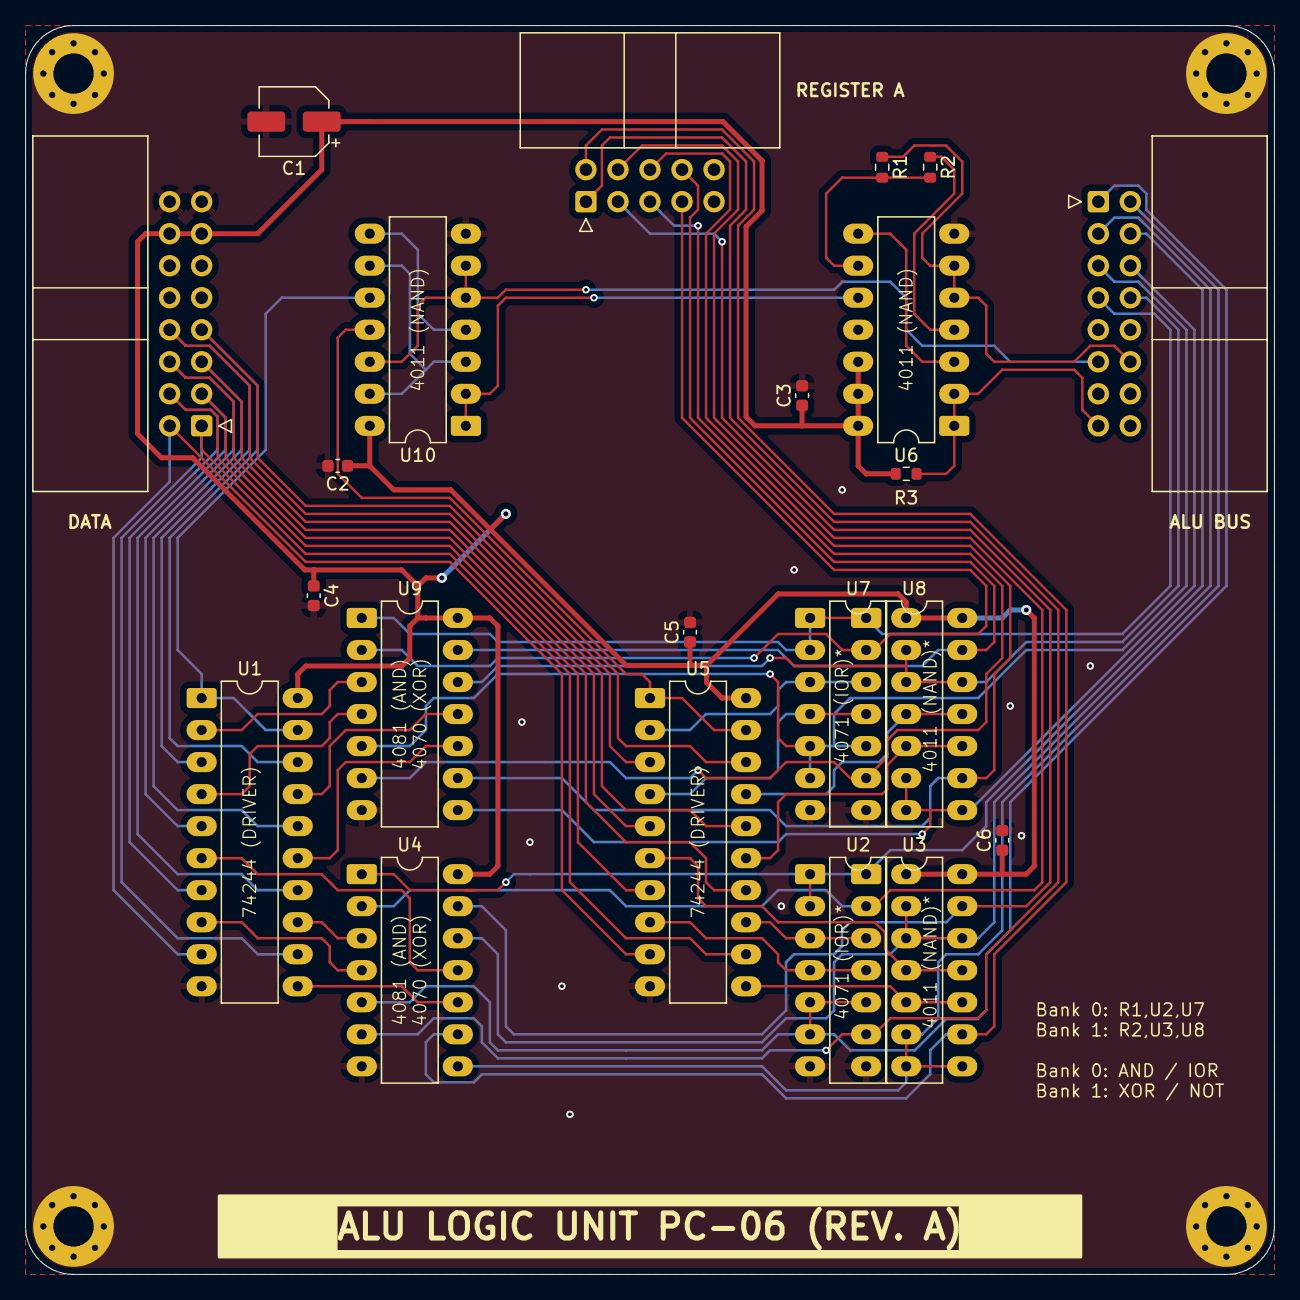
[picture p24: board alu_logic.kicad_pcb from above]

Board: 2 copper layers, 99.1 x 99.1 mm, 26 parts (0 on the bottom side), 53 nets.
