ksmonkey123/8bit_computer/circuits/pc-09_orchestrator_interconnect/orchestrator_interconnect.kicad_pcb

## KiCad design circuits/pc-09_orchestrator_interconnect/orchestrator_interconnect.kicad_pcb (2025-03-04)

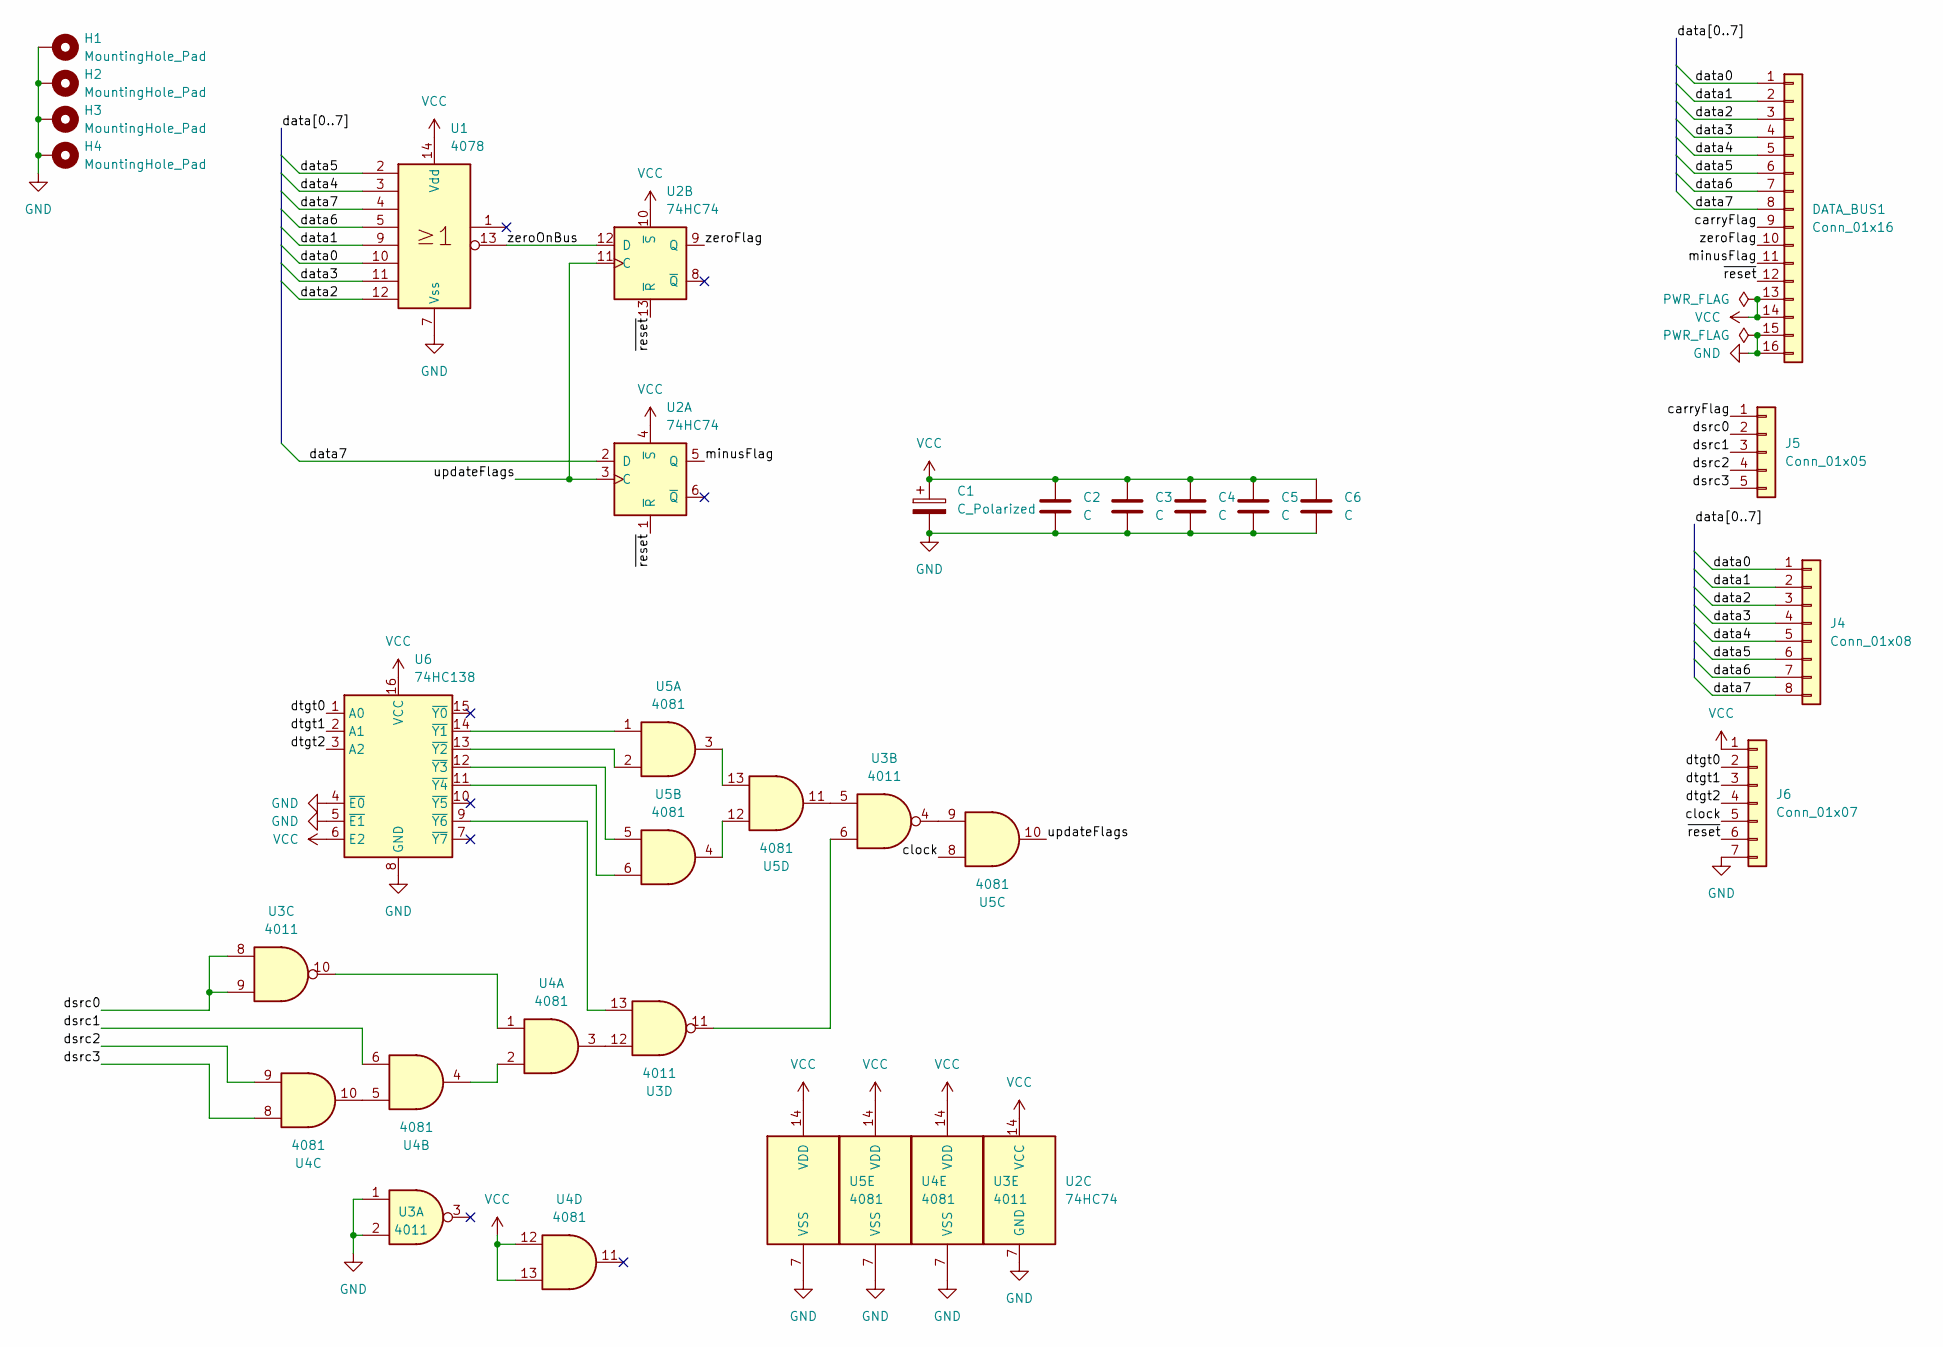
[picture p25: schematic orchestrator_interconnect.kicad_sch, PC-09 Orchestrator Interconnect]

Parts:
C1: C_Polarized; CP_Elec_5x5.3
C2, C3, C4, C5, C6: C; C_0603_1608Metric
DATA_BUS1: Conn_01x16; IDC-Header_2x08_P2.54mm_Horizontal
H1, H2, H3, H4: MountingHole_Pad; MountingHole_3.2mm_M3_Pad_Via
J4: Conn_01x08; PinSocket_1x08_P2.54mm_Vertical
J5: Conn_01x05; PinSocket_1x05_P2.54mm_Vertical
J6: Conn_01x07; PinSocket_1x07_P2.54mm_Vertical
U1: 4078; DIP-14_W7.62mm_LongPads
U2: 74HC74; DIP-14_W7.62mm_LongPads
U3: 4011; DIP-14_W7.62mm_LongPads
U4, U5: 4081; DIP-14_W7.62mm_LongPads
U6: 74HC138; DIP-16_W7.62mm_LongPads

Connections:
/carryFlag: DATA_BUS1.9, J5.1
/clock: J6.5, U5.8
/data0: DATA_BUS1.1, J4.1, U1.10
/data1: DATA_BUS1.2, J4.2, U1.9
/data2: DATA_BUS1.3, J4.3, U1.12
/data3: DATA_BUS1.4, J4.4, U1.11
/data4: DATA_BUS1.5, J4.5, U1.3
/data5: DATA_BUS1.6, J4.6, U1.2
/data6: DATA_BUS1.7, J4.7, U1.5
/data7: DATA_BUS1.8, J4.8, U1.4, U2.2 (D)
/dsrc0: J5.2, U3.8, U3.9
/dsrc1: J5.3, U4.6
/dsrc2: J5.4, U4.9
/dsrc3: J5.5, U4.8
/dtgt0: J6.2, U6.1 (A0)
/dtgt1: J6.3, U6.2 (A1)
/dtgt2: J6.4, U6.3 (A2)
/minusFlag: DATA_BUS1.11, U2.5 (Q)
/updateFlags: U2.3 (C), U2.11 (C), U5.10
/zeroFlag: DATA_BUS1.10, U2.9 (Q)
/zeroOnBus: U1.13, U2.12 (D)
/~reset: DATA_BUS1.12, J6.6, U2.1 (~R), U2.13 (~R)
GND: C1.2, C2.2, C3.2, C4.2, C5.2, C6.2, DATA_BUS1.15, DATA_BUS1.16, H1.1, H2.1, H3.1, H4.1, J6.7, U1.7 (Vss), U2.7 (GND), U3.1, U3.2, U3.7 (VSS), U4.7 (VSS), U5.7 (VSS), U6.4 (~E0), U6.5 (~E1), U6.8 (GND)
unnamed: U3.4, U5.9
unnamed: U3.5, U5.11
unnamed: U3.10, U4.1
unnamed: U3.6, U3.11
unnamed: U3.12, U4.3
unnamed: U4.2, U4.4
unnamed: U4.5, U4.10
unnamed: U5.4, U5.12
unnamed: U5.3, U5.13
unnamed: U5.1, U6.14 (~Y1)
unnamed: U5.2, U6.13 (~Y2)
unnamed: U5.5, U6.12 (~Y3)
unnamed: U5.6, U6.11 (~Y4)
unnamed: U3.13, U6.9 (~Y6)
VCC: C1.1, C2.1, C3.1, C4.1, C5.1, C6.1, DATA_BUS1.13, DATA_BUS1.14, J6.1, U1.14 (Vdd), U2.4 (~S), U2.10 (~S), U2.14 (VCC), U3.14 (VDD), U4.12, U4.13, U4.14 (VDD), U5.14 (VDD), U6.6 (E2), U6.16 (VCC)

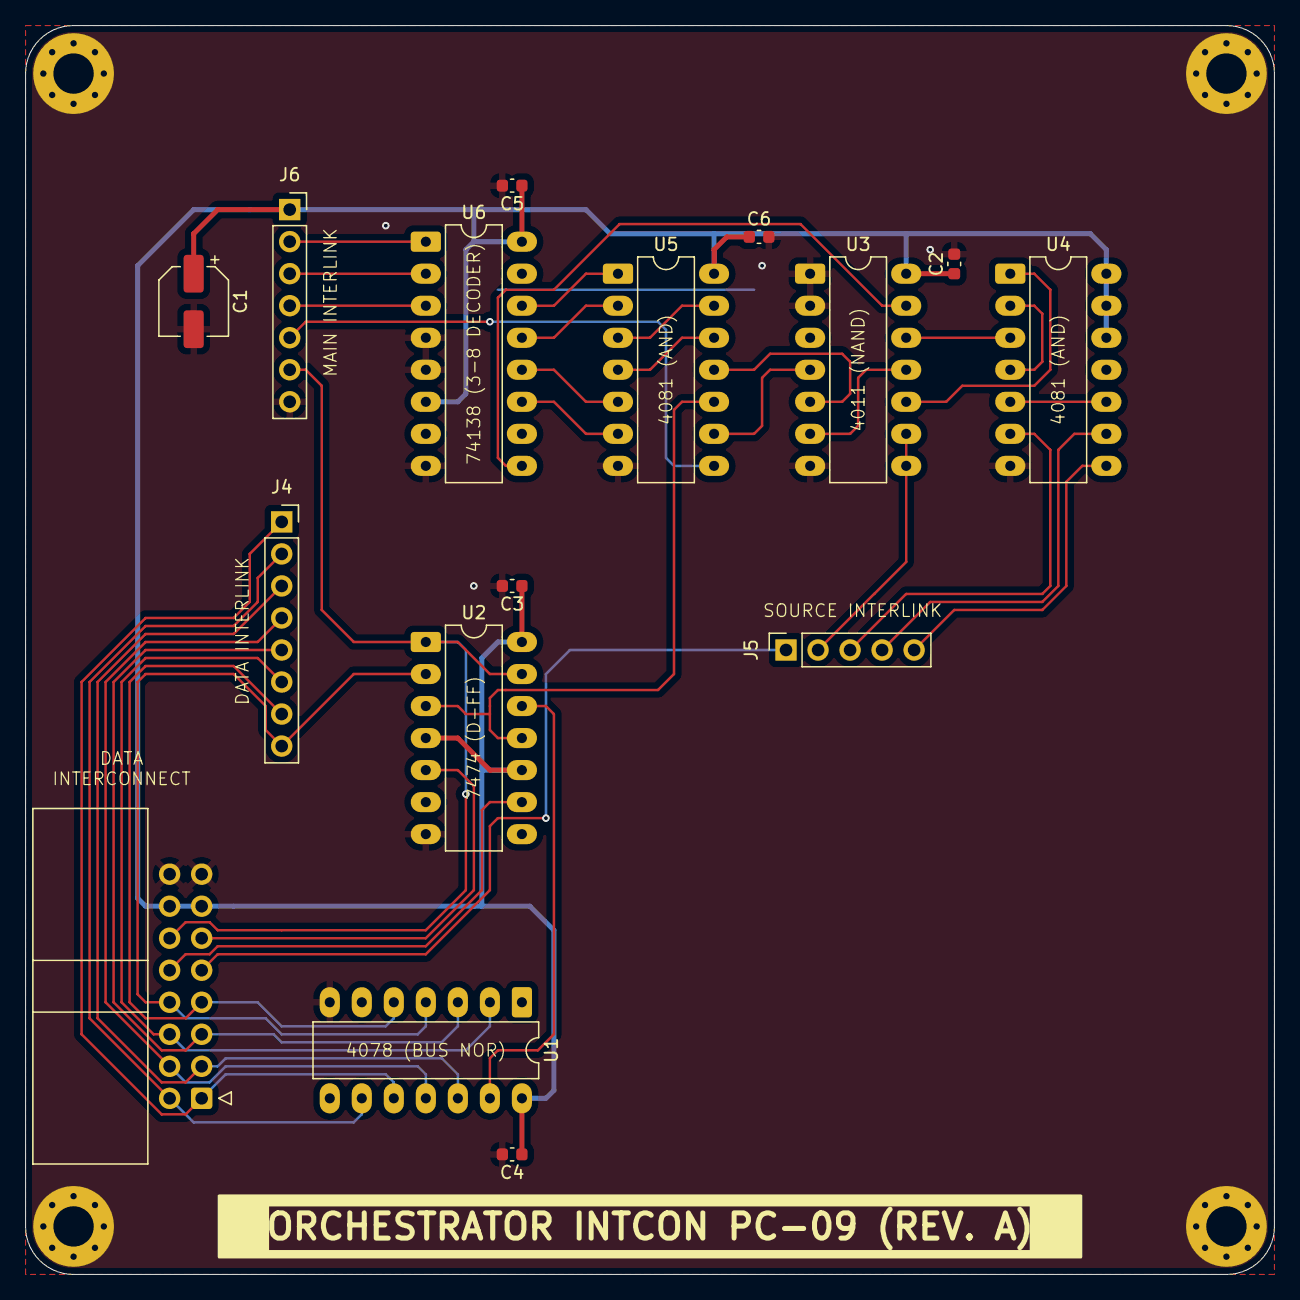
[picture p26: board orchestrator_interconnect.kicad_pcb from above]

Board: 2 copper layers, 99.1 x 99.1 mm, 20 parts (0 on the bottom side), 38 nets.
