ksmonkey123/8bit_computer/circuits/pc-01_dual_8bit_register/dual_8bit_register.kicad_pcb

## KiCad design circuits/pc-01_dual_8bit_register/dual_8bit_register.kicad_pcb (2025-03-04)

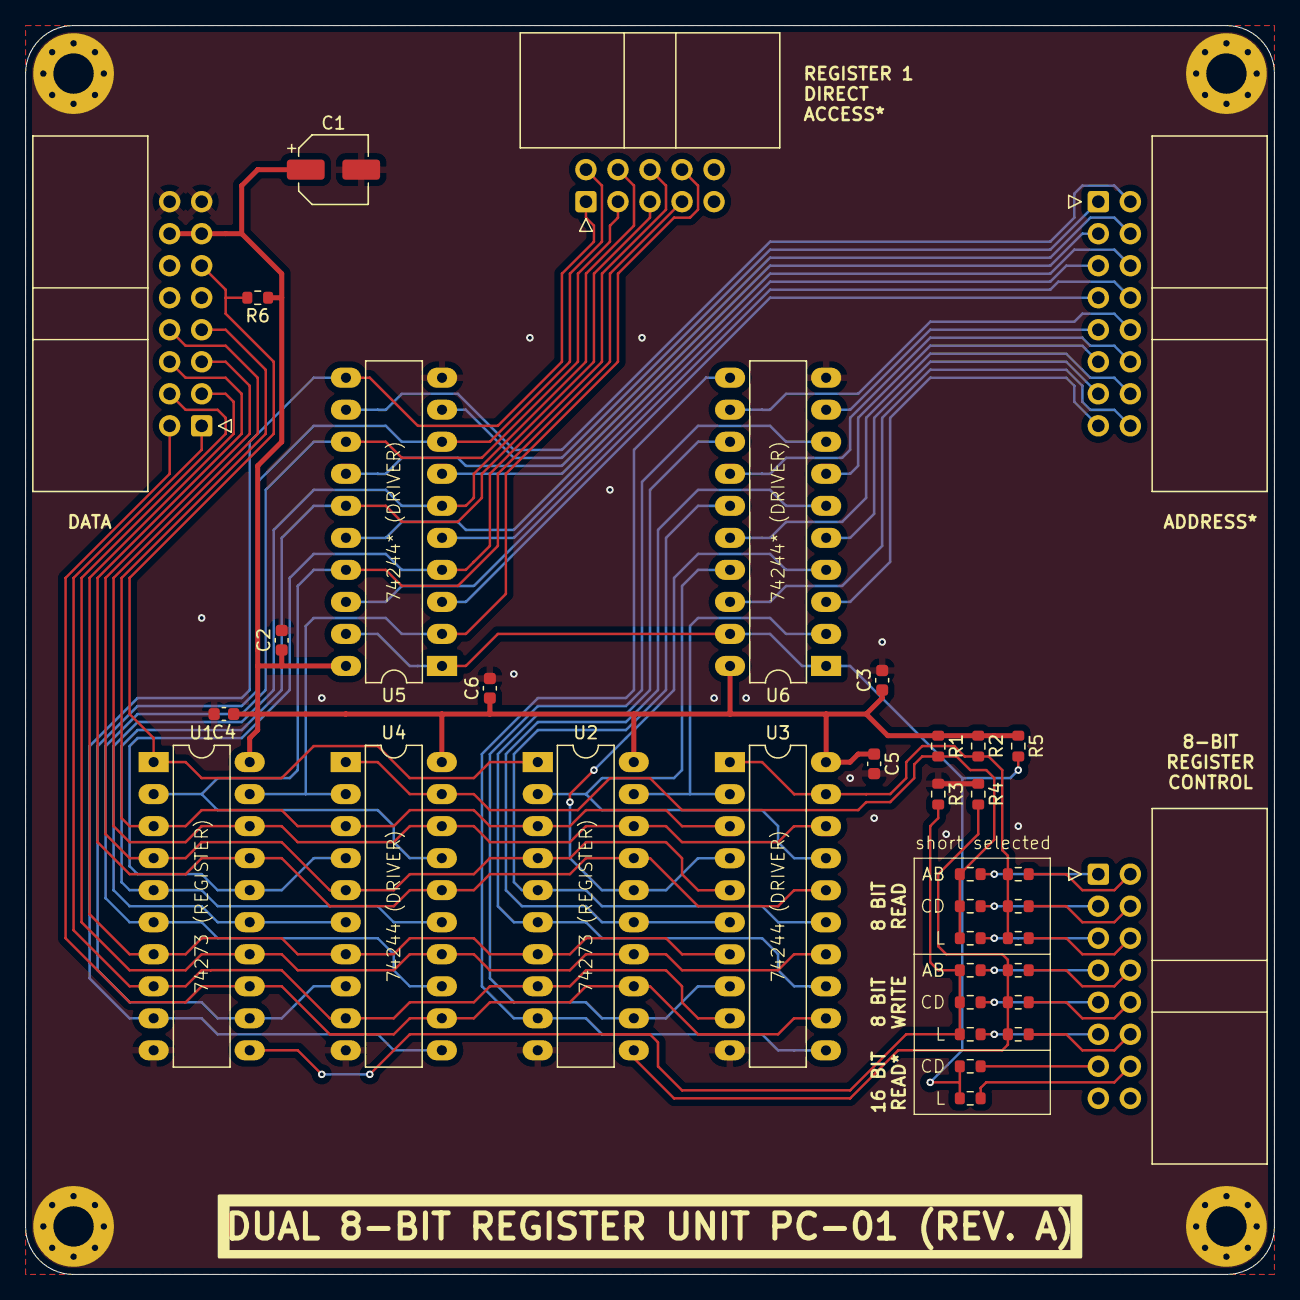
[picture p27: board dual_8bit_register.kicad_pcb from above]

Board: 2 copper layers, 99.1 x 99.1 mm, 40 parts (0 on the bottom side), 62 nets.

Parts:
ADDRESS_BUS1: Conn_01x16; IDC-Header_2x08_P2.54mm_Horizontal
C1: C_Polarized; CP_Elec_5x5.3
C2, C3, C4, C5, C6: C; C_0603_1608Metric
CTRL_BUS1: Conn_01x16; IDC-Header_2x08_P2.54mm_Horizontal
DATA_BUS1: Conn_01x16; IDC-Header_2x08_P2.54mm_Horizontal
H1, H2, H3, H4: MountingHole_Pad; MountingHole_3.2mm_M3_Pad_Via
J1: Conn_01x10; IDC-Header_2x05_P2.54mm_Horizontal
R1, R2, R3, R4, R5, R6: R; R_0603_1608Metric
R_adrCD1: R; R_0603_1608Metric
R_adrL1: R; R_0603_1608Metric
R_readA1: R; R_0603_1608Metric
R_readB1: R; R_0603_1608Metric
R_readC1: R; R_0603_1608Metric
R_readD1: R; R_0603_1608Metric
R_readL1, R_readL2: R; R_0603_1608Metric
R_writeA1: R; R_0603_1608Metric
R_writeB1: R; R_0603_1608Metric
R_writeC1: R; R_0603_1608Metric
R_writeD1: R; R_0603_1608Metric
R_writeL1, R_writeL2: R; R_0603_1608Metric
U1, U2: 74HC273; DIP-20_W7.62mm_LongPads
U3, U4, U5, U6: 74HC244; DIP-20_W7.62mm_LongPads

Connections:
/adr0: ADDRESS_BUS1.1, U5.9 (2Y3)
/adr1: ADDRESS_BUS1.2, U5.12 (1Y3)
/adr2: ADDRESS_BUS1.3, U5.7 (2Y2)
/adr3: ADDRESS_BUS1.4, U5.14 (1Y2)
/adr4: ADDRESS_BUS1.5, U5.5 (2Y1)
/adr5: ADDRESS_BUS1.6, U5.16 (1Y1)
/adr6: ADDRESS_BUS1.7, U5.3 (2Y0)
/adr7: ADDRESS_BUS1.8, U5.18 (1Y0)
/adr8: ADDRESS_BUS1.9, U6.9 (2Y3)
/adr9: ADDRESS_BUS1.10, U6.12 (1Y3)
/adr10: ADDRESS_BUS1.11, U6.7 (2Y2)
/adr11: ADDRESS_BUS1.12, U6.14 (1Y2)
/adr12: ADDRESS_BUS1.13, U6.5 (2Y1)
/adr13: ADDRESS_BUS1.14, U6.16 (1Y1)
/adr14: ADDRESS_BUS1.15, U6.3 (2Y0)
/adr15: ADDRESS_BUS1.16, U6.18 (1Y0)
/d0: DATA_BUS1.1, U1.8 (D3), U2.8 (D3), U3.9 (2Y3), U4.9 (2Y3)
/d1: DATA_BUS1.2, U1.13 (D4), U2.13 (D4), U3.12 (1Y3), U4.12 (1Y3)
/d2: DATA_BUS1.3, U1.7 (D2), U2.7 (D2), U3.7 (2Y2), U4.7 (2Y2)
/d3: DATA_BUS1.4, U1.14 (D5), U2.14 (D5), U3.14 (1Y2), U4.14 (1Y2)
/d4: DATA_BUS1.5, U1.4 (D1), U2.4 (D1), U3.5 (2Y1), U4.5 (2Y1)
/d5: DATA_BUS1.6, U1.17 (D6), U2.17 (D6), U3.16 (1Y1), U4.16 (1Y1)
/d6: DATA_BUS1.7, U1.3 (D0), U2.3 (D0), U3.3 (2Y0), U4.3 (2Y0)
/d7: DATA_BUS1.8, U1.18 (D7), U2.18 (D7), U3.18 (1Y0), U4.18 (1Y0)
/writeA: CTRL_BUS1.7, R_writeA1.1
/writeB: CTRL_BUS1.8, R_writeB1.1
/writeC: CTRL_BUS1.9, R_writeC1.1
/writeD: CTRL_BUS1.10, R_writeD1.1
/writeL1: CTRL_BUS1.11, R_writeL1.1
/writeL2: CTRL_BUS1.12, R_writeL2.1
/~adrCD: CTRL_BUS1.13, R_adrCD1.2
/~adrL: CTRL_BUS1.14, R_adrL1.2
/~readA: CTRL_BUS1.1, R_readA1.2
/~readB: CTRL_BUS1.2, R_readB1.2
/~readC: CTRL_BUS1.3, R_readC1.2
/~readD: CTRL_BUS1.4, R_readD1.2
/~readL1: CTRL_BUS1.5, R_readL1.2
/~readL2: CTRL_BUS1.6, R_readL2.2
/~reset: DATA_BUS1.11, R6.2, U1.1 (~Mr), U2.1 (~Mr)
GND: C1.2, C2.2, C3.2, C4.2, C5.2, C6.2, DATA_BUS1.15, DATA_BUS1.16, H1.1, H2.1, H3.1, H4.1, R3.1, R4.1, U1.10 (GND), U2.10 (GND), U3.10 (GND), U4.10 (GND), U5.10 (GND), U6.10 (GND)
unnamed: J1.1, U1.9 (Q3), U4.11 (2A3), U5.11 (2A3)
unnamed: J1.2, U1.12 (Q4), U4.8 (1A3), U5.8 (1A3)
unnamed: J1.3, U1.6 (Q2), U4.13 (2A2), U5.13 (2A2)
unnamed: J1.4, U1.15 (Q5), U4.6 (1A2), U5.6 (1A2)
unnamed: J1.5, U1.5 (Q1), U4.15 (2A1), U5.15 (2A1)
unnamed: J1.6, U1.16 (Q6), U4.4 (1A1), U5.4 (1A1)
unnamed: J1.7, U1.2 (Q0), U4.17 (2A0), U5.17 (2A0)
unnamed: J1.8, U1.19 (Q7), U4.2 (1A0), U5.2 (1A0)
unnamed: R3.2, R_writeA1.2, R_writeC1.2, R_writeL1.2, U1.11 (Cp)
unnamed: R4.2, R_writeB1.2, R_writeD1.2, R_writeL2.2, U2.11 (Cp)
unnamed: U2.2 (Q0), U3.17 (2A0), U6.17 (2A0)
unnamed: U2.5 (Q1), U3.15 (2A1), U6.15 (2A1)
unnamed: U2.6 (Q2), U3.13 (2A2), U6.13 (2A2)
unnamed: U2.9 (Q3), U3.11 (2A3), U6.11 (2A3)
unnamed: U2.12 (Q4), U3.8 (1A3), U6.8 (1A3)
unnamed: U2.15 (Q5), U3.6 (1A2), U6.6 (1A2)
unnamed: U2.16 (Q6), U3.4 (1A1), U6.4 (1A1)
unnamed: U2.19 (Q7), U3.2 (1A0), U6.2 (1A0)
unnamed: R2.2, R_readB1.1, R_readD1.1, R_readL2.1, U3.1 (1OE), U3.19 (2OE)
unnamed: R1.2, R_readA1.1, R_readC1.1, R_readL1.1, U4.1 (1OE), U4.19 (2OE)
unnamed: R5.2, R_adrCD1.1, R_adrL1.1, U5.1 (1OE), U5.19 (2OE), U6.1 (1OE), U6.19 (2OE)
VCC: C1.1, C2.1, C3.1, C4.1, C5.1, C6.1, DATA_BUS1.13, DATA_BUS1.14, R1.1, R2.1, R5.1, R6.1, U1.20 (VCC), U2.20 (VCC), U3.20 (VCC), U4.20 (VCC), U5.20 (VCC), U6.20 (VCC)
