ksmonkey123/8bit_computer/circuits/pc-05_alu_adder/alu_adder.kicad_pcb

## KiCad design circuits/pc-05_alu_adder/alu_adder.kicad_pcb (2025-03-04)

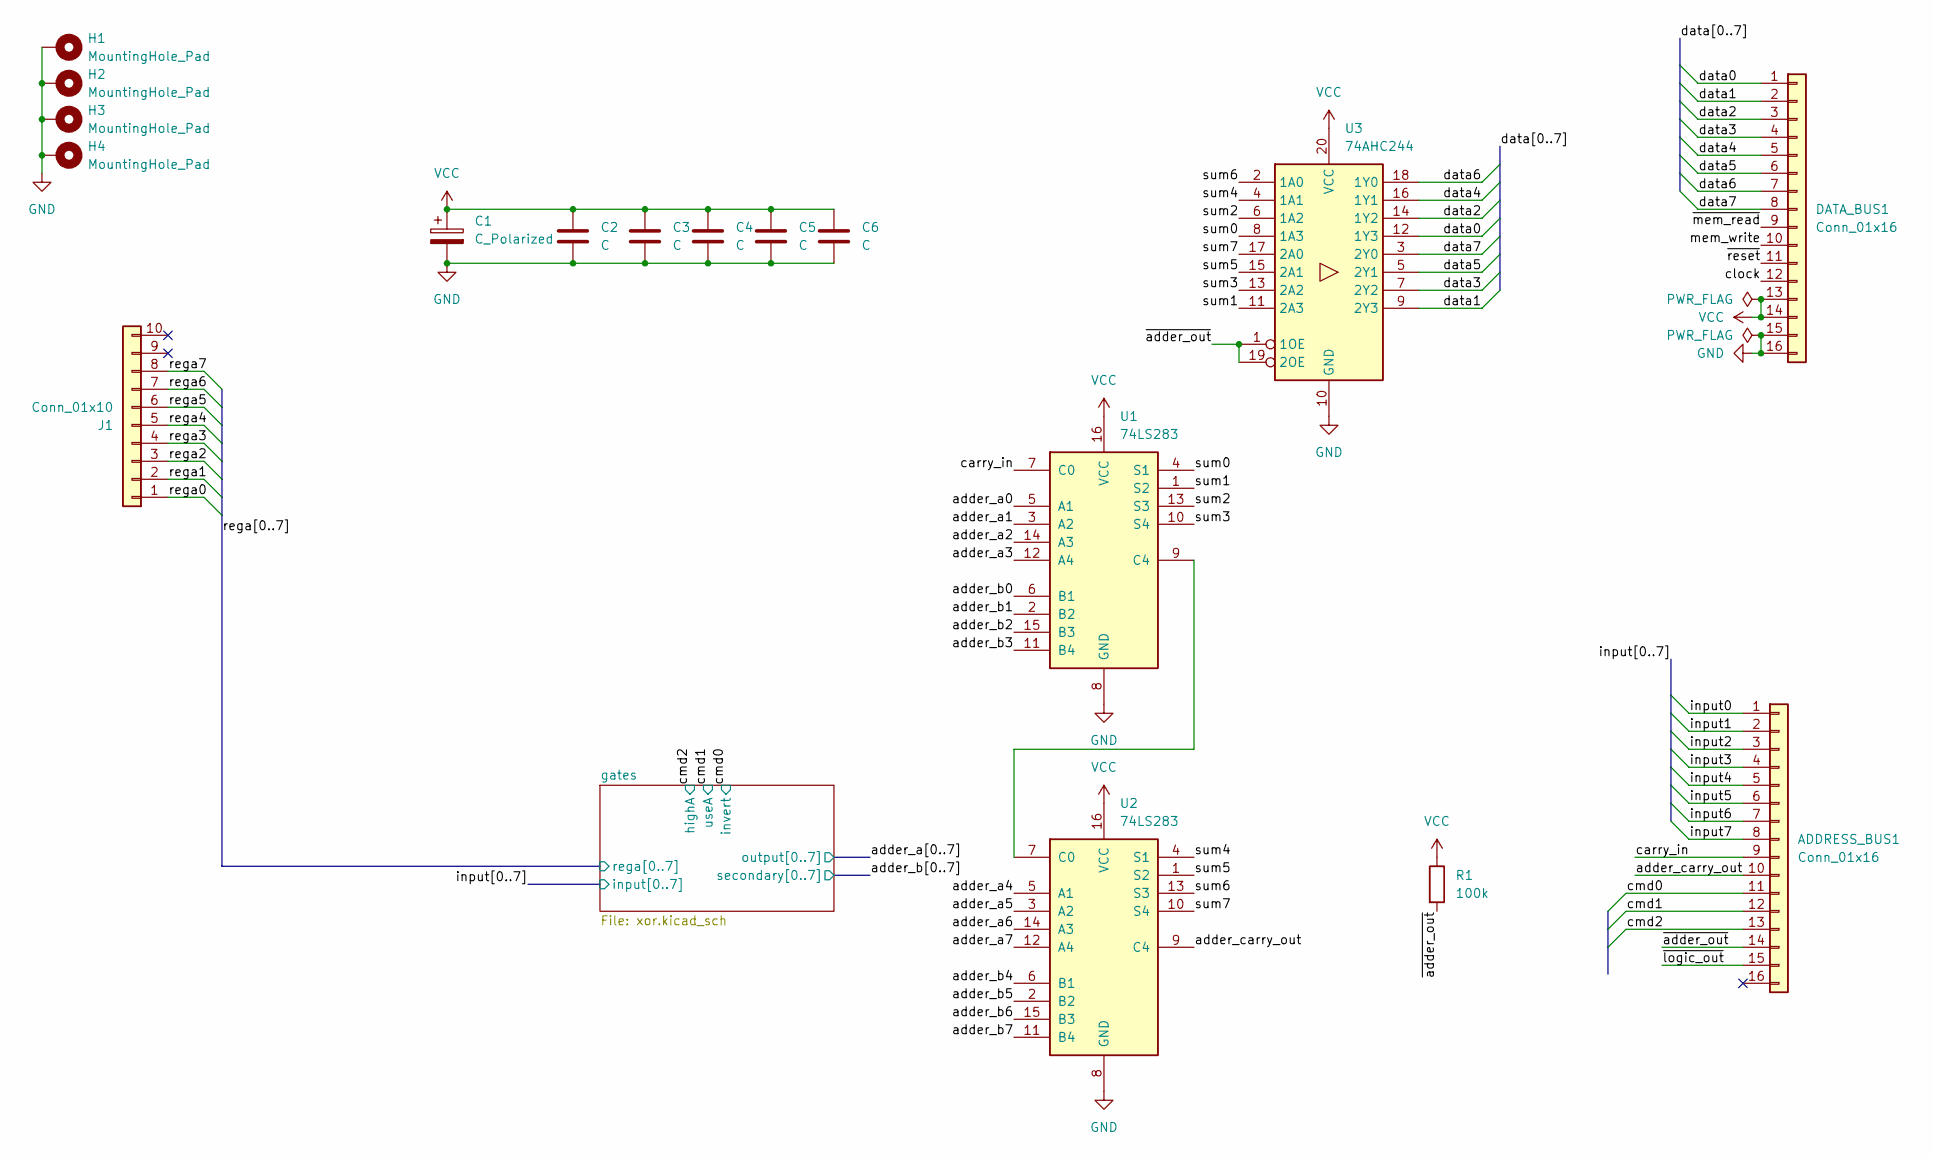
[picture p28: schematic alu_adder.kicad_sch, PC-05 ALU Adder Unit]

Parts:
ADDRESS_BUS1: Conn_01x16; IDC-Header_2x08_P2.54mm_Horizontal
C1: C_Polarized; CP_Elec_5x5.3
C2, C3, C4, C5, C6: C; C_0603_1608Metric
DATA_BUS1: Conn_01x16; IDC-Header_2x08_P2.54mm_Horizontal
H1, H2, H3, H4: MountingHole_Pad; MountingHole_3.2mm_M3_Pad_Via
J1: Conn_01x10; IDC-Header_2x05_P2.54mm_Horizontal
R1: 100k; R_0603_1608Metric
U1, U2: 74LS283; DIP-16_W7.62mm_LongPads
U3: 74AHC244; DIP-20_W7.62mm_LongPads

Connections:
/adder_a0: U1.5 (A1); also elsewhere on the board
/adder_a1: U1.3 (A2); also elsewhere on the board
/adder_a2: U1.14 (A3); also elsewhere on the board
/adder_a3: U1.12 (A4); also elsewhere on the board
/adder_a4: U2.5 (A1); also elsewhere on the board
/adder_a5: U2.3 (A2); also elsewhere on the board
/adder_a6: U2.14 (A3); also elsewhere on the board
/adder_a7: U2.12 (A4); also elsewhere on the board
/adder_b0: U1.6 (B1); also elsewhere on the board
/adder_b1: U1.2 (B2); also elsewhere on the board
/adder_b2: U1.15 (B3); also elsewhere on the board
/adder_b3: U1.11 (B4); also elsewhere on the board
/adder_b4: U2.6 (B1); also elsewhere on the board
/adder_b5: U2.2 (B2); also elsewhere on the board
/adder_b6: U2.15 (B3); also elsewhere on the board
/adder_b7: U2.11 (B4); also elsewhere on the board
/adder_carry_out: ADDRESS_BUS1.10, U2.9 (C4)
/carry_in: ADDRESS_BUS1.9, U1.7 (C0)
/clock: DATA_BUS1.12
/cmd0: ADDRESS_BUS1.11; also elsewhere on the board
/cmd1: ADDRESS_BUS1.12; also elsewhere on the board
/cmd2: ADDRESS_BUS1.13; also elsewhere on the board
/data0: DATA_BUS1.1, U3.12 (1Y3)
/data1: DATA_BUS1.2, U3.9 (2Y3)
/data2: DATA_BUS1.3, U3.14 (1Y2)
/data3: DATA_BUS1.4, U3.7 (2Y2)
/data4: DATA_BUS1.5, U3.16 (1Y1)
/data5: DATA_BUS1.6, U3.5 (2Y1)
/data6: DATA_BUS1.7, U3.18 (1Y0)
/data7: DATA_BUS1.8, U3.3 (2Y0)
/input0: ADDRESS_BUS1.1; also elsewhere on the board
/input1: ADDRESS_BUS1.2; also elsewhere on the board
/input2: ADDRESS_BUS1.3; also elsewhere on the board
/input3: ADDRESS_BUS1.4; also elsewhere on the board
/input4: ADDRESS_BUS1.5; also elsewhere on the board
/input5: ADDRESS_BUS1.6; also elsewhere on the board
/input6: ADDRESS_BUS1.7; also elsewhere on the board
/input7: ADDRESS_BUS1.8; also elsewhere on the board
/mem_write: DATA_BUS1.10
/rega0: J1.1; also elsewhere on the board
/rega1: J1.2; also elsewhere on the board
/rega2: J1.3; also elsewhere on the board
/rega3: J1.4; also elsewhere on the board
/rega4: J1.5; also elsewhere on the board
/rega5: J1.6; also elsewhere on the board
/rega6: J1.7; also elsewhere on the board
/rega7: J1.8; also elsewhere on the board
/sum0: U1.4 (S1), U3.8 (1A3)
/sum1: U1.1 (S2), U3.11 (2A3)
/sum2: U1.13 (S3), U3.6 (1A2)
/sum3: U1.10 (S4), U3.13 (2A2)
/sum4: U2.4 (S1), U3.4 (1A1)
/sum5: U2.1 (S2), U3.15 (2A1)
/sum6: U2.13 (S3), U3.2 (1A0)
/sum7: U2.10 (S4), U3.17 (2A0)
/~adder_out: ADDRESS_BUS1.14, R1.2, U3.1 (1OE), U3.19 (2OE)
/~logic_out: ADDRESS_BUS1.15
/~mem_read: DATA_BUS1.9
/~reset: DATA_BUS1.11
GND: C1.2, C2.2, C3.2, C4.2, C5.2, C6.2, DATA_BUS1.15, DATA_BUS1.16, H1.1, H2.1, H3.1, H4.1, U1.8 (GND), U2.8 (GND), U3.10 (GND); also elsewhere on the board
unnamed: U1.9 (C4), U2.7 (C0)
VCC: C1.1, C2.1, C3.1, C4.1, C5.1, C6.1, DATA_BUS1.13, DATA_BUS1.14, R1.1, U1.16 (VCC), U2.16 (VCC), U3.20 (VCC); also elsewhere on the board

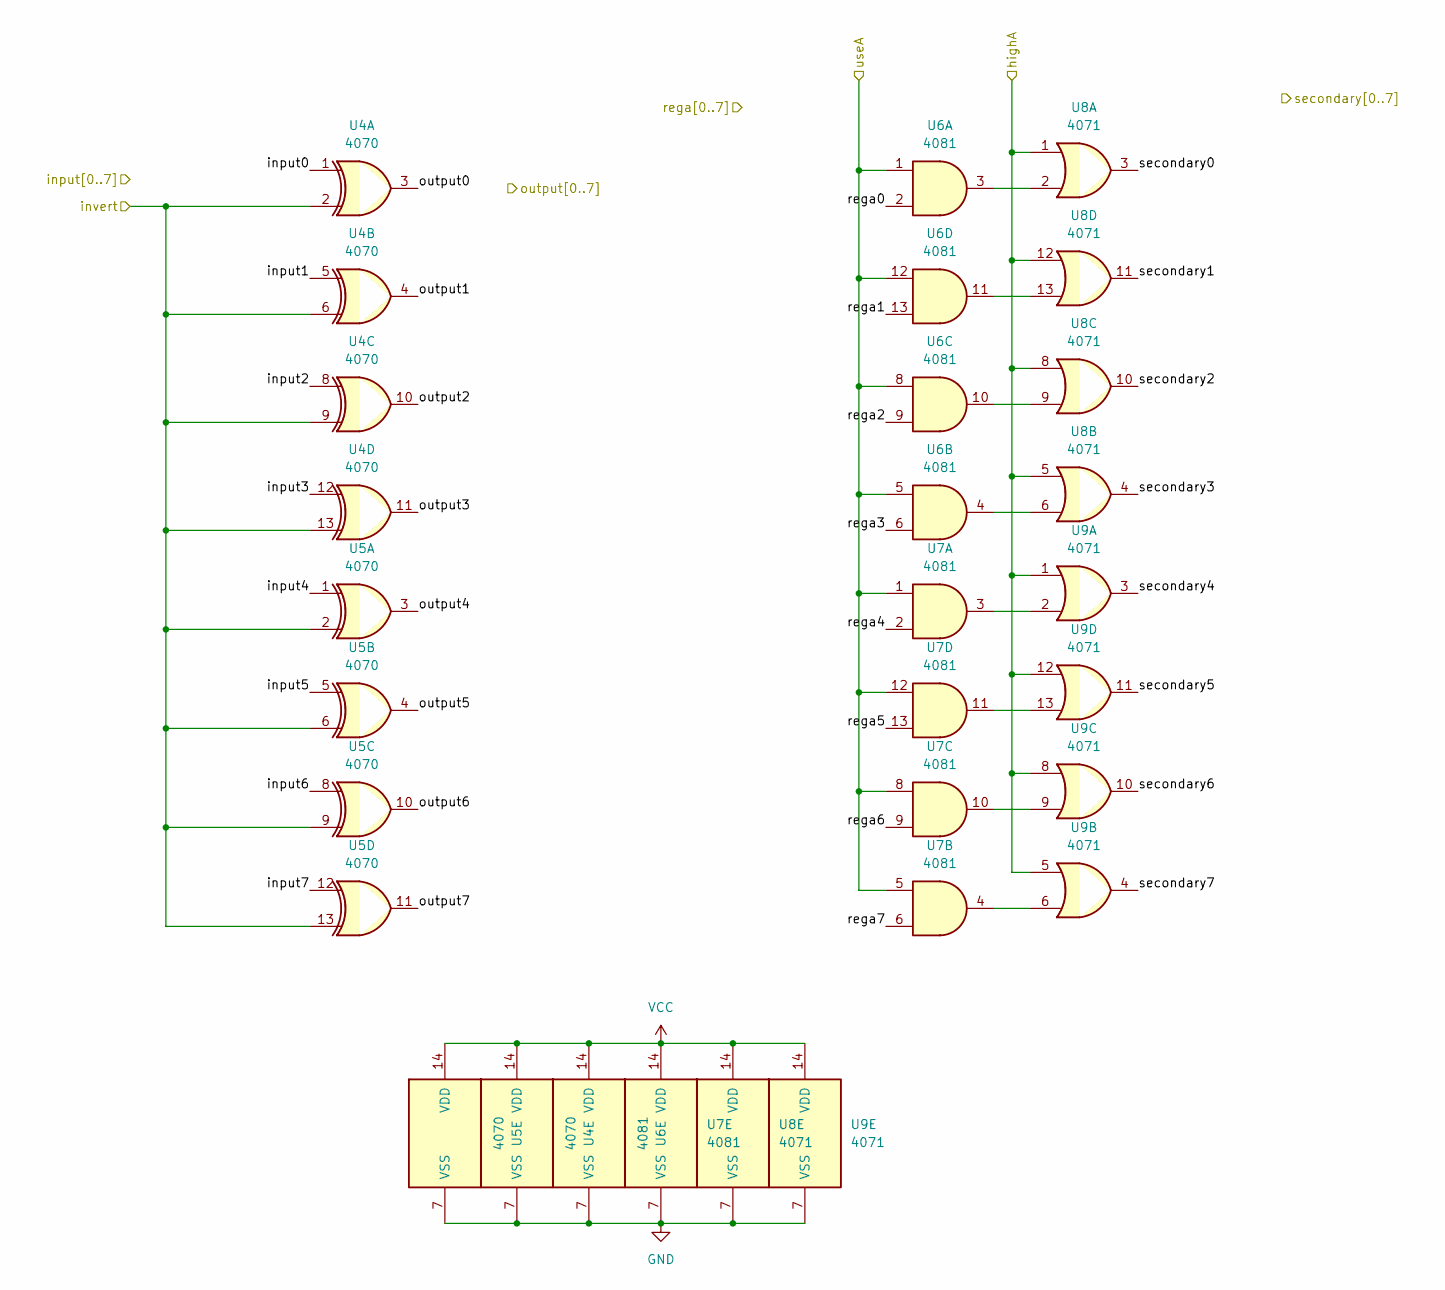
[picture p29: schematic xor.kicad_sch, PC-05 ALU Adder Unit]

Parts:
U4, U5: 4070; DIP-14_W7.62mm_LongPads
U6, U7: 4081; DIP-14_W7.62mm_LongPads
U8, U9: 4071; DIP-14_W7.62mm_LongPads

Connections:
/adder_a0: U4.3; also elsewhere on the board
/adder_a1: U4.4; also elsewhere on the board
/adder_a2: U4.10; also elsewhere on the board
/adder_a3: U4.11; also elsewhere on the board
/adder_a4: U5.3; also elsewhere on the board
/adder_a5: U5.4; also elsewhere on the board
/adder_a6: U5.10; also elsewhere on the board
/adder_a7: U5.11; also elsewhere on the board
/adder_b0: U8.3; also elsewhere on the board
/adder_b1: U8.11; also elsewhere on the board
/adder_b2: U8.10; also elsewhere on the board
/adder_b3: U8.4; also elsewhere on the board
/adder_b4: U9.3; also elsewhere on the board
/adder_b5: U9.11; also elsewhere on the board
/adder_b6: U9.10; also elsewhere on the board
/adder_b7: U9.4; also elsewhere on the board
/cmd0: U4.2, U4.6, U4.9, U4.13, U5.2, U5.6, U5.9, U5.13; also elsewhere on the board
/cmd1: U6.1, U6.5, U6.8, U6.12, U7.1, U7.5, U7.8, U7.12; also elsewhere on the board
/cmd2: U8.1, U8.5, U8.8, U8.12, U9.1, U9.5, U9.8, U9.12; also elsewhere on the board
/input0: U4.1; also elsewhere on the board
/input1: U4.5; also elsewhere on the board
/input2: U4.8; also elsewhere on the board
/input3: U4.12; also elsewhere on the board
/input4: U5.1; also elsewhere on the board
/input5: U5.5; also elsewhere on the board
/input6: U5.8; also elsewhere on the board
/input7: U5.12; also elsewhere on the board
/rega0: U6.2; also elsewhere on the board
/rega1: U6.13; also elsewhere on the board
/rega2: U6.9; also elsewhere on the board
/rega3: U6.6; also elsewhere on the board
/rega4: U7.2; also elsewhere on the board
/rega5: U7.13; also elsewhere on the board
/rega6: U7.9; also elsewhere on the board
/rega7: U7.6; also elsewhere on the board
GND: U4.7 (VSS), U5.7 (VSS), U6.7 (VSS), U7.7 (VSS), U8.7 (VSS), U9.7 (VSS); also elsewhere on the board
unnamed: U6.3, U8.2
unnamed: U6.4, U8.6
unnamed: U6.10, U8.9
unnamed: U6.11, U8.13
unnamed: U7.3, U9.2
unnamed: U7.4, U9.6
unnamed: U7.10, U9.9
unnamed: U7.11, U9.13
VCC: U4.14 (VDD), U5.14 (VDD), U6.14 (VDD), U7.14 (VDD), U8.14 (VDD), U9.14 (VDD); also elsewhere on the board

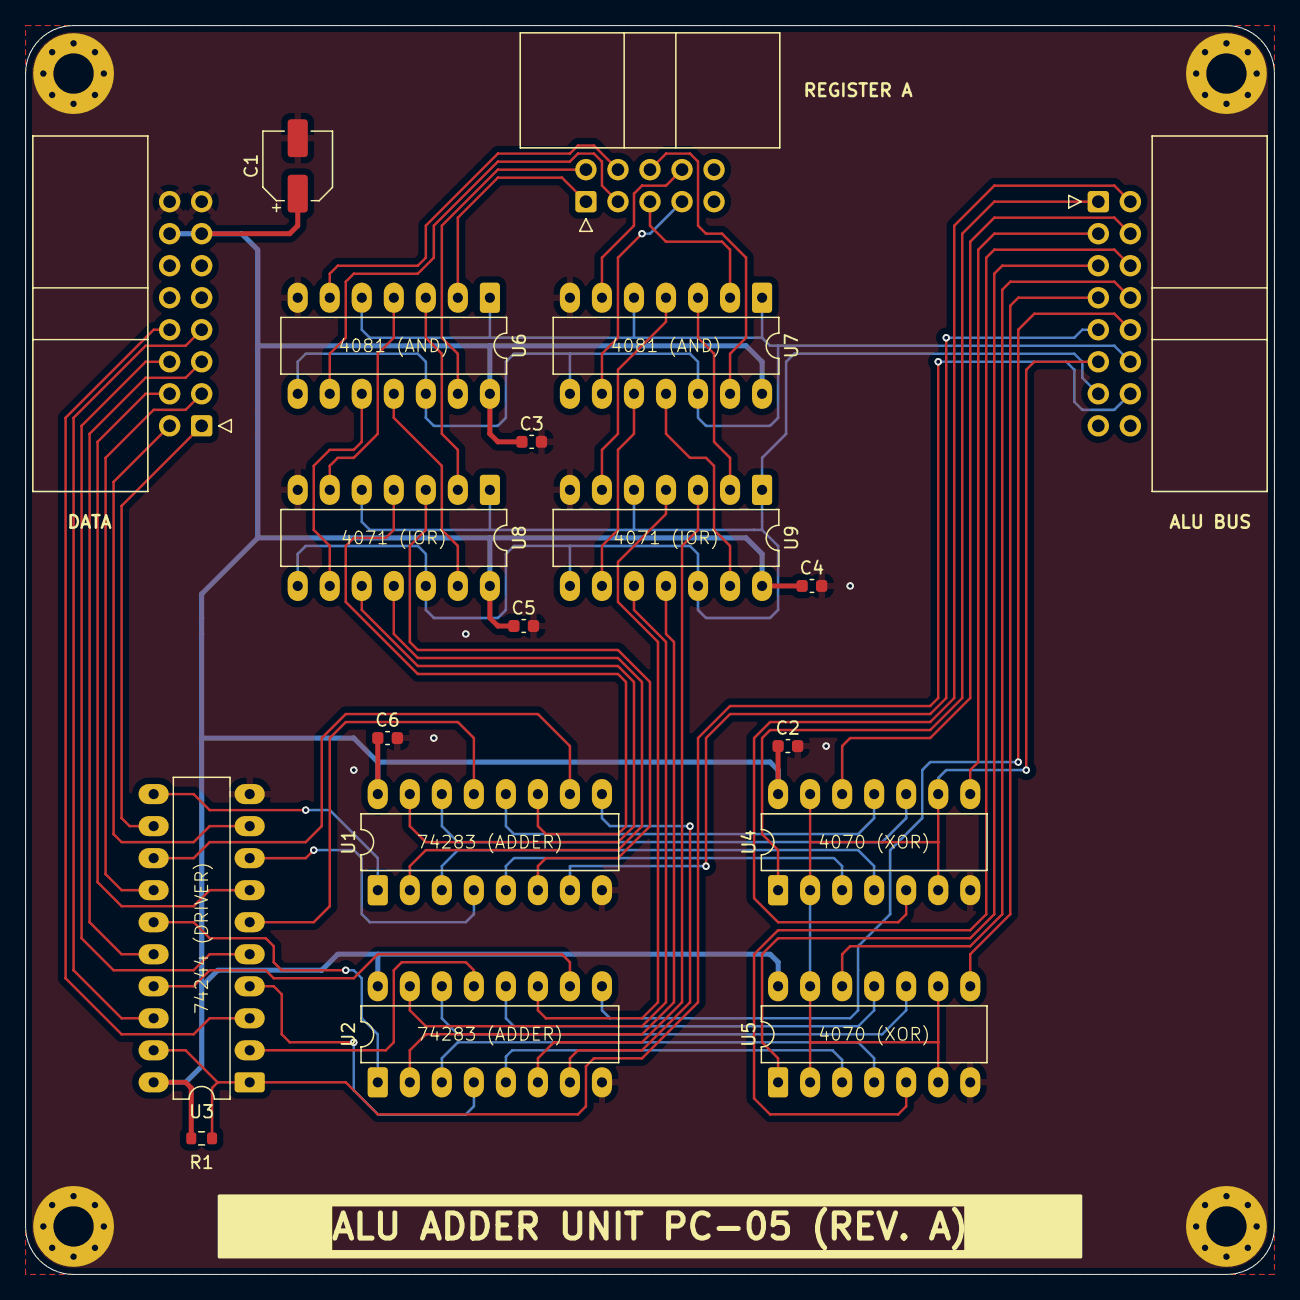
[picture p30: board alu_adder.kicad_pcb from above]

Board: 2 copper layers, 99.1 x 99.1 mm, 23 parts (0 on the bottom side), 65 nets.
