ksmonkey123/8bit_computer/circuits/pc-04_alu_backplane/pc-04_alu_backplane.kicad_pcb

## KiCad design circuits/pc-04_alu_backplane/pc-04_alu_backplane.kicad_pcb (2025-03-04)

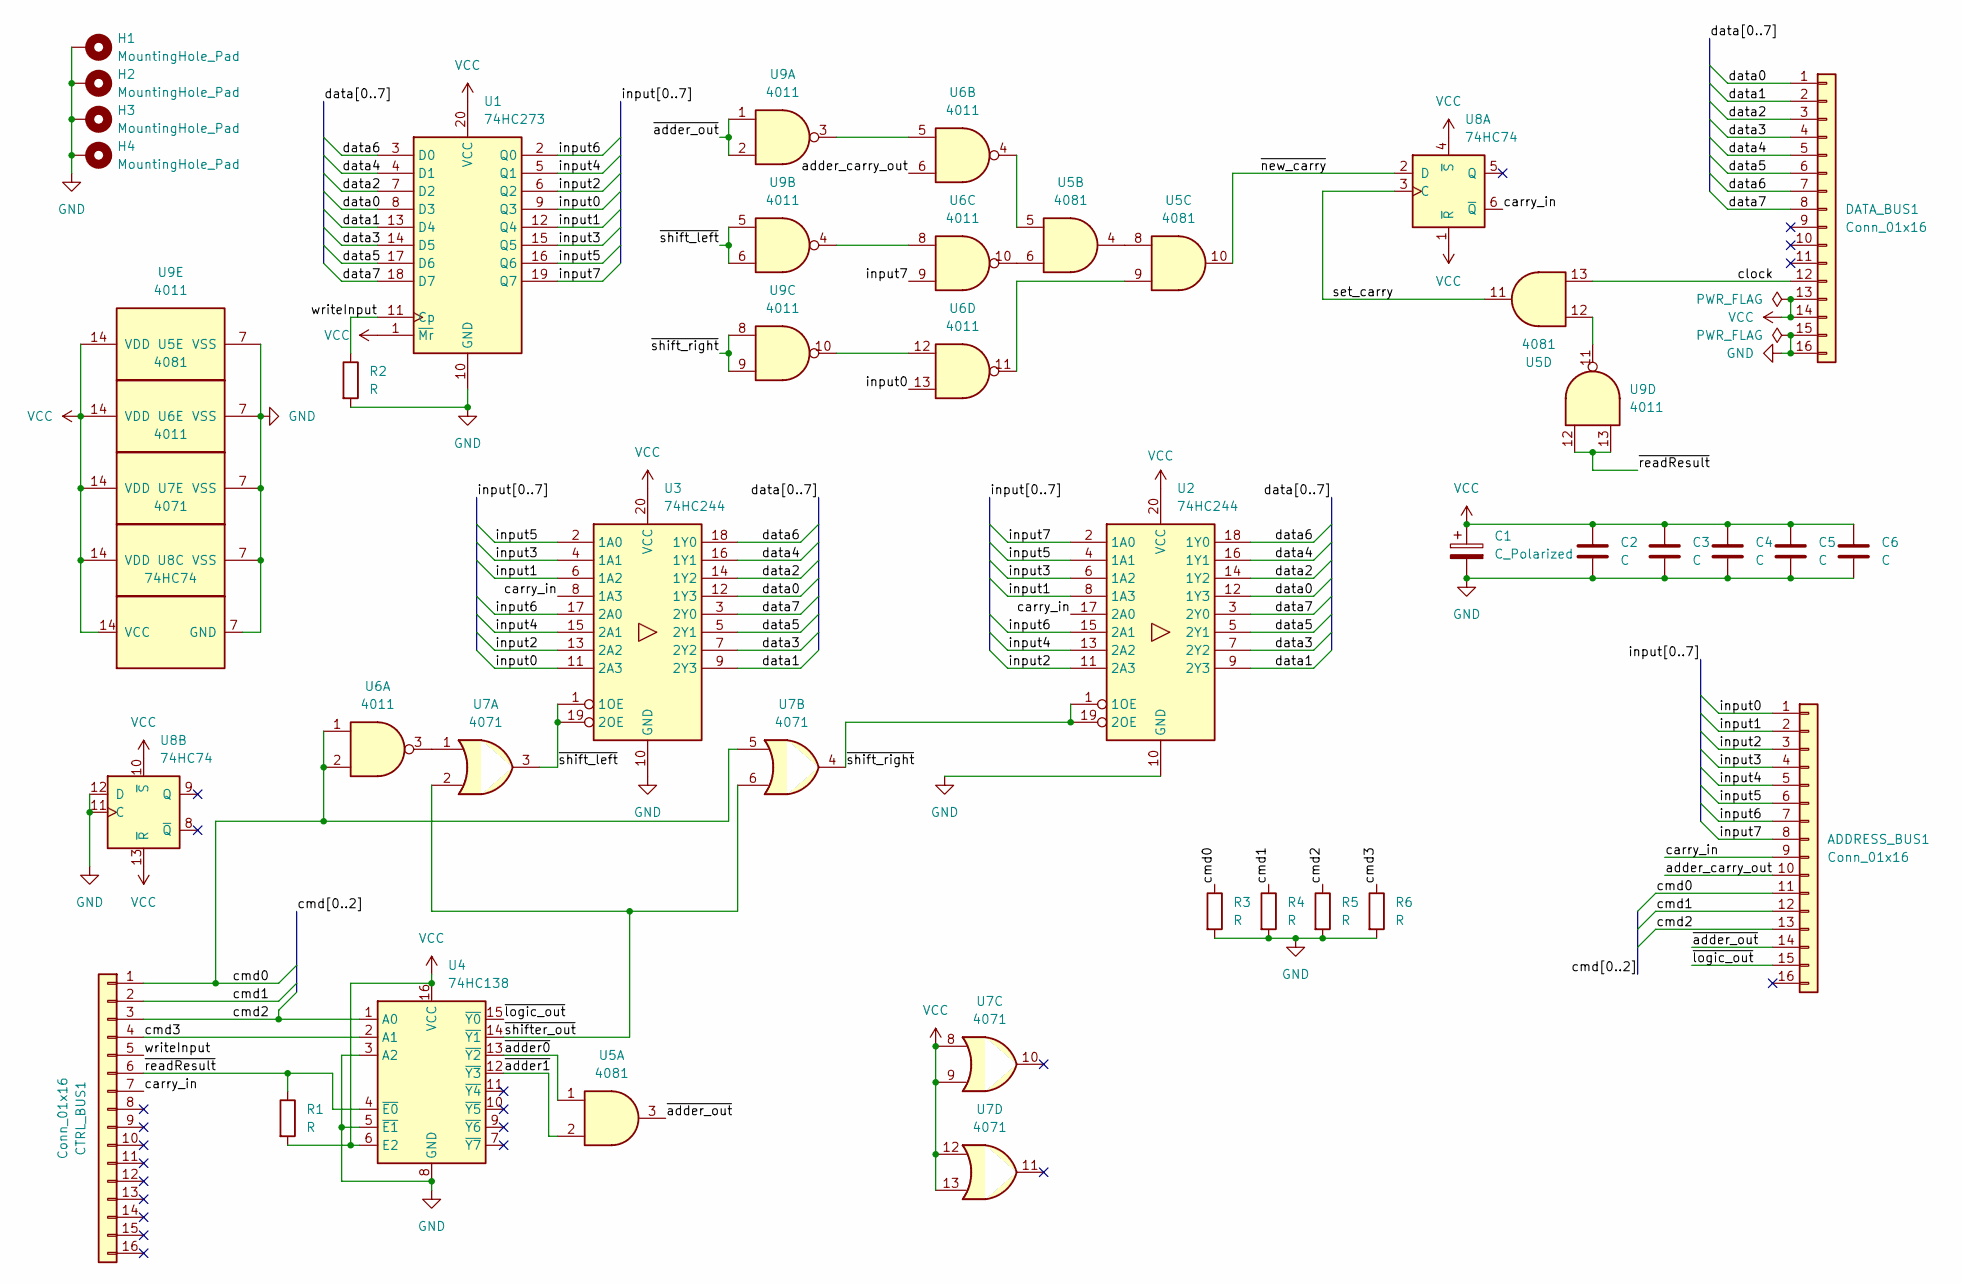
[picture p31: schematic pc-04_alu_backplane.kicad_sch, PC-04 ALU Backplane]

Parts:
ADDRESS_BUS1: Conn_01x16; IDC-Header_2x08_P2.54mm_Horizontal
C1: C_Polarized; CP_Elec_5x5.3
C2, C3, C4, C5, C6: C; C_0603_1608Metric
CTRL_BUS1: Conn_01x16; IDC-Header_2x08_P2.54mm_Horizontal
DATA_BUS1: Conn_01x16; IDC-Header_2x08_P2.54mm_Horizontal
H1, H2, H3, H4: MountingHole_Pad; MountingHole_3.2mm_M3_Pad_Via
R1, R2, R3, R4, R5, R6: R; R_0603_1608Metric
U1: 74HC273; DIP-20_W7.62mm_LongPads
U2, U3: 74HC244; DIP-20_W7.62mm_LongPads
U4: 74HC138; DIP-16_W7.62mm_LongPads
U5: 4081; DIP-14_W7.62mm_LongPads
U6, U9: 4011; DIP-14_W7.62mm_LongPads
U7: 4071; DIP-14_W7.62mm_LongPads
U8: 74HC74; DIP-14_W7.62mm_LongPads

Connections:
/adder_carry_out: ADDRESS_BUS1.10, U6.6
/carry_in: ADDRESS_BUS1.9, CTRL_BUS1.7, U2.17 (2A0), U3.8 (1A3), U8.6 (~Q)
/clock: DATA_BUS1.12, U5.13
/cmd0: ADDRESS_BUS1.11, CTRL_BUS1.1, R3.1, U6.1, U6.2, U7.5
/cmd1: ADDRESS_BUS1.12, CTRL_BUS1.2, R4.1
/cmd2: ADDRESS_BUS1.13, CTRL_BUS1.3, R5.1, U4.1 (A0)
/cmd3: CTRL_BUS1.4, R6.1, U4.2 (A1)
/data0: DATA_BUS1.1, U1.8 (D3), U2.12 (1Y3), U3.12 (1Y3)
/data1: DATA_BUS1.2, U1.13 (D4), U2.9 (2Y3), U3.9 (2Y3)
/data2: DATA_BUS1.3, U1.7 (D2), U2.14 (1Y2), U3.14 (1Y2)
/data3: DATA_BUS1.4, U1.14 (D5), U2.7 (2Y2), U3.7 (2Y2)
/data4: DATA_BUS1.5, U1.4 (D1), U2.16 (1Y1), U3.16 (1Y1)
/data5: DATA_BUS1.6, U1.17 (D6), U2.5 (2Y1), U3.5 (2Y1)
/data6: DATA_BUS1.7, U1.3 (D0), U2.18 (1Y0), U3.18 (1Y0)
/data7: DATA_BUS1.8, U1.18 (D7), U2.3 (2Y0), U3.3 (2Y0)
/input0: ADDRESS_BUS1.1, U1.9 (Q3), U3.11 (2A3), U6.13
/input1: ADDRESS_BUS1.2, U1.12 (Q4), U2.8 (1A3), U3.6 (1A2)
/input2: ADDRESS_BUS1.3, U1.6 (Q2), U2.11 (2A3), U3.13 (2A2)
/input3: ADDRESS_BUS1.4, U1.15 (Q5), U2.6 (1A2), U3.4 (1A1)
/input4: ADDRESS_BUS1.5, U1.5 (Q1), U2.13 (2A2), U3.15 (2A1)
/input5: ADDRESS_BUS1.6, U1.16 (Q6), U2.4 (1A1), U3.2 (1A0)
/input6: ADDRESS_BUS1.7, U1.2 (Q0), U2.15 (2A1), U3.17 (2A0)
/input7: ADDRESS_BUS1.8, U1.19 (Q7), U2.2 (1A0), U6.9
/set_carry: U5.11, U8.3 (C)
/writeInput: CTRL_BUS1.5, R2.1, U1.11 (Cp)
/~adder0: U4.13 (~Y2), U5.1
/~adder1: U4.12 (~Y3), U5.2
/~adder_out: ADDRESS_BUS1.14, U5.3, U9.1, U9.2
/~logic_out: ADDRESS_BUS1.15, U4.15 (~Y0)
/~new_carry: U5.10, U8.2 (D)
/~readResult: CTRL_BUS1.6, R1.1, U4.4 (~E0), U9.12, U9.13
/~shift_left: U3.1 (1OE), U3.19 (2OE), U7.3, U9.5, U9.6
/~shift_right: U2.1 (1OE), U2.19 (2OE), U7.4, U9.8, U9.9
/~shifter_out: U4.14 (~Y1), U7.2, U7.6
GND: C1.2, C2.2, C3.2, C4.2, C5.2, C6.2, DATA_BUS1.15, DATA_BUS1.16, H1.1, H2.1, H3.1, H4.1, R2.2, R3.2, R4.2, R5.2, R6.2, U1.10 (GND), U2.10 (GND), U3.10 (GND), U4.3 (A2), U4.5 (~E1), U4.8 (GND), U5.7 (VSS), U6.7 (VSS), U7.7 (VSS), U8.7 (GND), U8.11 (C), U8.12 (D), U9.7 (VSS)
unnamed: U5.4, U5.8
unnamed: U5.5, U6.4
unnamed: U5.6, U6.10
unnamed: U5.9, U6.11
unnamed: U5.12, U9.11
unnamed: U6.3, U7.1
unnamed: U6.5, U9.3
unnamed: U6.8, U9.4
unnamed: U6.12, U9.10
VCC: C1.1, C2.1, C3.1, C4.1, C5.1, C6.1, DATA_BUS1.13, DATA_BUS1.14, R1.2, U1.1 (~Mr), U1.20 (VCC), U2.20 (VCC), U3.20 (VCC), U4.6 (E2), U4.16 (VCC), U5.14 (VDD), U6.14 (VDD), U7.8, U7.9, U7.12, U7.13, U7.14 (VDD), U8.1 (~R), U8.4 (~S), U8.10 (~S), U8.13 (~R), U8.14 (VCC), U9.14 (VDD)

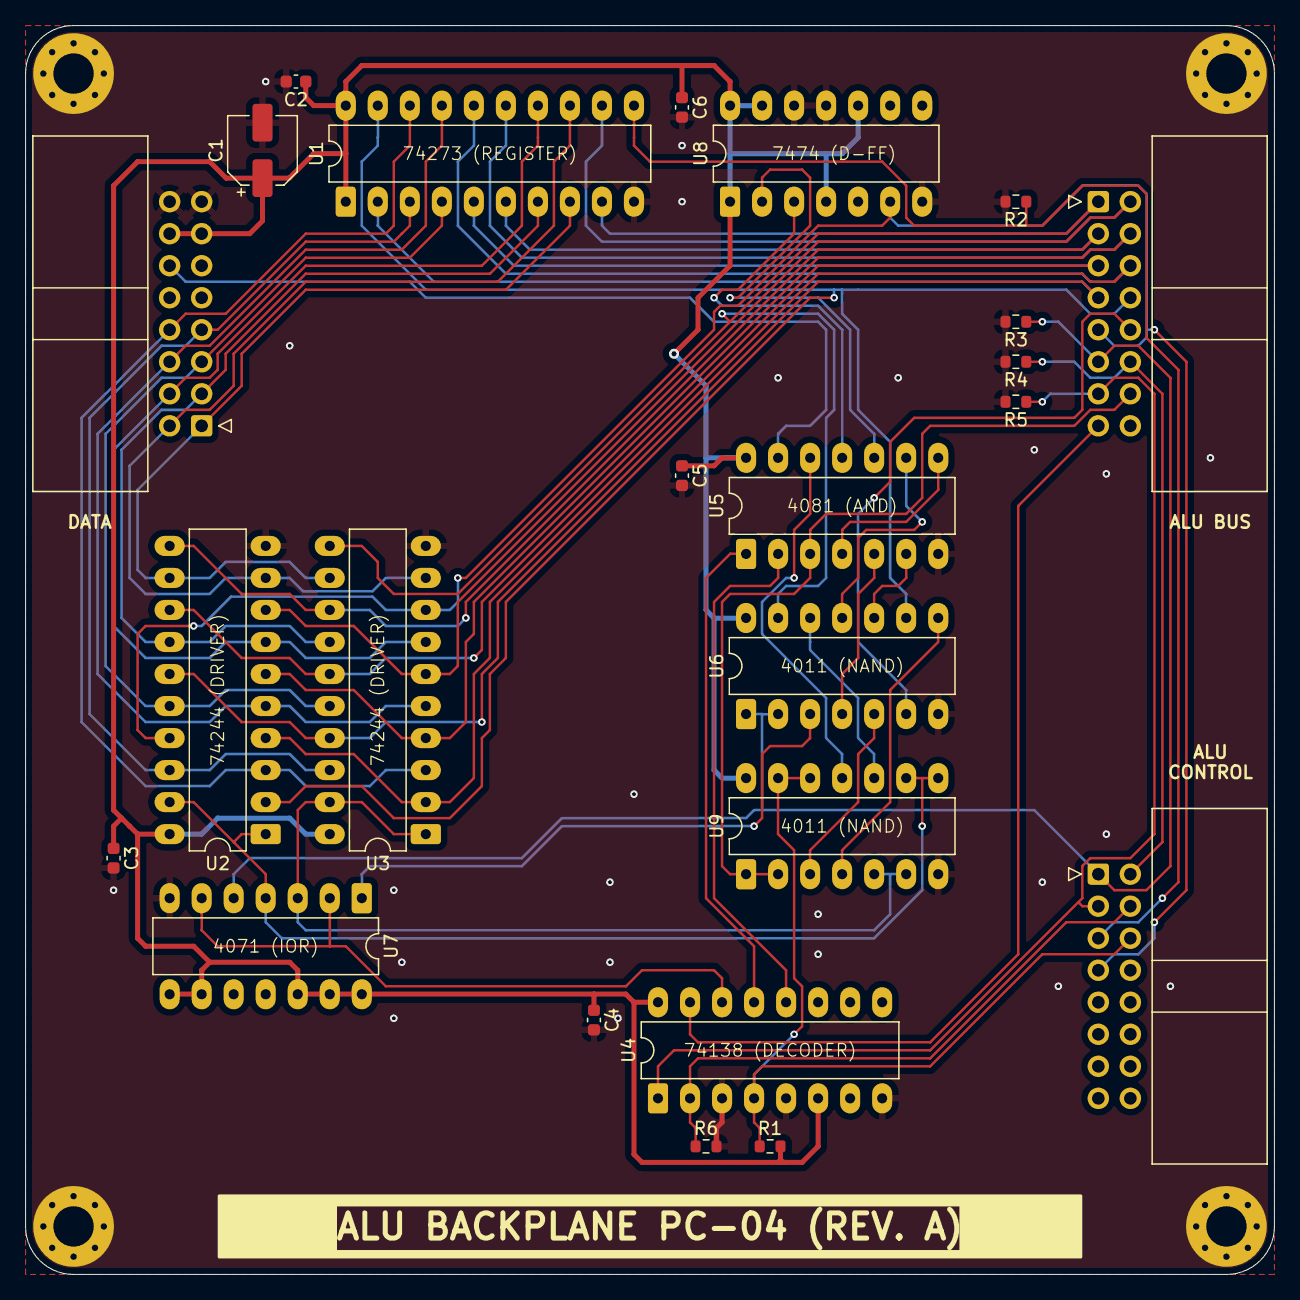
[picture p32: board pc-04_alu_backplane.kicad_pcb from above]

Board: 2 copper layers, 99.1 x 99.1 mm, 28 parts (0 on the bottom side), 45 nets.
