ksmonkey123/8bit_computer/circuits/pc-xx_memory_stack_template/memory_stack_template.kicad_pcb

## KiCad design circuits/pc-xx_memory_stack_template/memory_stack_template.kicad_pcb (2025-02-20)

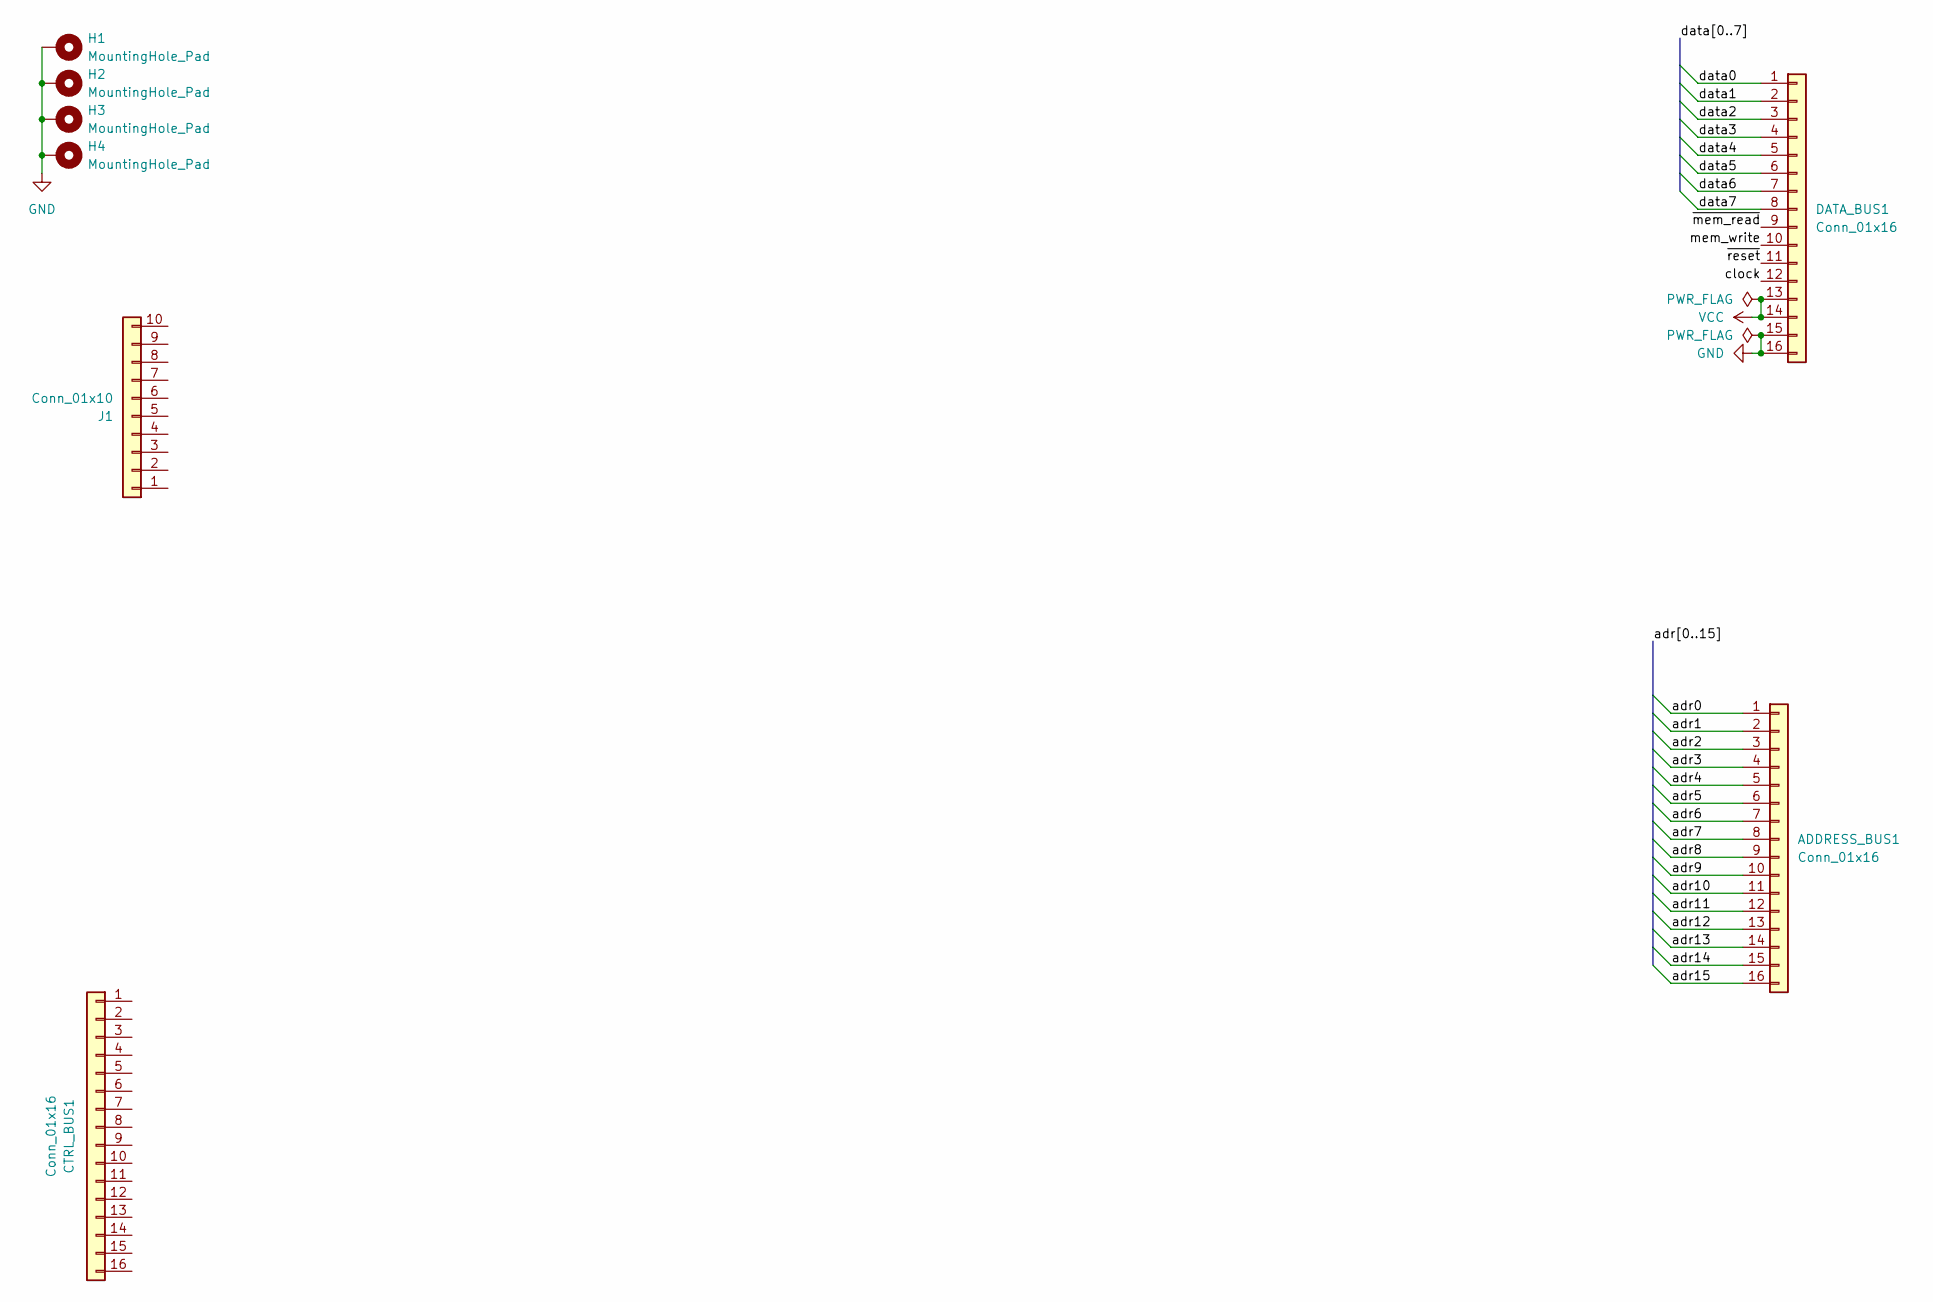
[picture p33: schematic memory_stack_template.kicad_sch, PC-01 Dual Register Unit]

Parts:
ADDRESS_BUS1: Conn_01x16; IDC-Header_2x08_P2.54mm_Horizontal
CTRL_BUS1: Conn_01x16; IDC-Header_2x08_P2.54mm_Horizontal
DATA_BUS1: Conn_01x16; IDC-Header_2x08_P2.54mm_Horizontal
H1, H2, H3, H4: MountingHole_Pad; MountingHole_3.2mm_M3_Pad_Via
J1: Conn_01x10; IDC-Header_2x05_P2.54mm_Horizontal

Connections:
/adr0: ADDRESS_BUS1.1
/adr1: ADDRESS_BUS1.2
/adr2: ADDRESS_BUS1.3
/adr3: ADDRESS_BUS1.4
/adr4: ADDRESS_BUS1.5
/adr5: ADDRESS_BUS1.6
/adr6: ADDRESS_BUS1.7
/adr7: ADDRESS_BUS1.8
/adr8: ADDRESS_BUS1.9
/adr9: ADDRESS_BUS1.10
/adr10: ADDRESS_BUS1.11
/adr11: ADDRESS_BUS1.12
/adr12: ADDRESS_BUS1.13
/adr13: ADDRESS_BUS1.14
/adr14: ADDRESS_BUS1.15
/adr15: ADDRESS_BUS1.16
/clock: DATA_BUS1.12
/data0: DATA_BUS1.1
/data1: DATA_BUS1.2
/data2: DATA_BUS1.3
/data3: DATA_BUS1.4
/data4: DATA_BUS1.5
/data5: DATA_BUS1.6
/data6: DATA_BUS1.7
/data7: DATA_BUS1.8
/mem_write: DATA_BUS1.10
/~mem_read: DATA_BUS1.9
/~reset: DATA_BUS1.11
GND: DATA_BUS1.15, DATA_BUS1.16, H1.1, H2.1, H3.1, H4.1
VCC: DATA_BUS1.13, DATA_BUS1.14

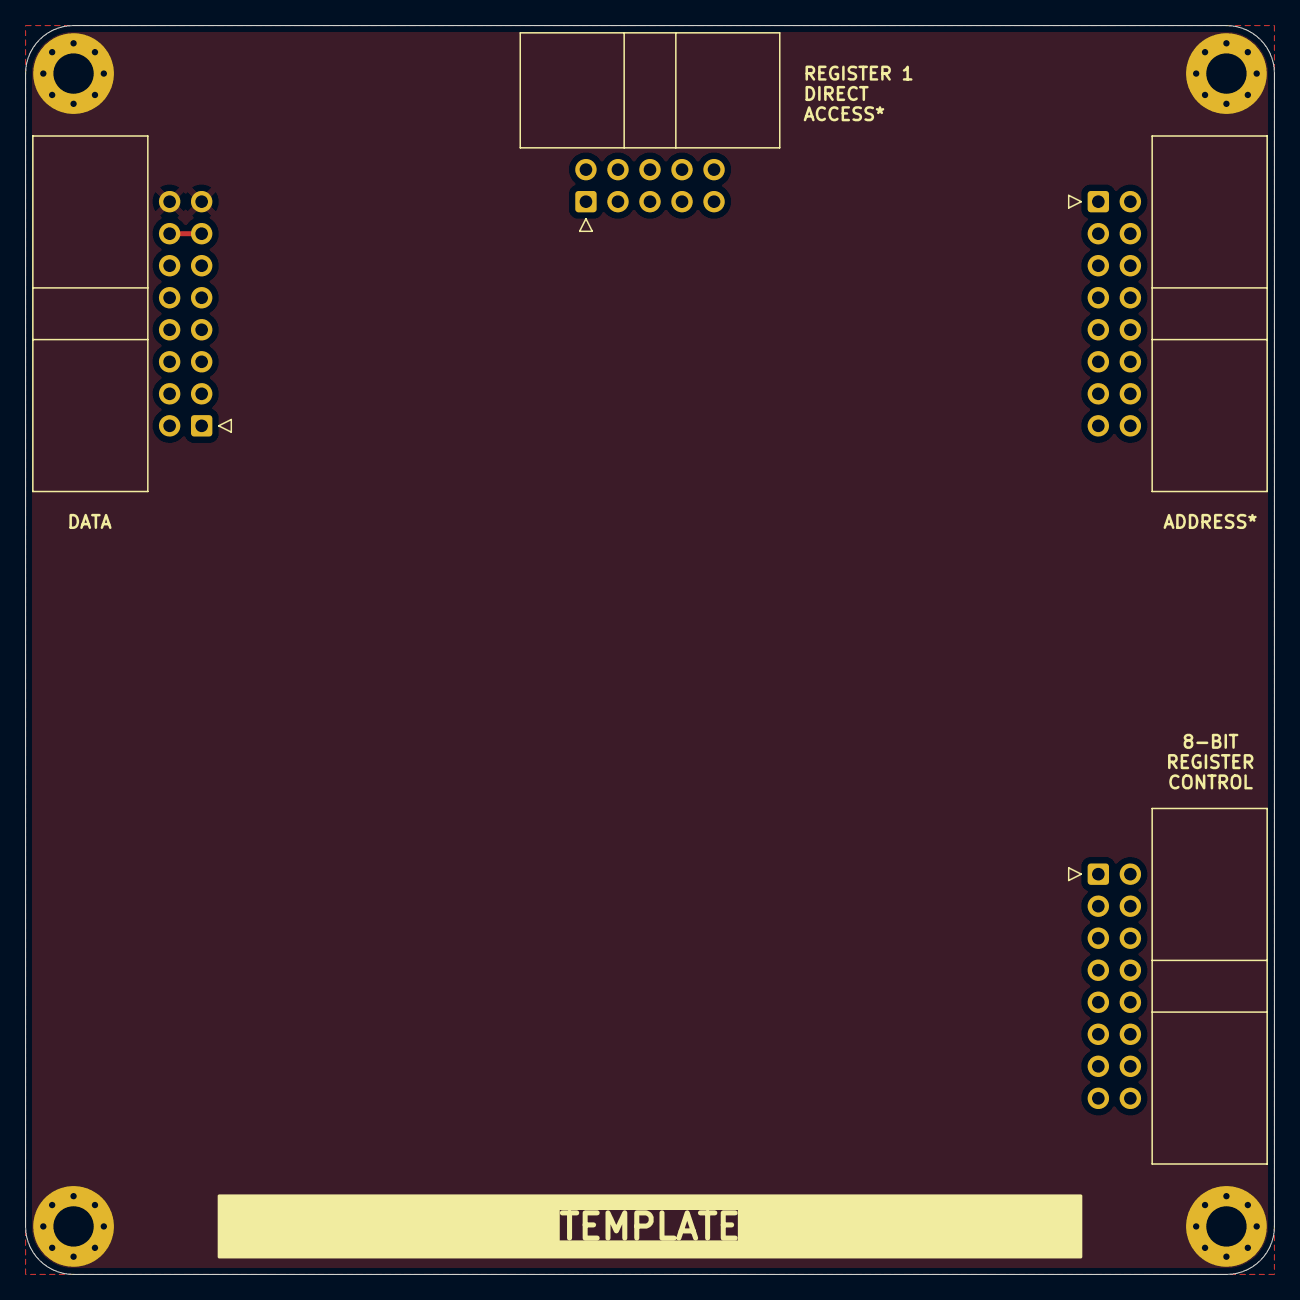
[picture p34: board memory_stack_template.kicad_pcb from above]

Board: 2 copper layers, 99.1 x 99.1 mm, 8 parts (0 on the bottom side), 2 nets.
