ksmonkey123/8bit_computer/microcode/src/main/kotlin/ch/awae/custom8bit/microcode/InstructionSet.kt

package ch.awae.custom8bit.microcode

import ch.awae.custom8bit.microcode.AddressSource.*
import ch.awae.custom8bit.microcode.AddressTarget.*
import ch.awae.custom8bit.microcode.AluOperation.*
import ch.awae.custom8bit.microcode.DataSource.*
import ch.awae.custom8bit.microcode.DataTarget.*
import ch.awae.custom8bit.microcode.SequencerCommand.*

val INSTRUCTION_SET: Set<Operation> = setOf(
    Operation(
        0x00, "ADC B",
        MicroOp(READ_REG_B, WRITE_ALU_INPUT, action = WRITE_PC),
        MicroOp(READ_ALU, WRITE_REG_A, action = ADDITION),
    ),
    Operation(
        0x01, "ADC C",
        MicroOp(READ_REG_C, WRITE_ALU_INPUT, action = WRITE_PC),
        MicroOp(READ_ALU, WRITE_REG_A, action = ADDITION),
    ),
    Operation(
        0x02, "ADC D",
        MicroOp(READ_REG_D, WRITE_ALU_INPUT, action = WRITE_PC),
        MicroOp(READ_ALU, WRITE_REG_A, action = ADDITION),
    ),
    Operation(
        0x03, "ADC i8",
        // direct load from memory to ALU
        MicroOp(READ_MEMORY, WRITE_ALU_INPUT, ADR_INCREMENTER_INCREMENT),
        // copy L1 to L2 to avoid unwanted write to ALU
        MicroOp(READ_LITERAL_1, WRITE_LITERAL_2, ADR_INCREMENTER_INCREMENT, WRITE_PC),
        MicroOp(READ_ALU, WRITE_REG_A, action = ADDITION),
    ),
    Operation(
        0x04, "ADC (i16)",
        MicroOp.FETCH_L1,
        MicroOp.FETCH_L2,
        MicroOp.WRITE_PC,
        MicroOp(READ_MEMORY, WRITE_ALU_INPUT, ADR_LITERAL),
        MicroOp(READ_ALU, WRITE_REG_A, action = ADDITION),
    ),
    Operation(
        0x05, "ADC (CD + i8)",
        MicroOp.FETCH_L1,
        MicroOp.WRITE_PC,
        MicroOp(addressSource = ADR_REG_CD),
        MicroOp(READ_MEMORY, WRITE_ALU_INPUT, ADR_INCREMENTER_OFFSET_POSITIVE),
        MicroOp(READ_ALU, WRITE_REG_A, action = ADDITION),
    ),
    Operation(
        0x06, "ADC (SP + i8)",
        MicroOp.FETCH_L1,
        MicroOp.WRITE_PC,
        MicroOp(addressSource = ADR_STACK_POINTER),
        MicroOp(READ_MEMORY, WRITE_ALU_INPUT, ADR_INCREMENTER_OFFSET_POSITIVE),
        MicroOp(READ_ALU, WRITE_REG_A, action = ADDITION),
    ),
    Operation(
        0x08, "SBC B",
        MicroOp(READ_REG_B, WRITE_ALU_INPUT, action = WRITE_PC),
        MicroOp(READ_ALU, WRITE_REG_A, action = SUBTRACTION),
    ),
    Operation(
        0x09, "SBC C",
        MicroOp(READ_REG_C, WRITE_ALU_INPUT, action = WRITE_PC),
        MicroOp(READ_ALU, WRITE_REG_A, action = SUBTRACTION),
    ),
    Operation(
        0x0a, "SBC D",
        MicroOp(READ_REG_D, WRITE_ALU_INPUT, action = WRITE_PC),
        MicroOp(READ_ALU, WRITE_REG_A, action = SUBTRACTION),
    ),
    Operation(
        0x0b, "SBC i8",
        // direct load from memory to ALU
        MicroOp(READ_MEMORY, WRITE_ALU_INPUT, ADR_INCREMENTER_INCREMENT),
        // copy L1 to L2 to avoid unwanted write to ALU
        MicroOp(READ_LITERAL_1, WRITE_LITERAL_2, ADR_INCREMENTER_INCREMENT, WRITE_PC),
        MicroOp(READ_ALU, WRITE_REG_A, action = SUBTRACTION),
    ),
    Operation(
        0x0c, "SBC (i16)",
        MicroOp.FETCH_L1,
        MicroOp.FETCH_L2,
        MicroOp.WRITE_PC,
        MicroOp(READ_MEMORY, WRITE_ALU_INPUT, ADR_LITERAL),
        MicroOp(READ_ALU, WRITE_REG_A, action = SUBTRACTION),
    ),
    Operation(
        0x0d, "SBC (CD + i8)",
        MicroOp.FETCH_L1,
        MicroOp.WRITE_PC,
        MicroOp(addressSource = ADR_REG_CD),
        MicroOp(READ_MEMORY, WRITE_ALU_INPUT, ADR_INCREMENTER_OFFSET_POSITIVE),
        MicroOp(READ_ALU, WRITE_REG_A, action = SUBTRACTION),
    ),
    Operation(
        0x0e, "SBC (SP + i8)",
        MicroOp.FETCH_L1,
        MicroOp.WRITE_PC,
        MicroOp(addressSource = ADR_STACK_POINTER),
        MicroOp(READ_MEMORY, WRITE_ALU_INPUT, ADR_INCREMENTER_OFFSET_POSITIVE),
        MicroOp(READ_ALU, WRITE_REG_A, action = SUBTRACTION),
    ),
    Operation(
        0x10, "AND B",
        MicroOp(READ_REG_B, WRITE_ALU_INPUT, action = WRITE_PC),
        MicroOp(READ_ALU, WRITE_REG_A, action = AND),
    ),
    Operation(
        0x11, "AND C",
        MicroOp(READ_REG_C, WRITE_ALU_INPUT, action = WRITE_PC),
        MicroOp(READ_ALU, WRITE_REG_A, action = AND),
    ),
    Operation(
        0x12, "AND D",
        MicroOp(READ_REG_D, WRITE_ALU_INPUT, action = WRITE_PC),
        MicroOp(READ_ALU, WRITE_REG_A, action = AND),
    ),
    Operation(
        0x13, "AND i8",
        // direct load from memory to ALU
        MicroOp(READ_MEMORY, WRITE_ALU_INPUT, ADR_INCREMENTER_INCREMENT),
        // copy L1 to L2 to avoid unwanted write to ALU
        MicroOp(READ_LITERAL_1, WRITE_LITERAL_2, ADR_INCREMENTER_INCREMENT, WRITE_PC),
        MicroOp(READ_ALU, WRITE_REG_A, action = AND),
    ),
    Operation(
        0x14, "AND (i16)",
        MicroOp.FETCH_L1,
        MicroOp.FETCH_L2,
        MicroOp.WRITE_PC,
        MicroOp(READ_MEMORY, WRITE_ALU_INPUT, ADR_LITERAL),
        MicroOp(READ_ALU, WRITE_REG_A, action = AND),
    ),
    Operation(
        0x15, "AND (CD + i8)",
        MicroOp.FETCH_L1,
        MicroOp.WRITE_PC,
        MicroOp(addressSource = ADR_REG_CD),
        MicroOp(READ_MEMORY, WRITE_ALU_INPUT, ADR_INCREMENTER_OFFSET_POSITIVE),
        MicroOp(READ_ALU, WRITE_REG_A, action = AND),
    ),
    Operation(
        0x16, "AND (SP + i8)",
        MicroOp.FETCH_L1,
        MicroOp.WRITE_PC,
        MicroOp(addressSource = ADR_STACK_POINTER),
        MicroOp(READ_MEMORY, WRITE_ALU_INPUT, ADR_INCREMENTER_OFFSET_POSITIVE),
        MicroOp(READ_ALU, WRITE_REG_A, action = AND),
    ),
    Operation(
        0x18,
        "IOR B",
        MicroOp(READ_REG_B, WRITE_ALU_INPUT, action = WRITE_PC),
        MicroOp(READ_ALU, WRITE_REG_A, action = IOR),
    ),
    Operation(
        0x19, "IOR C",
        MicroOp(READ_REG_C, WRITE_ALU_INPUT, action = WRITE_PC),
        MicroOp(READ_ALU, WRITE_REG_A, action = IOR),
    ),
    Operation(
        0x1a, "IOR D",
        MicroOp(READ_REG_D, WRITE_ALU_INPUT, action = WRITE_PC),
        MicroOp(READ_ALU, WRITE_REG_A, action = IOR),
    ),
    Operation(
        0x1b, "IOR i8",
        // direct load from memory to ALU
        MicroOp(READ_MEMORY, WRITE_ALU_INPUT, ADR_INCREMENTER_INCREMENT),
        // copy L1 to L2 to avoid unwanted write to ALU
        MicroOp(READ_LITERAL_1, WRITE_LITERAL_2, ADR_INCREMENTER_INCREMENT, WRITE_PC),
        MicroOp(READ_ALU, WRITE_REG_A, action = IOR),
    ),
    Operation(
        0x1c, "IOR (i16)",
        MicroOp.FETCH_L1,
        MicroOp.FETCH_L2,
        MicroOp.WRITE_PC,
        MicroOp(READ_MEMORY, WRITE_ALU_INPUT, ADR_LITERAL),
        MicroOp(READ_ALU, WRITE_REG_A, action = IOR),
    ),
    Operation(
        0x1d, "IOR (CD + i8)",
        MicroOp.FETCH_L1,
        MicroOp.WRITE_PC,
        MicroOp(addressSource = ADR_REG_CD),
        MicroOp(READ_MEMORY, WRITE_ALU_INPUT, ADR_INCREMENTER_OFFSET_POSITIVE),
        MicroOp(READ_ALU, WRITE_REG_A, action = IOR),
    ),
    Operation(
        0x1e, "IOR (SP + i8)",
        MicroOp.FETCH_L1,
        MicroOp.WRITE_PC,
        MicroOp(addressSource = ADR_STACK_POINTER),
        MicroOp(READ_MEMORY, WRITE_ALU_INPUT, ADR_INCREMENTER_OFFSET_POSITIVE),
        MicroOp(READ_ALU, WRITE_REG_A, action = IOR),
    ),
    Operation(
        0x20, "XOR B",
        MicroOp(READ_REG_B, WRITE_ALU_INPUT, action = WRITE_PC),
        MicroOp(READ_ALU, WRITE_REG_A, action = XOR),
    ),
    Operation(
        0x21, "XOR C",
        MicroOp(READ_REG_C, WRITE_ALU_INPUT, action = WRITE_PC),
        MicroOp(READ_ALU, WRITE_REG_A, action = XOR),
    ),
    Operation(
        0x22, "XOR D",
        MicroOp(READ_REG_D, WRITE_ALU_INPUT, action = WRITE_PC),
        MicroOp(READ_ALU, WRITE_REG_A, action = XOR),
    ),
    Operation(
        0x23, "XOR i8",
        // direct load from memory to ALU
        MicroOp(READ_MEMORY, WRITE_ALU_INPUT, ADR_INCREMENTER_INCREMENT),
        // copy L1 to L2 to avoid unwanted write to ALU
        MicroOp(READ_LITERAL_1, WRITE_LITERAL_2, ADR_INCREMENTER_INCREMENT, WRITE_PC),
        MicroOp(READ_ALU, WRITE_REG_A, action = XOR),
    ),
    Operation(
        0x24, "XOR (i16)",
        MicroOp.FETCH_L1,
        MicroOp.FETCH_L2,
        MicroOp.WRITE_PC,
        MicroOp(READ_MEMORY, WRITE_ALU_INPUT, ADR_LITERAL),
        MicroOp(READ_ALU, WRITE_REG_A, action = XOR),
    ),
    Operation(
        0x25, "XOR (CD + i8)",
        MicroOp.FETCH_L1,
        MicroOp.WRITE_PC,
        MicroOp(addressSource = ADR_REG_CD),
        MicroOp(READ_MEMORY, WRITE_ALU_INPUT, ADR_INCREMENTER_OFFSET_POSITIVE),
        MicroOp(READ_ALU, WRITE_REG_A, action = XOR),
    ),
    Operation(
        0x26, "XOR (SP + i8)",
        MicroOp.FETCH_L1,
        MicroOp.WRITE_PC,
        MicroOp(addressSource = ADR_STACK_POINTER),
        MicroOp(READ_MEMORY, WRITE_ALU_INPUT, ADR_INCREMENTER_OFFSET_POSITIVE),
        MicroOp(READ_ALU, WRITE_REG_A, action = XOR),
    ),
    Operation(
        0x28, "CMP B",
        // set ALU input to 0xff
        MicroOp(dataTarget = WRITE_ALU_INPUT, action = WRITE_PC),
        // shift left to get a '1' into the carry flag.
        MicroOp(READ_ALU, action = SHIFT_LEFT),
        MicroOp(READ_REG_B, WRITE_ALU_INPUT),
        MicroOp(READ_ALU, action = SUBTRACTION),
    ),
    Operation(
        0x29, "CMP C",
        // set ALU input to 0xff
        MicroOp(dataTarget = WRITE_ALU_INPUT, action = WRITE_PC),
        // shift left to get a '1' into the carry flag.
        MicroOp(READ_ALU, action = SHIFT_LEFT),
        MicroOp(READ_REG_C, WRITE_ALU_INPUT),
        MicroOp(READ_ALU, action = SUBTRACTION),
    ),
    Operation(
        0x2a, "CMP D",
        // set ALU input to 0xff
        MicroOp(dataTarget = WRITE_ALU_INPUT, action = WRITE_PC),
        // shift left to get a '1' into the carry flag.
        MicroOp(READ_ALU, action = SHIFT_LEFT),
        MicroOp(READ_REG_D, WRITE_ALU_INPUT),
        MicroOp(READ_ALU, action = SUBTRACTION),
    ),
    Operation(
        0x2b, "CMP i8",
        MicroOp.FETCH_L1,
        // set ALU input to 0xff
        MicroOp(dataTarget = WRITE_ALU_INPUT, action = WRITE_PC),
        // shift left to get a '1' into the carry flag.
        MicroOp(READ_ALU, action = SHIFT_LEFT),
        MicroOp(READ_LITERAL_1, WRITE_ALU_INPUT),
        MicroOp(READ_ALU, action = SUBTRACTION),
    ),
    Operation(
        0x2c, "CMP (i16)",
        MicroOp.FETCH_L1,
        MicroOp.FETCH_L2,
        // set ALU input to 0xff
        MicroOp(dataTarget = WRITE_ALU_INPUT, action = WRITE_PC),
        // shift left to get a '1' into the carry flag.
        MicroOp(READ_ALU, action = SHIFT_LEFT),
        MicroOp(READ_MEMORY, WRITE_ALU_INPUT, ADR_LITERAL),
        MicroOp(READ_ALU, action = SUBTRACTION),
    ),
    Operation(
        0x2d, "CMP (CD + i8)",
        MicroOp.FETCH_L1,
        // set ALU input to 0xff
        MicroOp(dataTarget = WRITE_ALU_INPUT, action = WRITE_PC),
        // shift left to get a '1' into the carry flag. also move CD into incrementer
        MicroOp(READ_ALU, addressSource = ADR_REG_CD, action = SHIFT_LEFT),
        MicroOp(READ_MEMORY, WRITE_ALU_INPUT, ADR_INCREMENTER_OFFSET_POSITIVE),
        MicroOp(READ_ALU, action = SUBTRACTION),
    ),
    Operation(
        0x2e, "CMP (SP + i8)",
        MicroOp.FETCH_L1,
        // set ALU input to 0xff
        MicroOp(dataTarget = WRITE_ALU_INPUT, action = WRITE_PC),
        // shift left to get a '1' into the carry flag. also move SP into incrementer
        MicroOp(READ_ALU, addressSource = ADR_STACK_POINTER, action = SHIFT_LEFT),
        MicroOp(READ_MEMORY, WRITE_ALU_INPUT, ADR_INCREMENTER_OFFSET_POSITIVE),
        MicroOp(READ_ALU, action = SUBTRACTION),
    ),
    Operation(
        0x30, "DEC A",
        MicroOp(READ_REG_A, WRITE_ALU_INPUT, action = WRITE_PC),
        MicroOp(READ_ALU, WRITE_REG_A, action = DECREMENT),
    ),
    Operation(
        0x31, "DEC B",
        MicroOp(READ_REG_B, WRITE_ALU_INPUT, action = WRITE_PC),
        MicroOp(READ_ALU, WRITE_REG_B, action = DECREMENT),
    ),
    Operation(
        0x32, "DEC C",
        MicroOp(READ_REG_C, WRITE_ALU_INPUT, action = WRITE_PC),
        MicroOp(READ_ALU, WRITE_REG_C, action = DECREMENT),
    ),
    Operation(
        0x33, "DEC D",
        MicroOp(READ_REG_D, WRITE_ALU_INPUT, action = WRITE_PC),
        MicroOp(READ_ALU, WRITE_REG_D, action = DECREMENT),
    ),
    Operation(
        0x34, "INC A",
        MicroOp(READ_REG_A, WRITE_ALU_INPUT, action = WRITE_PC),
        MicroOp(READ_ALU, WRITE_REG_A, action = INCREMENT),
    ),
    Operation(
        0x35, "INC B",
        MicroOp(READ_REG_B, WRITE_ALU_INPUT, action = WRITE_PC),
        MicroOp(READ_ALU, WRITE_REG_B, action = INCREMENT),
    ),
    Operation(
        0x36, "INC C",
        MicroOp(READ_REG_C, WRITE_ALU_INPUT, action = WRITE_PC),
        MicroOp(READ_ALU, WRITE_REG_C, action = INCREMENT),
    ),
    Operation(
        0x37, "INC D",
        MicroOp(READ_REG_D, WRITE_ALU_INPUT, action = WRITE_PC),
        MicroOp(READ_ALU, WRITE_REG_D, action = INCREMENT),
    ),
    Operation(
        0x38, "NEG A",
        MicroOp(READ_REG_A, WRITE_ALU_INPUT, action = WRITE_PC),
        MicroOp(READ_ALU, WRITE_REG_A, action = COMPLEMENT),
    ),
    Operation(
        0x39, "NEG B",
        MicroOp(READ_REG_B, WRITE_ALU_INPUT, action = WRITE_PC),
        MicroOp(READ_ALU, WRITE_REG_B, action = COMPLEMENT),
    ),
    Operation(
        0x3a, "NEG C",
        MicroOp(READ_REG_C, WRITE_ALU_INPUT, action = WRITE_PC),
        MicroOp(READ_ALU, WRITE_REG_C, action = COMPLEMENT),
    ),
    Operation(
        0x3b, "NEG D",
        MicroOp(READ_REG_D, WRITE_ALU_INPUT, action = WRITE_PC),
        MicroOp(READ_ALU, WRITE_REG_D, action = COMPLEMENT),
    ),
    Operation(
        0x3c, "NOT A",
        MicroOp(READ_REG_A, WRITE_ALU_INPUT, action = WRITE_PC),
        MicroOp(READ_ALU, WRITE_REG_A, action = INVERT),
    ),
    Operation(
        0x3d, "NOT B",
        MicroOp(READ_REG_B, WRITE_ALU_INPUT, action = WRITE_PC),
        MicroOp(READ_ALU, WRITE_REG_B, action = INVERT),
    ),
    Operation(
        0x3e, "NOT C",
        MicroOp(READ_REG_C, WRITE_ALU_INPUT, action = WRITE_PC),
        MicroOp(READ_ALU, WRITE_REG_C, action = INVERT),
    ),
    Operation(
        0x3f, "NOT D",
        MicroOp(READ_REG_D, WRITE_ALU_INPUT, action = WRITE_PC),
        MicroOp(READ_ALU, WRITE_REG_D, action = INVERT),
    ),
    // roll left through carry
    Operation(
        0x40, "RLC",
        MicroOp(READ_REG_A, WRITE_ALU_INPUT, action = WRITE_PC),
        MicroOp(READ_ALU, WRITE_REG_A, action = SHIFT_LEFT),
    ),
    // roll left without carry
    Operation(
        0x41, "RLD",
        MicroOp(READ_REG_A, WRITE_ALU_INPUT, action = WRITE_PC),
        // shift once to get top bit into carry (write to A necessary to not rewrite alu input)
        MicroOp(READ_ALU, WRITE_REG_A, action = SHIFT_LEFT),
        // do real shift with carry to get it into the bottom bit
        MicroOp(READ_ALU, WRITE_REG_A, action = SHIFT_LEFT),
    ),
    // roll right through carry
    Operation(
        0x42, "RRC",
        MicroOp(READ_REG_A, WRITE_ALU_INPUT, action = WRITE_PC),
        MicroOp(READ_ALU, WRITE_REG_A, action = SHIFT_RIGHT),
    ),
    // roll right without carry
    Operation(
        0x43, "RRD",
        MicroOp(READ_REG_A, WRITE_ALU_INPUT, action = WRITE_PC),
        // shift once to get bottom bit into carry (write to A necessary to not rewrite alu input)
        MicroOp(READ_ALU, WRITE_REG_A, action = SHIFT_RIGHT),
        MicroOp(READ_ALU, WRITE_REG_A, action = SHIFT_RIGHT),
    ),
    // roll right arithmetic. (retain top bit)
    Operation(
        0x44, "RRA",
        MicroOp.WRITE_PC,
        // execute ALU logic command to clear carry flag.
        MicroOp(READ_ALU, WRITE_ALU_INPUT, action = AND),
        MicroOp(READ_REG_A, WRITE_ALU_INPUT),
        // shift once to get top bit into carry (write to A necessary to not rewrite alu input)
        MicroOp(READ_ALU, WRITE_REG_A, action = SHIFT_LEFT),
        // real shift right with replicated top bit
        MicroOp(READ_ALU, WRITE_REG_A, action = SHIFT_RIGHT),
    ),
    Operation(
        0x48, "SWAP B",
        // move B into ALU
        MicroOp(READ_REG_B, WRITE_ALU_INPUT, action = WRITE_PC),
        // copy A to B
        MicroOp(READ_REG_A, WRITE_REG_B),
        // write !B to ALU
        MicroOp(READ_ALU, WRITE_ALU_INPUT, action = INVERT),
        // write !!B (=B) to A
        MicroOp(READ_ALU, WRITE_REG_A, action = INVERT),
    ),
    Operation(
        0x49, "SWP C",
        // move C into ALU
        MicroOp(READ_REG_C, WRITE_ALU_INPUT, action = WRITE_PC),
        // copy A to C
        MicroOp(READ_REG_A, WRITE_REG_C),
        // write !C to ALU
        MicroOp(READ_ALU, WRITE_ALU_INPUT, action = INVERT),
        // write !!C (=C) to A
        MicroOp(READ_ALU, WRITE_REG_A, action = INVERT),
    ),
    Operation(
        0x4a, "SWP D",
        // move D into ALU
        MicroOp(READ_REG_D, WRITE_ALU_INPUT, action = WRITE_PC),
        // copy A to D
        MicroOp(READ_REG_A, WRITE_REG_D),
        // write !D to ALU
        MicroOp(READ_ALU, WRITE_ALU_INPUT, action = INVERT),
        // write !!D (=D) to A
        MicroOp(READ_ALU, WRITE_REG_A, action = INVERT),
    ),
    Operation(
        0x4b, "SWP (i16)",
        MicroOp.FETCH_L1,
        MicroOp.FETCH_L2,
        MicroOp.WRITE_PC,
        // move MEM[L] into ALU
        MicroOp(READ_MEMORY, WRITE_ALU_INPUT, ADR_LITERAL),
        // copy A to MEM[L]
        MicroOp(READ_REG_A, WRITE_MEMORY, ADR_LITERAL),
        // write !D to ALU
        MicroOp(READ_ALU, WRITE_ALU_INPUT, action = INVERT),
        // write !!D (=D) to A
        MicroOp(READ_ALU, WRITE_REG_A, action = INVERT),
    ),
    Operation(
        0x4c, "SWP (CD + i8)",
        MicroOp.FETCH_L1,
        MicroOp.WRITE_PC,
        // move A to ALU
        MicroOp(READ_REG_A, WRITE_ALU_INPUT, ADR_REG_CD),
        // move M to A
        MicroOp(READ_MEMORY, WRITE_REG_A, ADR_INCREMENTER_OFFSET_POSITIVE),
        // move !A to ALU
        MicroOp(READ_ALU, WRITE_ALU_INPUT, ADR_REG_CD, action = INVERT),
        // move !!A (=A) to M
        MicroOp(READ_ALU, WRITE_MEMORY, ADR_INCREMENTER_OFFSET_POSITIVE, action = INVERT)
    ),
    Operation(
        0x4d, "SWP (SP + i8)",
        MicroOp.FETCH_L1,
        MicroOp.WRITE_PC,
        // move A to ALU
        MicroOp(READ_REG_A, WRITE_ALU_INPUT, ADR_STACK_POINTER),
        // move M to A
        MicroOp(READ_MEMORY, WRITE_REG_A, ADR_INCREMENTER_OFFSET_POSITIVE),
        // move !A to ALU
        MicroOp(READ_ALU, WRITE_ALU_INPUT, ADR_STACK_POINTER, action = INVERT),
        // move !!A (=A) to M
        MicroOp(READ_ALU, WRITE_MEMORY, ADR_INCREMENTER_OFFSET_POSITIVE, action = INVERT)
    ),
    Operation(
        0x50, "MOV A (SP + i8)",
        MicroOp.FETCH_L1,
        MicroOp.WRITE_PC,
        MicroOp(addressSource = ADR_STACK_POINTER),
        MicroOp(READ_MEMORY, WRITE_REG_A, ADR_INCREMENTER_OFFSET_POSITIVE)
    ),
    Operation(
        0x51, "MOV B (SP + i8)",
        MicroOp.FETCH_L1,
        MicroOp.WRITE_PC,
        MicroOp(addressSource = ADR_STACK_POINTER),
        MicroOp(READ_MEMORY, WRITE_REG_B, ADR_INCREMENTER_OFFSET_POSITIVE)
    ),
    Operation(
        0x52, "MOV C (SP + i8)",
        MicroOp.FETCH_L1,
        MicroOp.WRITE_PC,
        MicroOp(addressSource = ADR_STACK_POINTER),
        MicroOp(READ_MEMORY, WRITE_REG_C, ADR_INCREMENTER_OFFSET_POSITIVE)
    ),
    Operation(
        0x53, "MOV D (SP + i8)",
        MicroOp.FETCH_L1,
        MicroOp.WRITE_PC,
        MicroOp(addressSource = ADR_STACK_POINTER),
        MicroOp(READ_MEMORY, WRITE_REG_D, ADR_INCREMENTER_OFFSET_POSITIVE)
    ),
    Operation(
        0x54, "MOV (SP + i8) A",
        MicroOp.FETCH_L1,
        MicroOp.WRITE_PC,
        MicroOp(addressSource = ADR_STACK_POINTER),
        MicroOp(READ_REG_A, WRITE_MEMORY, ADR_INCREMENTER_OFFSET_POSITIVE)
    ),
    Operation(
        0x55, "MOV (SP + i8) B",
        MicroOp.FETCH_L1,
        MicroOp.WRITE_PC,
        MicroOp(addressSource = ADR_STACK_POINTER),
        MicroOp(READ_REG_B, WRITE_MEMORY, ADR_INCREMENTER_OFFSET_POSITIVE)
    ),
    Operation(
        0x56, "MOV (SP + i8) C",
        MicroOp.FETCH_L1,
        MicroOp.WRITE_PC,
        MicroOp(addressSource = ADR_STACK_POINTER),
        MicroOp(READ_REG_C, WRITE_MEMORY, ADR_INCREMENTER_OFFSET_POSITIVE)
    ),
    Operation(
        0x57, "MOV (SP + i8) D",
        MicroOp.FETCH_L1,
        MicroOp.WRITE_PC,
        MicroOp(addressSource = ADR_STACK_POINTER),
        MicroOp(READ_REG_D, WRITE_MEMORY, ADR_INCREMENTER_OFFSET_POSITIVE)
    ),
    Operation(0x60, "MOV A A", MicroOp(READ_REG_A, WRITE_REG_A, action = WRITE_PC)),
    Operation(0x61, "MOV A B", MicroOp(READ_REG_B, WRITE_REG_A, action = WRITE_PC)),
    Operation(0x62, "MOV A C", MicroOp(READ_REG_C, WRITE_REG_A, action = WRITE_PC)),
    Operation(0x63, "MOV A D", MicroOp(READ_REG_D, WRITE_REG_A, action = WRITE_PC)),
    Operation(0x64, "MOV B A", MicroOp(READ_REG_A, WRITE_REG_B, action = WRITE_PC)),
    Operation(0x65, "MOV B B", MicroOp(READ_REG_B, WRITE_REG_B, action = WRITE_PC)),
    Operation(0x66, "MOV B C", MicroOp(READ_REG_C, WRITE_REG_B, action = WRITE_PC)),
    Operation(0x67, "MOV B D", MicroOp(READ_REG_D, WRITE_REG_B, action = WRITE_PC)),
    Operation(0x68, "MOV C A", MicroOp(READ_REG_A, WRITE_REG_C, action = WRITE_PC)),
    Operation(0x69, "MOV C B", MicroOp(READ_REG_B, WRITE_REG_C, action = WRITE_PC)),
    Operation(0x6a, "MOV C C", MicroOp(READ_REG_C, WRITE_REG_C, action = WRITE_PC)),
    Operation(0x6b, "MOV C D", MicroOp(READ_REG_D, WRITE_REG_C, action = WRITE_PC)),
    Operation(0x6c, "MOV D A", MicroOp(READ_REG_A, WRITE_REG_D, action = WRITE_PC)),
    Operation(0x6d, "MOV D B", MicroOp(READ_REG_B, WRITE_REG_D, action = WRITE_PC)),
    Operation(0x6e, "MOV D C", MicroOp(READ_REG_C, WRITE_REG_D, action = WRITE_PC)),
    Operation(0x6f, "MOV D D", MicroOp(READ_REG_D, WRITE_REG_D, action = WRITE_PC)),
    Operation(
        0x70,
        "MOV A (i16)",
        MicroOp.FETCH_L1,
        MicroOp.FETCH_L2,
        MicroOp.WRITE_PC,
        MicroOp(READ_MEMORY, WRITE_REG_A, ADR_LITERAL)
    ),
    Operation(
        0x71,
        "MOV B (i16)",
        MicroOp.FETCH_L1,
        MicroOp.FETCH_L2,
        MicroOp.WRITE_PC,
        MicroOp(READ_MEMORY, WRITE_REG_B, ADR_LITERAL)
    ),
    Operation(
        0x72,
        "MOV C (i16)",
        MicroOp.FETCH_L1,
        MicroOp.FETCH_L2,
        MicroOp.WRITE_PC,
        MicroOp(READ_MEMORY, WRITE_REG_C, ADR_LITERAL)
    ),
    Operation(
        0x73,
        "MOV D (i16)",
        MicroOp.FETCH_L1,
        MicroOp.FETCH_L2,
        MicroOp.WRITE_PC,
        MicroOp(READ_MEMORY, WRITE_REG_D, ADR_LITERAL)
    ),
    Operation(
        0x74, "MOV A (CD + i8)",
        MicroOp.FETCH_L1,
        MicroOp.WRITE_PC,
        MicroOp(addressSource = ADR_REG_CD),
        MicroOp(READ_MEMORY, WRITE_REG_A, ADR_INCREMENTER_OFFSET_POSITIVE)
    ),
    Operation(
        0x75, "MOV B (CD + i8)",
        MicroOp.FETCH_L1,
        MicroOp.WRITE_PC,
        MicroOp(addressSource = ADR_REG_CD),
        MicroOp(READ_MEMORY, WRITE_REG_B, ADR_INCREMENTER_OFFSET_POSITIVE)
    ),
    Operation(
        0x76, "MOV C (CD + i8)",
        MicroOp.FETCH_L1,
        MicroOp.WRITE_PC,
        MicroOp(addressSource = ADR_REG_CD),
        MicroOp(READ_MEMORY, WRITE_REG_C, ADR_INCREMENTER_OFFSET_POSITIVE)
    ),
    Operation(
        0x77, "MOV D (CD + i8)",
        MicroOp.FETCH_L1,
        MicroOp.WRITE_PC,
        MicroOp(addressSource = ADR_REG_CD),
        MicroOp(READ_MEMORY, WRITE_REG_D, ADR_INCREMENTER_OFFSET_POSITIVE)
    ),
    Operation(
        0x78, "MOV A (SP + i8)",
        MicroOp.FETCH_L1,
        MicroOp.WRITE_PC,
        MicroOp(addressSource = ADR_STACK_POINTER),
        MicroOp(READ_MEMORY, WRITE_REG_A, ADR_INCREMENTER_OFFSET_POSITIVE)
    ),
    Operation(
        0x79, "MOV B (SP + i8)",
        MicroOp.FETCH_L1,
        MicroOp.WRITE_PC,
        MicroOp(addressSource = ADR_STACK_POINTER),
        MicroOp(READ_MEMORY, WRITE_REG_B, ADR_INCREMENTER_OFFSET_POSITIVE)
    ),
    Operation(
        0x7a, "MOV C (SP + i8)",
        MicroOp.FETCH_L1,
        MicroOp.WRITE_PC,
        MicroOp(addressSource = ADR_STACK_POINTER),
        MicroOp(READ_MEMORY, WRITE_REG_C, ADR_INCREMENTER_OFFSET_POSITIVE)
    ),
    Operation(
        0x7b, "MOV D (SP + i8)",
        MicroOp.FETCH_L1,
        MicroOp.WRITE_PC,
        MicroOp(addressSource = ADR_STACK_POINTER),
        MicroOp(READ_MEMORY, WRITE_REG_D, ADR_INCREMENTER_OFFSET_POSITIVE)
    ),
    Operation(0x7c, "MOV A i8", MicroOp(READ_MEMORY, WRITE_REG_A, ADR_INCREMENTER_INCREMENT), MicroOp.WRITE_PC),
    Operation(0x7d, "MOV B i8", MicroOp(READ_MEMORY, WRITE_REG_B, ADR_INCREMENTER_INCREMENT), MicroOp.WRITE_PC),
    Operation(0x7e, "MOV C i8", MicroOp(READ_MEMORY, WRITE_REG_C, ADR_INCREMENTER_INCREMENT), MicroOp.WRITE_PC),
    Operation(0x7f, "MOV D i8", MicroOp(READ_MEMORY, WRITE_REG_D, ADR_INCREMENTER_INCREMENT), MicroOp.WRITE_PC),
    Operation(
        0x80,
        "MOV (i16) A",
        MicroOp.FETCH_L1,
        MicroOp.FETCH_L2,
        MicroOp.WRITE_PC,
        MicroOp(READ_REG_A, WRITE_MEMORY, ADR_LITERAL)
    ),
    Operation(
        0x81,
        "MOV (i16) B",
        MicroOp.FETCH_L1,
        MicroOp.FETCH_L2,
        MicroOp.WRITE_PC,
        MicroOp(READ_REG_B, WRITE_MEMORY, ADR_LITERAL)
    ),
    Operation(
        0x82,
        "MOV (i16) C",
        MicroOp.FETCH_L1,
        MicroOp.FETCH_L2,
        MicroOp.WRITE_PC,
        MicroOp(READ_REG_C, WRITE_MEMORY, ADR_LITERAL)
    ),
    Operation(
        0x83,
        "MOV (i16) D",
        MicroOp.FETCH_L1,
        MicroOp.FETCH_L2,
        MicroOp.WRITE_PC,
        MicroOp(READ_REG_D, WRITE_MEMORY, ADR_LITERAL)
    ),
    Operation(
        0x84, "MOV (CD + i8) A",
        MicroOp.FETCH_L1,
        MicroOp.WRITE_PC,
        MicroOp(addressSource = ADR_REG_CD),
        MicroOp(READ_REG_A, WRITE_MEMORY, ADR_INCREMENTER_OFFSET_POSITIVE)
    ),
    Operation(
        0x85, "MOV (CD + i8) B",
        MicroOp.FETCH_L1,
        MicroOp.WRITE_PC,
        MicroOp(addressSource = ADR_REG_CD),
        MicroOp(READ_REG_B, WRITE_MEMORY, ADR_INCREMENTER_OFFSET_POSITIVE)
    ),
    Operation(
        0x86, "MOV (CD + i8) C",
        MicroOp.FETCH_L1,
        MicroOp.WRITE_PC,
        MicroOp(addressSource = ADR_REG_CD),
        MicroOp(READ_REG_C, WRITE_MEMORY, ADR_INCREMENTER_OFFSET_POSITIVE)
    ),
    Operation(
        0x87, "MOV (CD + i8) D",
        MicroOp.FETCH_L1,
        MicroOp.WRITE_PC,
        MicroOp(addressSource = ADR_REG_CD),
        MicroOp(READ_REG_D, WRITE_MEMORY, ADR_INCREMENTER_OFFSET_POSITIVE)
    ),
    Operation(
        0x88, "MOV (SP + i8) A",
        MicroOp.FETCH_L1,
        MicroOp.WRITE_PC,
        MicroOp(addressSource = ADR_STACK_POINTER),
        MicroOp(READ_REG_A, WRITE_MEMORY, ADR_INCREMENTER_OFFSET_POSITIVE)
    ),
    Operation(
        0x89, "MOV (SP + i8) B",
        MicroOp.FETCH_L1,
        MicroOp.WRITE_PC,
        MicroOp(addressSource = ADR_STACK_POINTER),
        MicroOp(READ_REG_B, WRITE_MEMORY, ADR_INCREMENTER_OFFSET_POSITIVE)
    ),
    Operation(
        0x8a, "MOV (SP + i8) C",
        MicroOp.FETCH_L1,
        MicroOp.WRITE_PC,
        MicroOp(addressSource = ADR_STACK_POINTER),
        MicroOp(READ_REG_C, WRITE_MEMORY, ADR_INCREMENTER_OFFSET_POSITIVE)
    ),
    Operation(
        0x8b, "MOV (SP + i8) D",
        MicroOp.FETCH_L1,
        MicroOp.WRITE_PC,
        MicroOp(addressSource = ADR_STACK_POINTER),
        MicroOp(READ_REG_D, WRITE_MEMORY, ADR_INCREMENTER_OFFSET_POSITIVE)
    ),
    Operation(
        0x8c, "MOV (i16) AB",
        MicroOp.FETCH_L1,
        MicroOp.FETCH_L2,
        MicroOp.WRITE_PC,
        MicroOp(READ_REG_A, WRITE_MEMORY, ADR_LITERAL),
        MicroOp(READ_REG_B, WRITE_MEMORY, ADR_INCREMENTER_INCREMENT),
    ),
    Operation(
        0x8d, "MOV (i16) CD",
        MicroOp.FETCH_L1,
        MicroOp.FETCH_L2,
        MicroOp.WRITE_PC,
        MicroOp(READ_REG_C, WRITE_MEMORY, ADR_LITERAL),
        MicroOp(READ_REG_D, WRITE_MEMORY, ADR_INCREMENTER_INCREMENT),
    ),
    Operation(
        0x8e, "SPA i8",
        MicroOp.FETCH_L1,
        MicroOp.WRITE_PC,
        MicroOp(addressSource = ADR_STACK_POINTER),
        MicroOp(addressSource = ADR_INCREMENTER_OFFSET_NEGATIVE, action = WRITE_STACK_POINTER),
    ),
    Operation(
        0x8f, "SPF i8",
        MicroOp.FETCH_L1,
        MicroOp.WRITE_PC,
        MicroOp(addressSource = ADR_STACK_POINTER),
        MicroOp(addressSource = ADR_INCREMENTER_OFFSET_POSITIVE, action = WRITE_STACK_POINTER),
    ),
    Operation(0x90, "MOV AB AB", MicroOp.WRITE_PC),
    Operation(
        0x91, "MOV AB CD",
        MicroOp(READ_REG_C, WRITE_REG_A, action = WRITE_PC),
        MicroOp(READ_REG_D, WRITE_REG_B),
    ),
    Operation(
        0x92, "MOV CD AB",
        MicroOp(READ_REG_A, WRITE_REG_C, action = WRITE_PC),
        MicroOp(READ_REG_B, WRITE_REG_D),
    ),
    Operation(0x93, "MOV CD CD", MicroOp.WRITE_PC),
    Operation(
        0x94, "MOV AB (i16)",
        MicroOp.FETCH_L1,
        MicroOp.FETCH_L2,
        MicroOp.WRITE_PC,
        MicroOp(READ_MEMORY, WRITE_REG_A, ADR_LITERAL),
        MicroOp(READ_MEMORY, WRITE_REG_B, ADR_INCREMENTER_INCREMENT),
    ),
    Operation(
        0x95, "MOV CD (i16)",
        MicroOp.FETCH_L1,
        MicroOp.FETCH_L2,
        MicroOp.WRITE_PC,
        MicroOp(READ_MEMORY, WRITE_REG_C, ADR_LITERAL),
        MicroOp(READ_MEMORY, WRITE_REG_D, ADR_INCREMENTER_INCREMENT),
    ),
    Operation(
        0x96, "MOV AB (CD + i8)",
        MicroOp.FETCH_L1,
        MicroOp.WRITE_PC,
        MicroOp(addressSource = ADR_REG_CD),
        MicroOp(READ_MEMORY, WRITE_REG_A, ADR_INCREMENTER_OFFSET_POSITIVE),
        MicroOp(READ_MEMORY, WRITE_REG_B, ADR_INCREMENTER_INCREMENT),
    ),
    Operation(
        0x97, "MOV CD (CD + i8)",
        MicroOp.FETCH_L1,
        MicroOp.WRITE_PC,
        MicroOp(addressSource = ADR_REG_CD),
        MicroOp(READ_MEMORY, WRITE_REG_C, ADR_INCREMENTER_OFFSET_POSITIVE),
        MicroOp(READ_MEMORY, WRITE_REG_D, ADR_INCREMENTER_INCREMENT),
    ),
    Operation(
        0x98, "MOV AB (SP + i8)",
        MicroOp.FETCH_L1,
        MicroOp.WRITE_PC,
        MicroOp(addressSource = ADR_STACK_POINTER),
        MicroOp(READ_MEMORY, WRITE_REG_A, ADR_INCREMENTER_OFFSET_POSITIVE),
        MicroOp(READ_MEMORY, WRITE_REG_B, ADR_INCREMENTER_INCREMENT),
    ),
    Operation(
        0x99, "MOV CD (SP + i8)",
        MicroOp.FETCH_L1,
        MicroOp.WRITE_PC,
        MicroOp(addressSource = ADR_STACK_POINTER),
        MicroOp(READ_MEMORY, WRITE_REG_C, ADR_INCREMENTER_OFFSET_POSITIVE),
        MicroOp(READ_MEMORY, WRITE_REG_D, ADR_INCREMENTER_INCREMENT),
    ),
    Operation(
        0x9a, "MOV AB i16",
        MicroOp(READ_MEMORY, WRITE_REG_A, ADR_INCREMENTER_INCREMENT),
        MicroOp(READ_MEMORY, WRITE_REG_B, ADR_INCREMENTER_INCREMENT),
        MicroOp.WRITE_PC,
    ),
    Operation(
        0x9b, "MOV CD i16",
        MicroOp(READ_MEMORY, WRITE_REG_C, ADR_INCREMENTER_INCREMENT),
        MicroOp(READ_MEMORY, WRITE_REG_D, ADR_INCREMENTER_INCREMENT),
        MicroOp.WRITE_PC,
    ),
    Operation(
        0x9c, "MOV (CD + i8) AB",
        MicroOp.FETCH_L1,
        MicroOp.WRITE_PC,
        MicroOp(addressSource = ADR_REG_CD),
        MicroOp(READ_REG_A, WRITE_MEMORY, ADR_INCREMENTER_OFFSET_POSITIVE),
        MicroOp(READ_REG_B, WRITE_MEMORY, ADR_INCREMENTER_INCREMENT),
    ),
    Operation(
        0x9d, "MOV (CD + i8) CD",
        MicroOp.FETCH_L1,
        MicroOp.WRITE_PC,
        MicroOp(addressSource = ADR_REG_CD),
        MicroOp(READ_REG_C, WRITE_MEMORY, ADR_INCREMENTER_OFFSET_POSITIVE),
        MicroOp(READ_REG_D, WRITE_MEMORY, ADR_INCREMENTER_INCREMENT),
    ),
    Operation(
        0x9e, "MOV (SP + i8) AB",
        MicroOp.FETCH_L1,
        MicroOp.WRITE_PC,
        MicroOp(addressSource = ADR_STACK_POINTER),
        MicroOp(READ_REG_A, WRITE_MEMORY, ADR_INCREMENTER_OFFSET_POSITIVE),
        MicroOp(READ_REG_B, WRITE_MEMORY, ADR_INCREMENTER_INCREMENT),
    ),
    Operation(
        0x9f, "MOV (SP + i8) CD",
        MicroOp.FETCH_L1,
        MicroOp.WRITE_PC,
        MicroOp(addressSource = ADR_STACK_POINTER),
        MicroOp(READ_REG_C, WRITE_MEMORY, ADR_INCREMENTER_OFFSET_POSITIVE),
        MicroOp(READ_REG_D, WRITE_MEMORY, ADR_INCREMENTER_INCREMENT),
    ),
    Operation(
        0xb0, "BCC i16",
        MicroOp.FETCH_L1,
        MicroOp.FETCH_L2,
        MicroOp(addressSource = ADR_LITERAL, action = WRITE_PC).condition(Condition.CARRY_CLEAR)
            .otherwise(MicroOp.WRITE_PC),
    ),
    Operation(
        0xb1, "BCS i16",
        MicroOp.FETCH_L1,
        MicroOp.FETCH_L2,
        MicroOp(addressSource = ADR_LITERAL, action = WRITE_PC).condition(Condition.CARRY_SET)
            .otherwise(MicroOp.WRITE_PC),
    ),
    Operation(
        0xb2, "BEZ i16",
        MicroOp.FETCH_L1,
        MicroOp.FETCH_L2,
        MicroOp(addressSource = ADR_LITERAL, action = WRITE_PC).condition(Condition.ZERO)
            .otherwise(MicroOp.WRITE_PC),
    ),
    Operation(
        0xb3, "BNZ i16",
        MicroOp.FETCH_L1,
        MicroOp.FETCH_L2,
        MicroOp(addressSource = ADR_LITERAL, action = WRITE_PC).condition(Condition.NOT_ZERO)
            .otherwise(MicroOp.WRITE_PC),
    ),
    Operation(
        0xb4, "BLZ i16",
        MicroOp.FETCH_L1,
        MicroOp.FETCH_L2,
        MicroOp(addressSource = ADR_LITERAL, action = WRITE_PC).condition(Condition.NEGATIVE)
            .otherwise(MicroOp.WRITE_PC),
    ),
    Operation(
        0xb5, "BGZ i16",
        MicroOp.FETCH_L1,
        MicroOp.FETCH_L2,
        MicroOp(addressSource = ADR_LITERAL, action = WRITE_PC).condition(Condition.POSITIVE)
            .otherwise(MicroOp.WRITE_PC),
    ),
    Operation(
        0xb6, "BNP i16",
        MicroOp.FETCH_L1,
        MicroOp.FETCH_L2,
        MicroOp(addressSource = ADR_LITERAL, action = WRITE_PC).condition(Condition.NOT_POSITIVE)
            .otherwise(MicroOp.WRITE_PC),
    ),
    Operation(
        0xb7, "BNN i16",
        MicroOp.FETCH_L1,
        MicroOp.FETCH_L2,
        MicroOp(addressSource = ADR_LITERAL, action = WRITE_PC).condition(Condition.NOT_NEGATIVE)
            .otherwise(MicroOp.WRITE_PC),
    ),
    Operation(
        0xb8, "JMP i16",
        MicroOp.FETCH_L1,
        MicroOp.FETCH_L2,
        MicroOp(addressSource = ADR_LITERAL, action = WRITE_PC)
    ),
    Operation(
        0xba, "JSR i16",
        MicroOp.FETCH_L1,
        MicroOp.FETCH_L2,
        // write "return address" to PC to extract it later on
        MicroOp.WRITE_PC,
        MicroOp(addressSource = ADR_STACK_POINTER),
        MicroOp(READ_PC_HIGH, WRITE_MEMORY, ADR_INCREMENTER_DECREMENT),
        MicroOp(READ_PC_LOW, WRITE_MEMORY, ADR_INCREMENTER_DECREMENT, WRITE_STACK_POINTER),
        MicroOp(addressSource = ADR_LITERAL, action = WRITE_PC),
    ),
    Operation(
        0xbb, "RET",
        MicroOp(READ_MEMORY, WRITE_LITERAL_1, ADR_STACK_POINTER),
        MicroOp(READ_MEMORY, WRITE_LITERAL_2, ADR_INCREMENTER_INCREMENT),
        MicroOp(addressSource = ADR_INCREMENTER_INCREMENT, action = WRITE_STACK_POINTER),
        MicroOp(addressSource = ADR_LITERAL, action = WRITE_PC),
    ),
    Operation(
        0xf0, "INTERRUPT",
        MicroOp(addressSource = ADR_STACK_POINTER, action = DISABLE_INTERRUPTS),
        MicroOp(READ_REG_D, WRITE_MEMORY, ADR_INCREMENTER_DECREMENT),
        MicroOp(READ_REG_C, WRITE_MEMORY, ADR_INCREMENTER_DECREMENT),
        MicroOp(READ_REG_B, WRITE_MEMORY, ADR_INCREMENTER_DECREMENT),
        MicroOp(READ_REG_A, WRITE_MEMORY, ADR_INCREMENTER_DECREMENT),
        MicroOp(READ_PC_HIGH, WRITE_MEMORY, ADR_INCREMENTER_DECREMENT),
        MicroOp(READ_PC_LOW, WRITE_MEMORY, ADR_INCREMENTER_DECREMENT, WRITE_STACK_POINTER),
        MicroOp(READ_INTERRUPT_REGISTER_LOW, WRITE_LITERAL_1),
        MicroOp(READ_INTERRUPT_REGISTER_HIGH, WRITE_LITERAL_2),
        MicroOp(addressSource = ADR_LITERAL, action = WRITE_PC),
    ),
    Operation(
        0xf1, "EXINT",
        MicroOp(READ_MEMORY, WRITE_LITERAL_1, ADR_STACK_POINTER, ENABLE_INTERRUPTS),
        MicroOp(READ_MEMORY, WRITE_LITERAL_2, ADR_INCREMENTER_INCREMENT),
        MicroOp(READ_MEMORY, WRITE_REG_A, ADR_INCREMENTER_INCREMENT),
        MicroOp(READ_MEMORY, WRITE_REG_B, ADR_INCREMENTER_INCREMENT),
        MicroOp(READ_MEMORY, WRITE_REG_C, ADR_INCREMENTER_INCREMENT),
        MicroOp(READ_MEMORY, WRITE_REG_D, ADR_INCREMENTER_INCREMENT),
        MicroOp(addressSource = ADR_INCREMENTER_INCREMENT, action = WRITE_STACK_POINTER),
        MicroOp(addressSource = ADR_LITERAL, action = WRITE_PC),
    ),
    Operation(
        0xf2, "NOINT",
        MicroOp.WRITE_PC,
        MicroOp(action = DISABLE_INTERRUPTS),
    ),
    Operation(
        0xf3, "ENINT",
        MicroOp.WRITE_PC,
        MicroOp(action = ENABLE_INTERRUPTS),
    ),
    Operation(
        0xf4, "SIV",
        MicroOp.FETCH_L1,
        MicroOp.FETCH_L2,
        MicroOp.WRITE_PC,
        MicroOp(addressSource = ADR_LITERAL, action = WRITE_INTERRUPT_REGISTER),
    ),
    Operation(
        0xfc, "CFC",
        MicroOp.WRITE_PC,
        // read AND from ALU to get a '0' into the carry flag
        MicroOp(READ_ALU, WRITE_LITERAL_2, action = AND),
    ),
    Operation(
        0xfd, "CFS",
        // move 0xff into ALU
        MicroOp(dataTarget = WRITE_ALU_INPUT, action = WRITE_PC),
        // shift to get a '1' into the carry flag.
        MicroOp(READ_ALU, WRITE_LITERAL_2, action = SHIFT_LEFT),
    ),
    Operation(0xfe, "NOP", MicroOp.WRITE_PC),
    Operation(
        0xff, "HLT", MicroOp(action = SequencerCommand.HALT)
    ),
)
