ksmonkey123/8bit_computer/(commit log)

2024-12-15 emulator: add helper method to DataBus for generating a signal wire
2024-12-16 emulator: introduce wiring package
2024-12-16 emulator: octal driver impl
2024-12-23 emulator: add roll unit
    [roll_unit_test.csv]
2024-12-24 emulator: add sequencer. renamed 'components' to 'modules'
    [sequencer_update_circuit_test.csv]
2024-12-30 Sequencer Schematic
    [sequencer.kicad_pcb, sequencer.kicad_sch]
2024-12-30 emulator: add signal choice "IC" implementing 1-bit ternary z?y:x
    [signal_choice_test.csv]
2024-12-30 emulator: add math unit
    [math_unit_test.csv]
2024-12-30 emulator: alu control circuit
2024-12-31 emulator: add ALU
    [ALU_test.csv]
2025-01-06 emulator: 16-bit bus driver
2025-01-14 move cycle flag to address pin 12
2025-01-14 ALU rework
    [ALU_test.csv, math_unit_test.csv, roll_unit_test.csv]
2025-01-20 rename emulator module to hardware
    [ALU_test.csv, math_unit_test.csv, roll_unit_test.csv, sequencer_update_circuit_test.csv, signal_choice_test.csv]
2025-01-20 create new emulator and assembler modules
2025-01-22 rework of ALU structure. start new instruction set. start single-command tests
    [InstructionSet.kt]
2025-01-23 add tests for 0x10:1f commands (including implementation and instruction set fixes)
    [InstructionSet.kt]
2025-01-24 add tests for range 0x40:4f (and fixes in inc / dec microcode)
    [InstructionSet.kt]
2025-01-24 fix spring dependencies in microcode building invalid library JAR
2025-01-27 add branching commands
    [branching_commands.csv]
2025-01-28 start assembler grammar
2025-02-01 conversion from parsetree to AST for vars and code. data still missing
    [Main.kt]
2025-02-02 assembler rework
2025-02-03 swap command with memory
    [InstructionSet.kt]
2025-02-05 assembler implementation. TODO: file I/O and CLI
2025-02-06 assembler cli
2025-02-06 first emulator tests including assembler
2025-02-12 rework architecture and microcode to get rid of registers with multiple write sources.
    Each register is now either entirely written to via the address or the data bus
    [InstructionSet.kt]
2025-02-17 assembler testing
2025-02-17 improved assembler
2025-02-17 pc-01 rev A: dual 8-bit register unit
    [dual_8bit_register.kicad_pcb, dual_8bit_register.kicad_sch, sequencer.kicad_pcb, sequencer.kicad_sch]
2025-02-17 pc-02 rev A: 16bit register unit for PC and SP
    [16bit_register.kicad_pcb, 16bit_register.kicad_sch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]
2025-02-18 pc-03: increment unit rev a
    [adder.kicad_sch, increment_register.kicad_pcb, increment_register.kicad_sch]
2025-02-19 Instruction set rework: Carry flag is now a part of the ALU and only ever updated on ALU read. This allows for local handling of this flag. (this includes the removal of carry-flag initialisation dur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
    [InstructionSet.kt]
2025-02-20 pc-04: alu backplane
    [pc-04_alu_backplane.kicad_pcb, pc-04_alu_backplane.kicad_sch]
2025-02-20 pcb template
    [memory_stack_template.kicad_pcb, memory_stack_template.kicad_sch]
2025-02-20 Kicad upgrade to 9.0
    [16bit_register.kicad_pcb, 16bit_register.kicad_sch, adder.kicad_sch, increment_register.kicad_pcb, increment_register.kicad_sch, memory_stack_template.kicad_sch, pc-04_alu_backplane.kicad_pcb, pc-04_alu_backplane.kicad_sch]
2025-02-20 starting with adder
    [alu_adder.kicad_pcb, alu_adder.kicad_sch]
2025-02-21 pc-04: add missing pull-up resistors
    [pc-04_alu_backplane.kicad_pcb, pc-04_alu_backplane.kicad_sch]
2025-02-21 pc-05: ALU adder prototype
    [alu_adder.kicad_pcb, alu_adder.kicad_sch]
2025-02-24 pc-05: polishing of adder circuit
    [alu_adder.kicad_pcb, alu_adder.kicad_sch, xor.kicad_sch]
2025-02-24 pc-06: alu logic unit
    [alu_logic.kicad_pcb, alu_logic.kicad_sch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]
2025-02-25 pc-07: ram unit
    [ram_unit.kicad_pcb, ram_unit.kicad_sch]
2025-02-26 pc-08: decoder unit
    [command_decoder.kicad_pcb, command_decoder.kicad_sch, ram_unit.kicad_pcb, ram_unit.kicad_sch]
2025-02-26 add pull-up resistor network to command decoder
    [command_decoder.kicad_pcb, command_decoder.kicad_sch]
2025-02-26 pc08: finishing touches and interconnects
    [command_decoder.kicad_pcb, command_decoder.kicad_sch]
2025-02-27 bus spy, mock orchestrator & cleanup
    [bus_spy.kicad_pcb, bus_spy.kicad_sch, command_decoder.kicad_pcb, mock_orchestrator.kicad_pcb, mock_orchestrator.kicad_sch, orchestrator_interconnect.kicad_pcb, ram_unit.kicad_pcb]
2025-02-28 add filter and decoupling capacitors to all boards
    [16bit_register.kicad_pcb, 16bit_register.kicad_sch, alu_adder.kicad_pcb, alu_adder.kicad_sch, alu_logic.kicad_pcb, alu_logic.kicad_sch, bus_spy.kicad_pcb, bus_spy.kicad_sch]
2025-02-28 final touches, pcb ordering
    [16bit_register.kicad_pcb, alu_adder.kicad_pcb, alu_logic.kicad_pcb, bus_spy.kicad_pcb, command_decoder.kicad_pcb, increment_register.kicad_pcb, mock_orchestrator.kicad_pcb, orchestrator_interconnect.kicad_pcb]
2025-03-04 pc-08 rework
    [command_decoder.kicad_pcb]
2025-03-11 add logisim simulation
    [pc_simulation.circ]
2025-10-24 PC-08: fix incorrect dsrc silkscreen
    pin labels 12/13 were inverted.
    [command_decoder.kicad_pcb]
2025-10-24 PC-03: fix incrementer unit
    * adders are TTL, the weak pull-down on the `inc_dec` signal was not enough to drive the 8 directly connected adder pins correctly. Fixed through the introduction of a non-inverting buffer on that signal to produce hard signals in both directions.
    * incorrect logic caused decrement mode (INCR-1) to calculate (INCR-1+1) by mistake. reworked logic by replacing the old CD4011 NAND by a CD4070 XOR.
    [adder.kicad_sch, increment_register.kicad_pcb, increment_register.kicad_sch]
2025-10-28 pc-03: add double buffering to incrementer unit
    This ensures stable data from the incrementer.
    Previously, the published address would change at the start of the write cycle.
    With the double buffering introduced, the current value of the address bus is latched into the first register at the start of the write cycle and pushed to the second register at the end of the write cycle.
    This way the latched address is only seen by the incrementer at the start of the next cycle, ensuring a stable address bus state during the entire program step.
    [adder.kicad_sch, increment_register.kicad_pcb, increment_register.kicad_sch, pc_simulation.circ]
2025-10-28 PC-07: reworked RAM unit: falling edge of !mem_write signal is converted to a low-pulse.
    In experiments, 2 ceramic caps of 100nF each in series, and 2 resistors of 150 ohms yielded pulse widths of a just a few microseconds at clock rates of up to 25 kHz.
    [pc_simulation.circ, ram_unit.kicad_pcb, ram_unit.kicad_sch]
2025-10-28 pc-03: fix bad revision information on PCB layout sheet
    [increment_register.kicad_pcb]
2025-10-28 change simulation: double buffering on IR prevents potential issues on microcode ROM transitions at start of write cycle. microcode ROM addressing now only changes at the end of a cycle.
    [pc_simulation.circ]
2025-10-28 simulation: add double buffering to flag signals to the microcode ROM. this ensures no ROM addressing transitions during a write cycle.
    [pc_simulation.circ]
2025-10-28 rename instruction name map
    [instruction set map.xlsx]
2025-10-29 documentation upgrade
    [instruction set map.xlsx, pc_simulation.circ]
2025-10-29 fix assembler not working when `.vars` section is missing. (simple programs may not need it)
2025-10-29 migrate to a fully little-endian architecture. (inverts all 16-bit literals in assembled programs and inverts the fetch order of L1 and L2)
    [ArithmeticCommandsTest.kt]
2025-10-29 convert simulation to little-endian microcode
    [pc_simulation.circ]
2025-10-29 load improved microcode into pc simulation.
    the same fibonacci program ran ~12% faster.
    [pc_simulation.circ]
2025-11-01 add IPC write to command decoder and 16-bit control bus.
    This signal may be used in the future for interrupt handling.
    [command_decoder.kicad_pcb, pc_simulation.circ]
2025-11-02 start concept on interrupts
    [instruction set map.xlsx, pc_simulation.circ]
2025-11-11 modify assembler to produce variable size programs
2025-11-11 update documentation and update PCBs for interrupts
    [command_decoder.kicad_pcb, command_decoder.kicad_sch, mock_orchestrator.kicad_pcb]
2025-11-11 add interrupt support in microcode and emulator
2025-11-11 add interrupt support to assembler. TODO: rework assembler & syntax
2025-11-12 simulation and documentation update for interrupts
    [instruction set map.xlsx, pc_simulation.circ]
2025-11-20 add sequencer
    [interrupt_unit.kicad_sch, orchestrator_stack_template.kicad_pcb, orchestrator_stack_template.kicad_sch, pc_simulation.circ, register_unit.kicad_sch, sequencer.kicad_pcb, sequencer.kicad_sch, sequencing_unit.kicad_sch]
2025-11-21 microcode pcb
    [microcode.kicad_pcb, microcode.kicad_sch, orchestrator_stack_template.kicad_sch]
2025-11-22 pcb design
    [16bit_register.kicad_pcb, 16bit_register.kicad_sch, command_decoder.kicad_pcb, increment_register.kicad_pcb, microcode.kicad_pcb, microcode.kicad_sch, ram_unit.kicad_pcb, ram_unit.kicad_sch]
2025-11-23 reworking sequencer PCB
    [interrupt_unit.kicad_sch, register_unit.kicad_sch, sequencer.kicad_pcb, sequencer.kicad_sch, sequencer_test.circ, sequencing_unit.kicad_sch]
2025-11-24 finalize rev. a of pc-12
    [interrupt_unit.kicad_sch, sequencer.kicad_pcb]
2026-06-25 convert assembler to output hex files
2026-06-25 some sonar cleanups
